kanavkin/Tuareg_hw/tndf13/schematics/IMG_4141.JPG

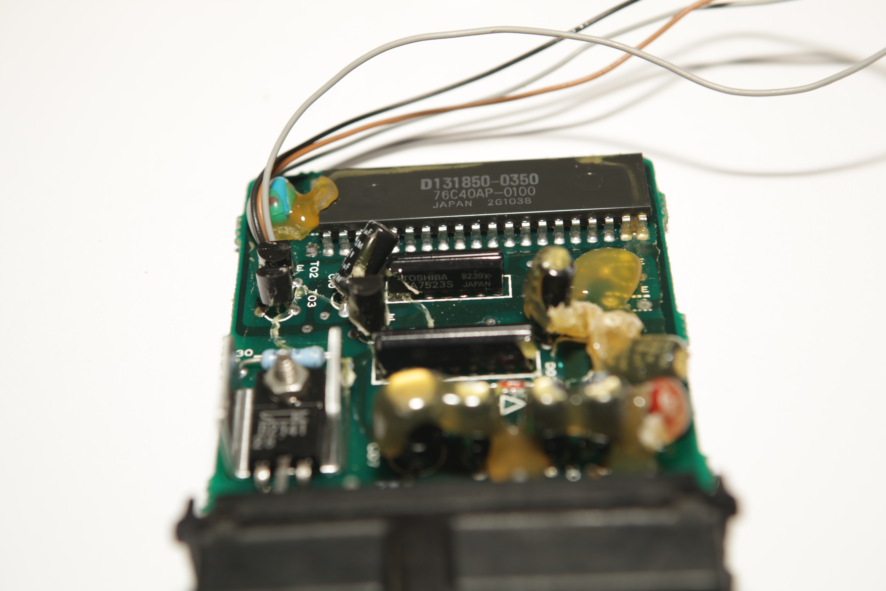
tndf13/schematics/IMG_4141.JPG
