kanavkin/Tuareg_hw/output/3d/bot.jpg

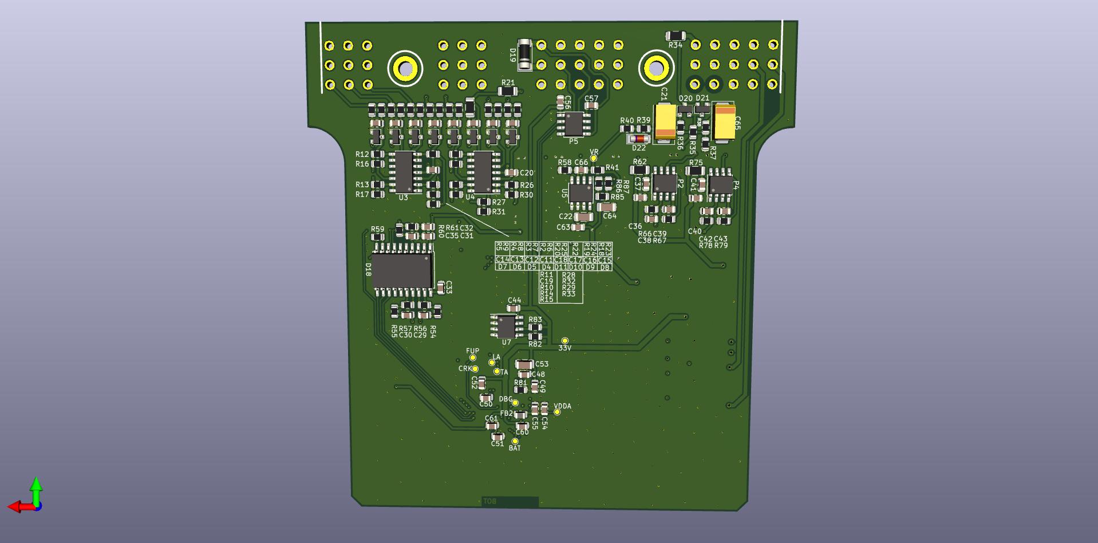
output/3d/bot.jpg
