kanavkin/Tuareg_hw/datasheets/2- and 4-Layer Design Rules | AISLER_files/design_rules.png

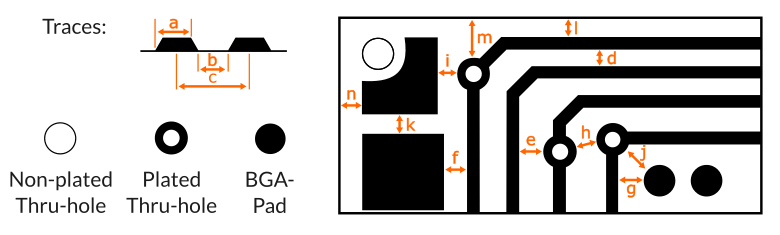
datasheets/2- and 4-Layer Design Rules | AISLER_files/design_rules.png
