kanavkin/Tuareg_hw/output/3d/top.jpeg

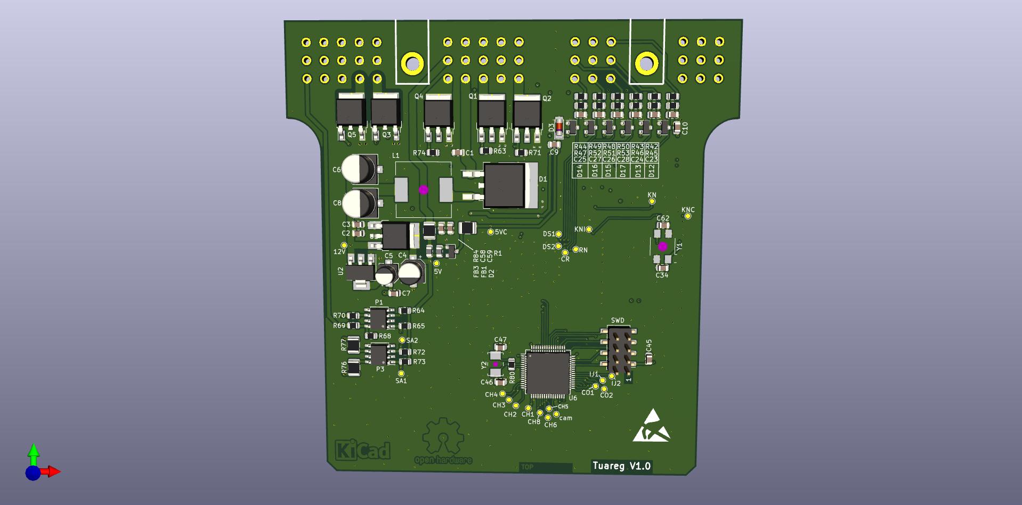
output/3d/top.jpeg
