kanavkin/Tuareg_hw/tndf13/coil_vs_output_signal_2ms.png

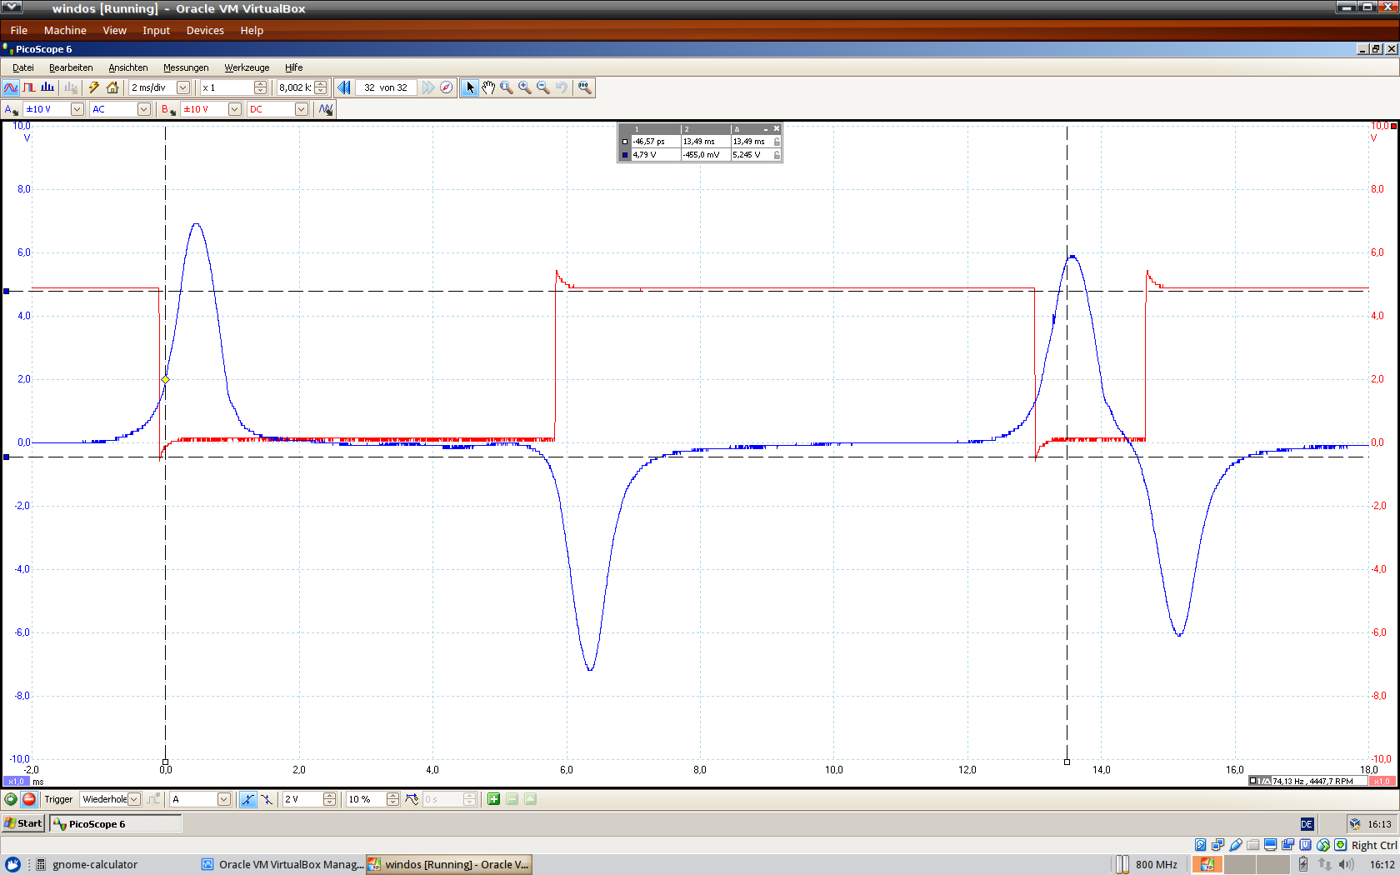
tndf13/coil_vs_output_signal_2ms.png
