kanavkin/Tuareg_hw/tndf13/crank_vs_coil_6300rpm_2ms.jpg

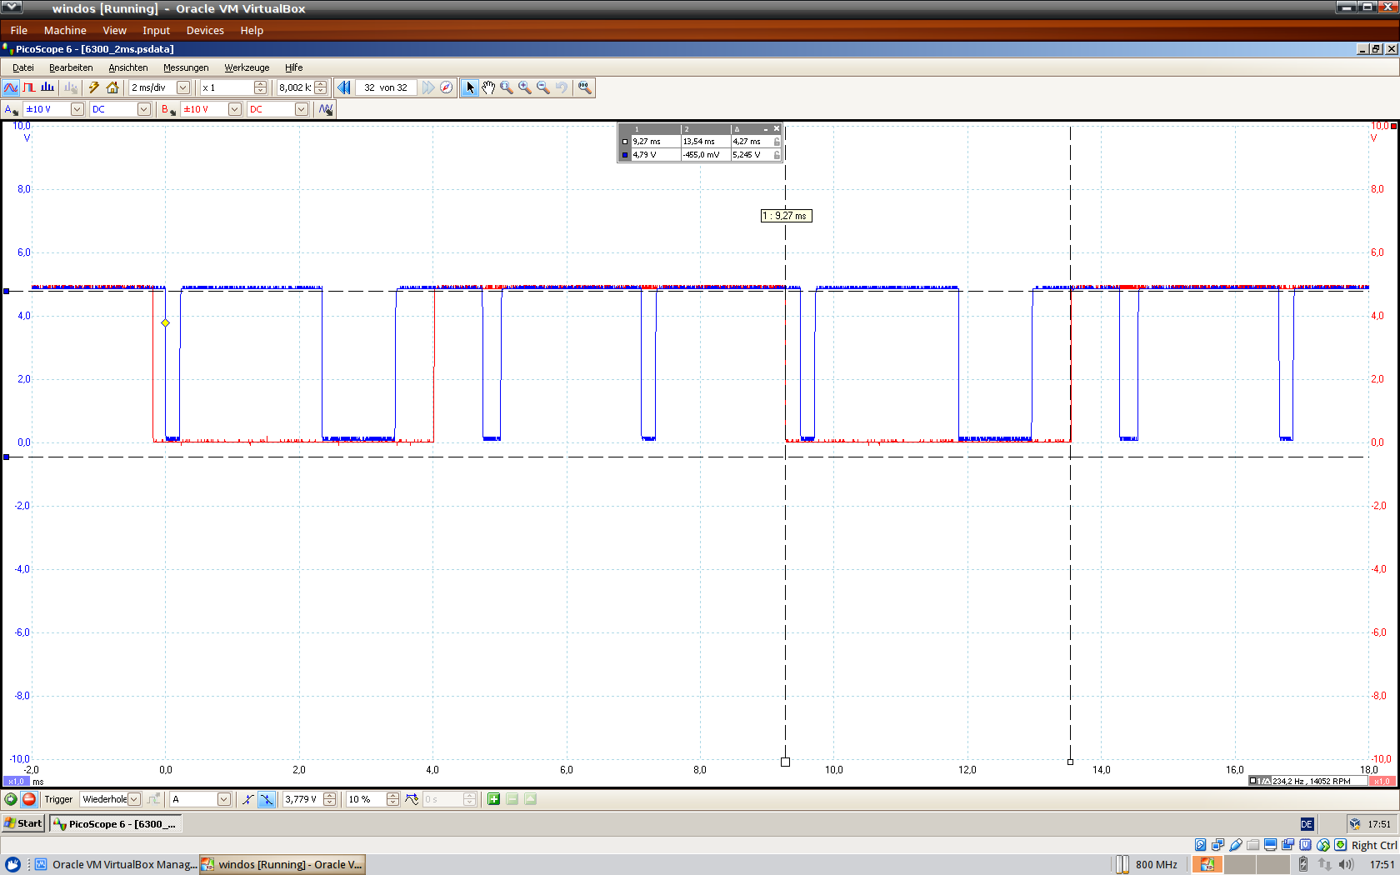
tndf13/crank_vs_coil_6300rpm_2ms.jpg
