kanavkin/Tuareg_hw/tndf13/geometry.png

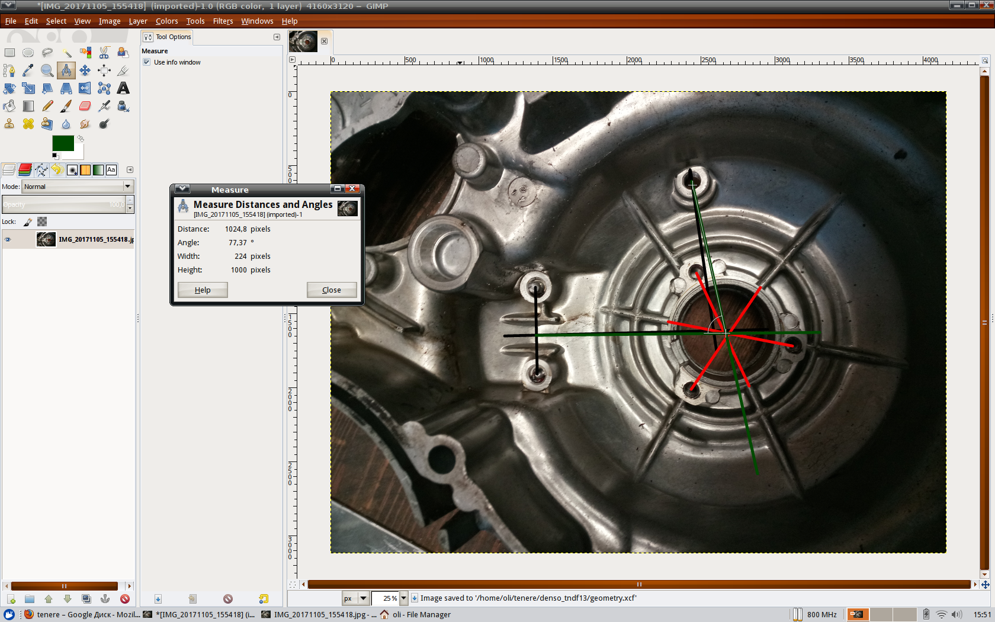
tndf13/geometry.png
