kanavkin/Tuareg_hw/tndf13/spark_vs_transistor.png

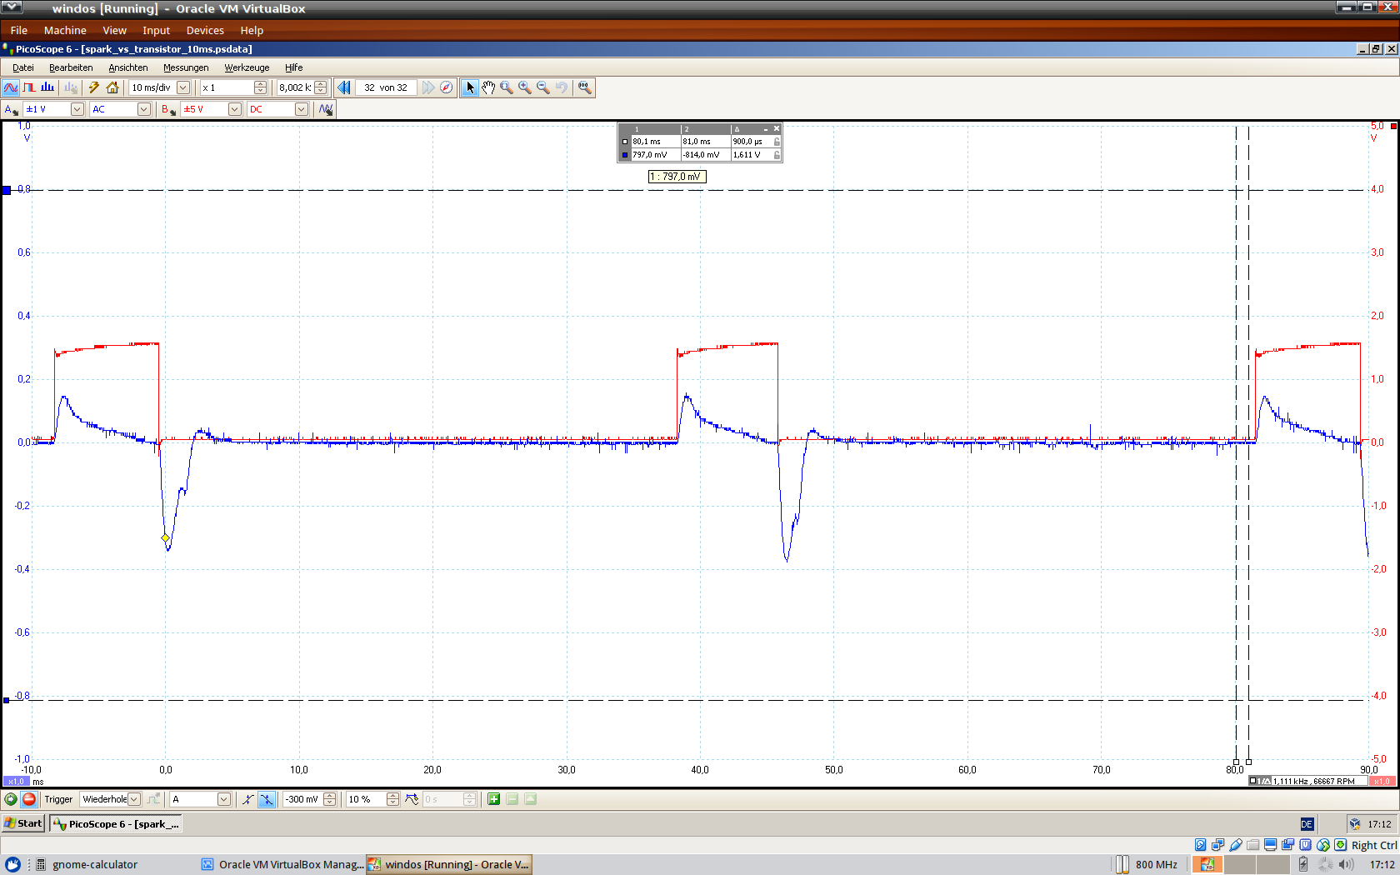
tndf13/spark_vs_transistor.png
