kanavkin/Tuareg_hw/tndf13/timing_advance.png

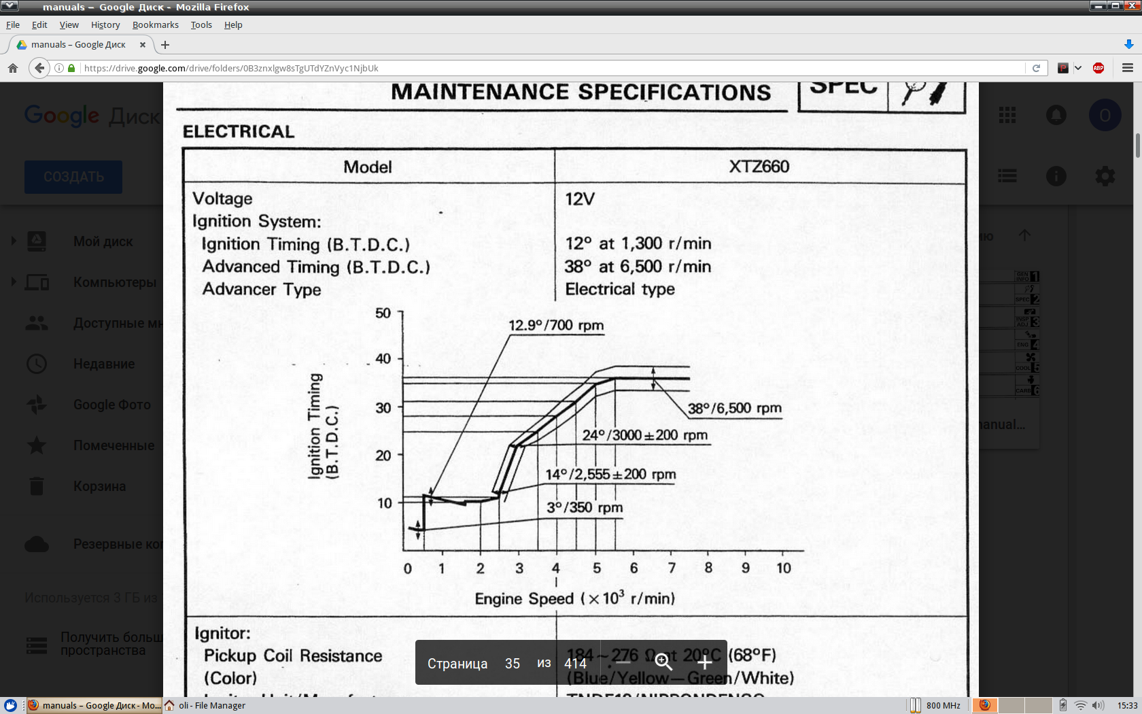
tndf13/timing_advance.png
