kanavkin/Tuareg_hw/tndf13/coil_vs_output_signal_2ms_measure_highrev_5.png

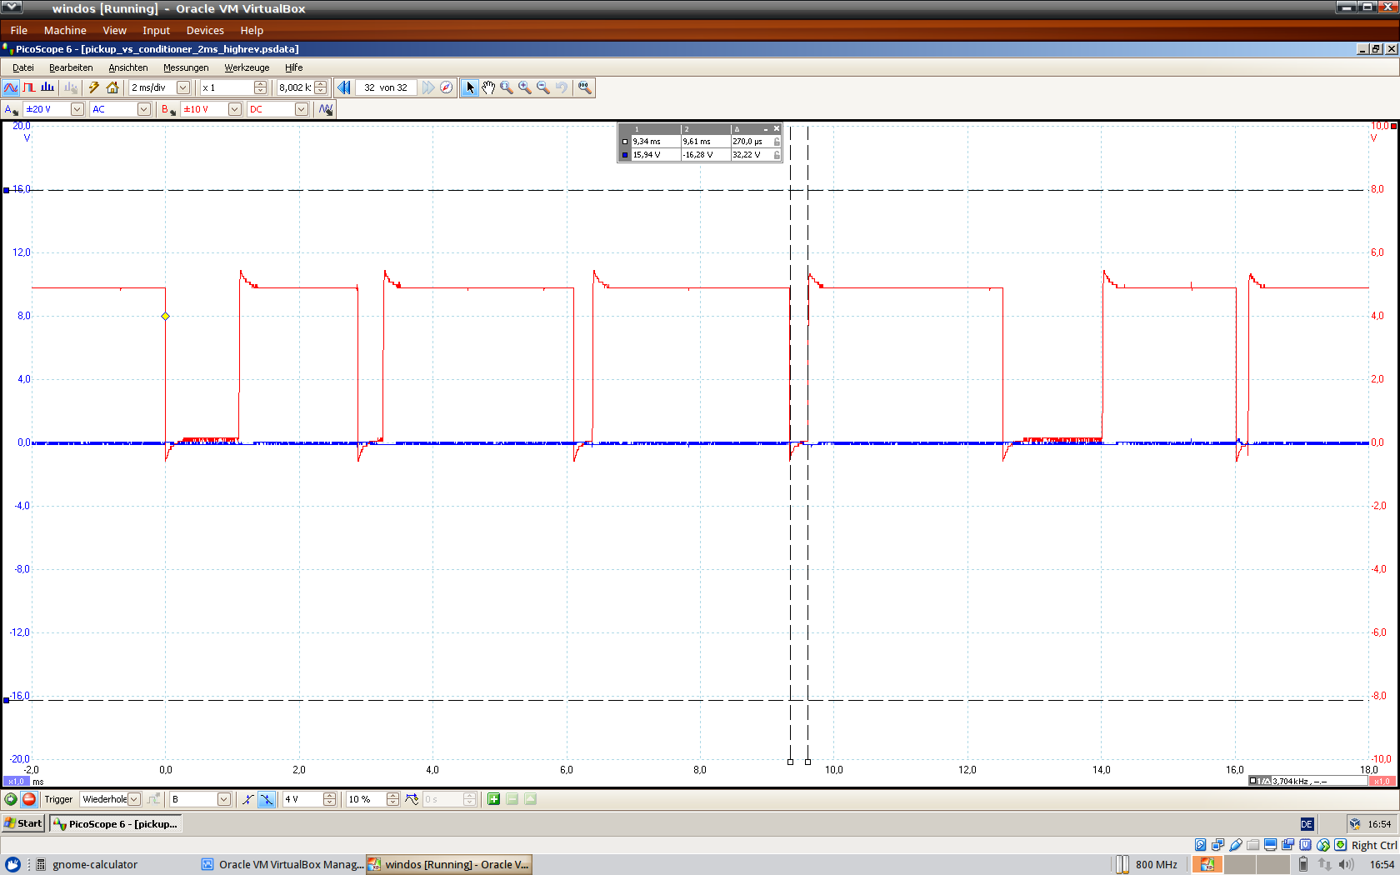
tndf13/coil_vs_output_signal_2ms_measure_highrev_5.png
