kanavkin/Tuareg_hw/tndf13/coil_vs_output_signal_5ms_measure_2.png

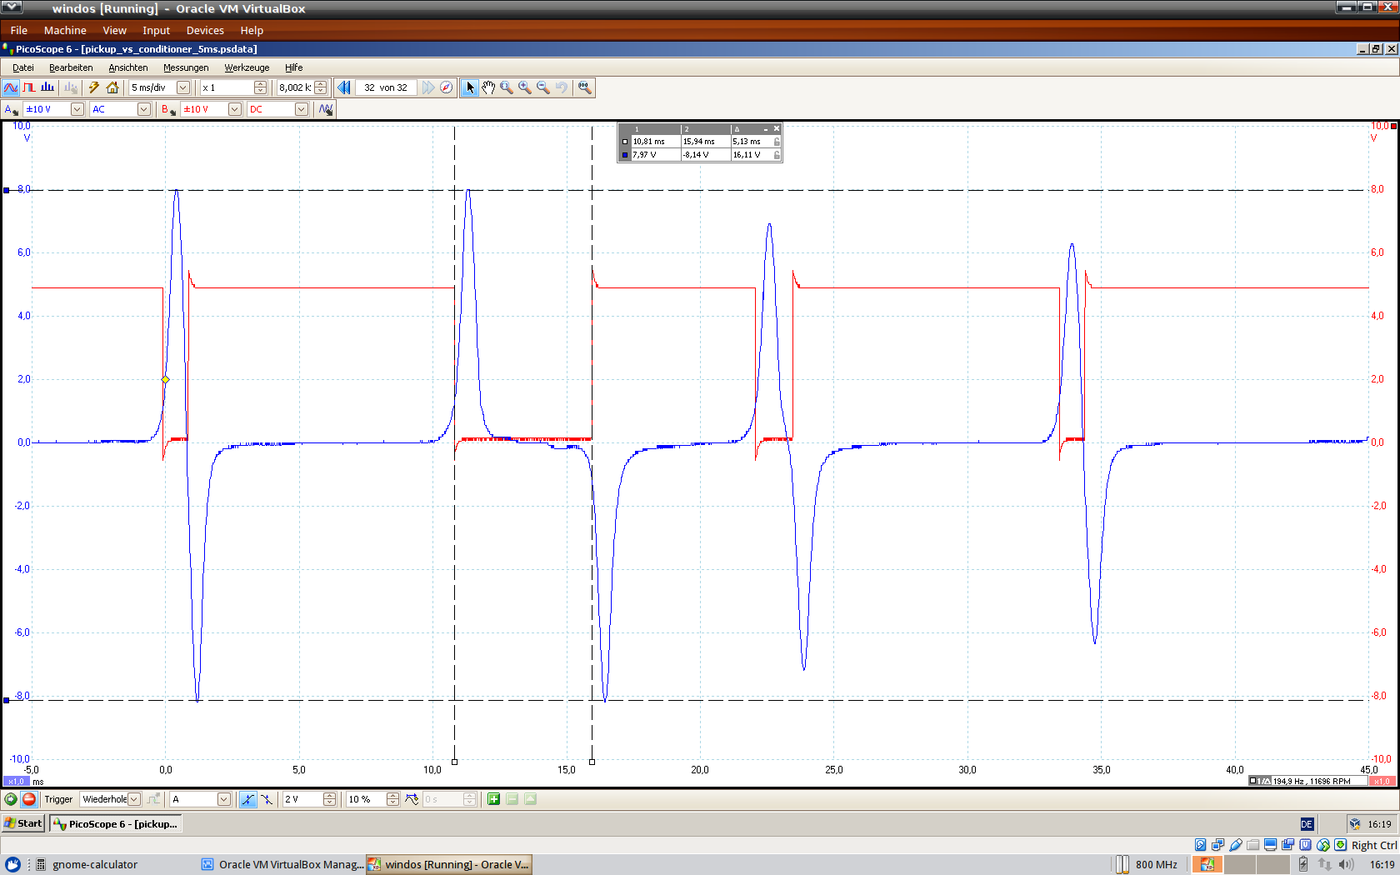
tndf13/coil_vs_output_signal_5ms_measure_2.png
