kanavkin/Tuareg_hw/tndf13/coil_vs_output_signal_5ms_measure_4.png

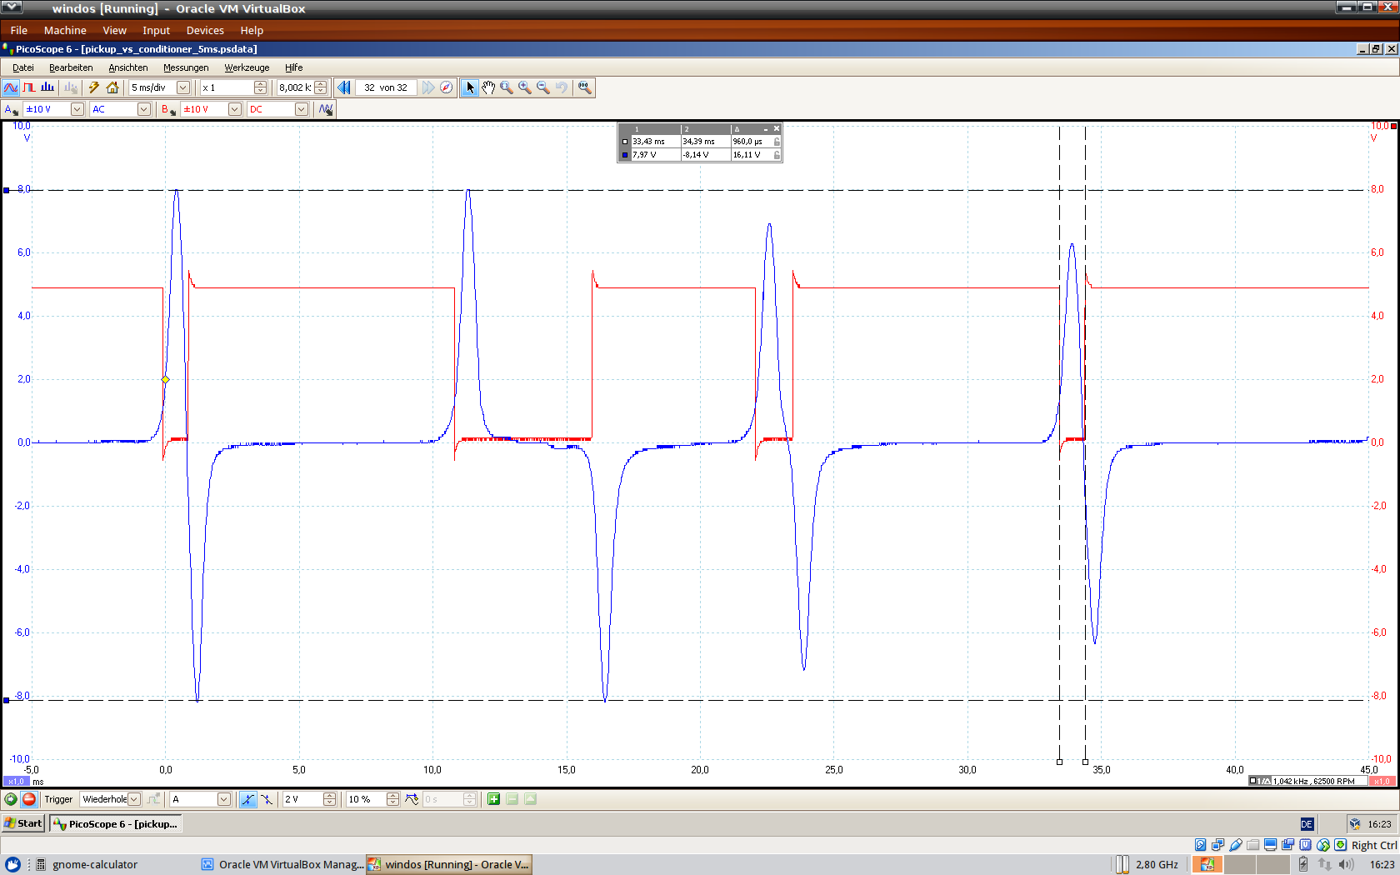
tndf13/coil_vs_output_signal_5ms_measure_4.png
