kanavkin/Tuareg_hw/tndf13/coil_vs_output_signal_10ms_measure_3.png

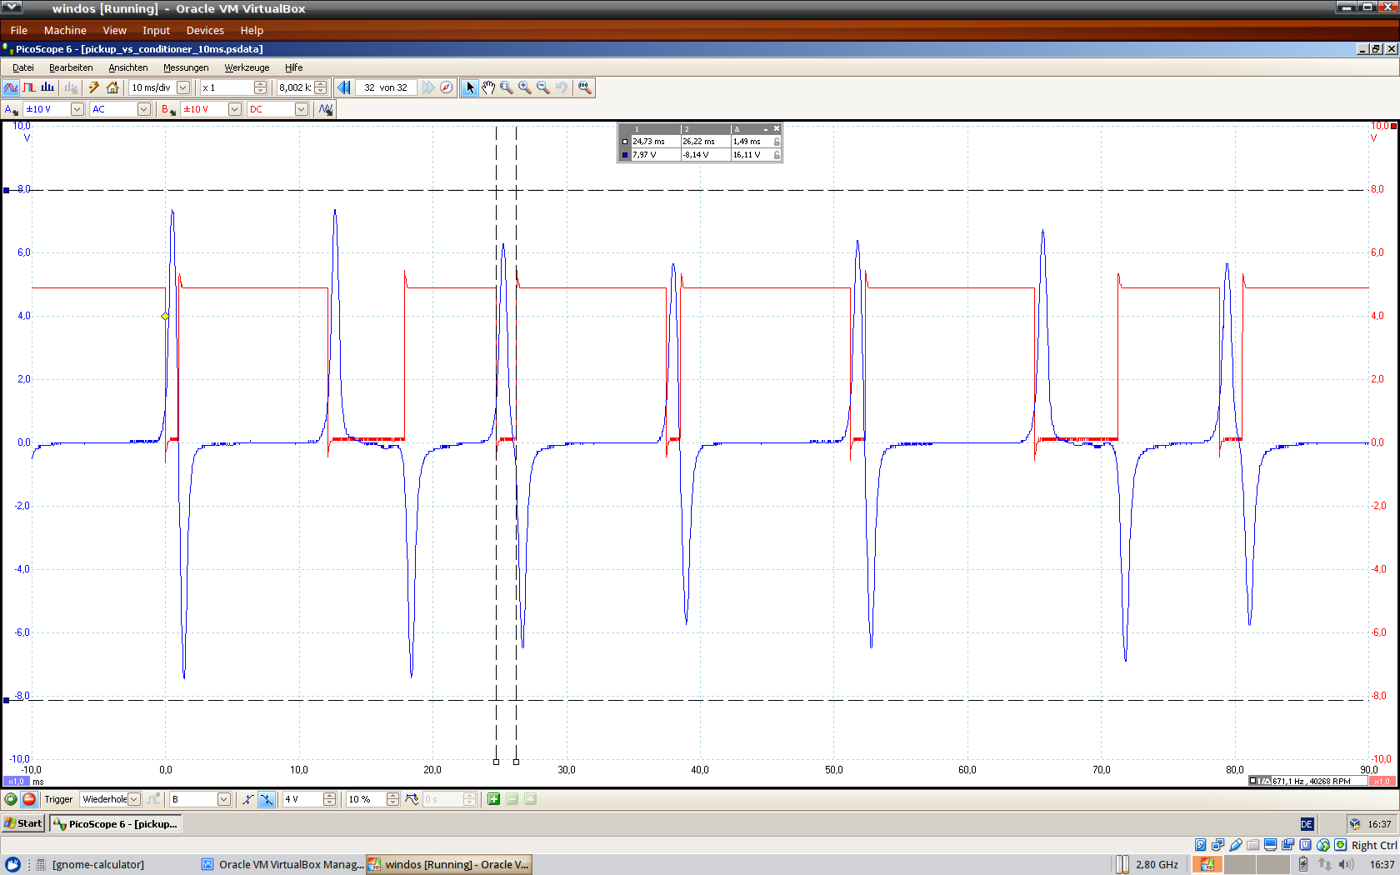
tndf13/coil_vs_output_signal_10ms_measure_3.png
