kanavkin/Tuareg_hw/tndf13/conditioner_vs_transistor_2ms_measure_2.png

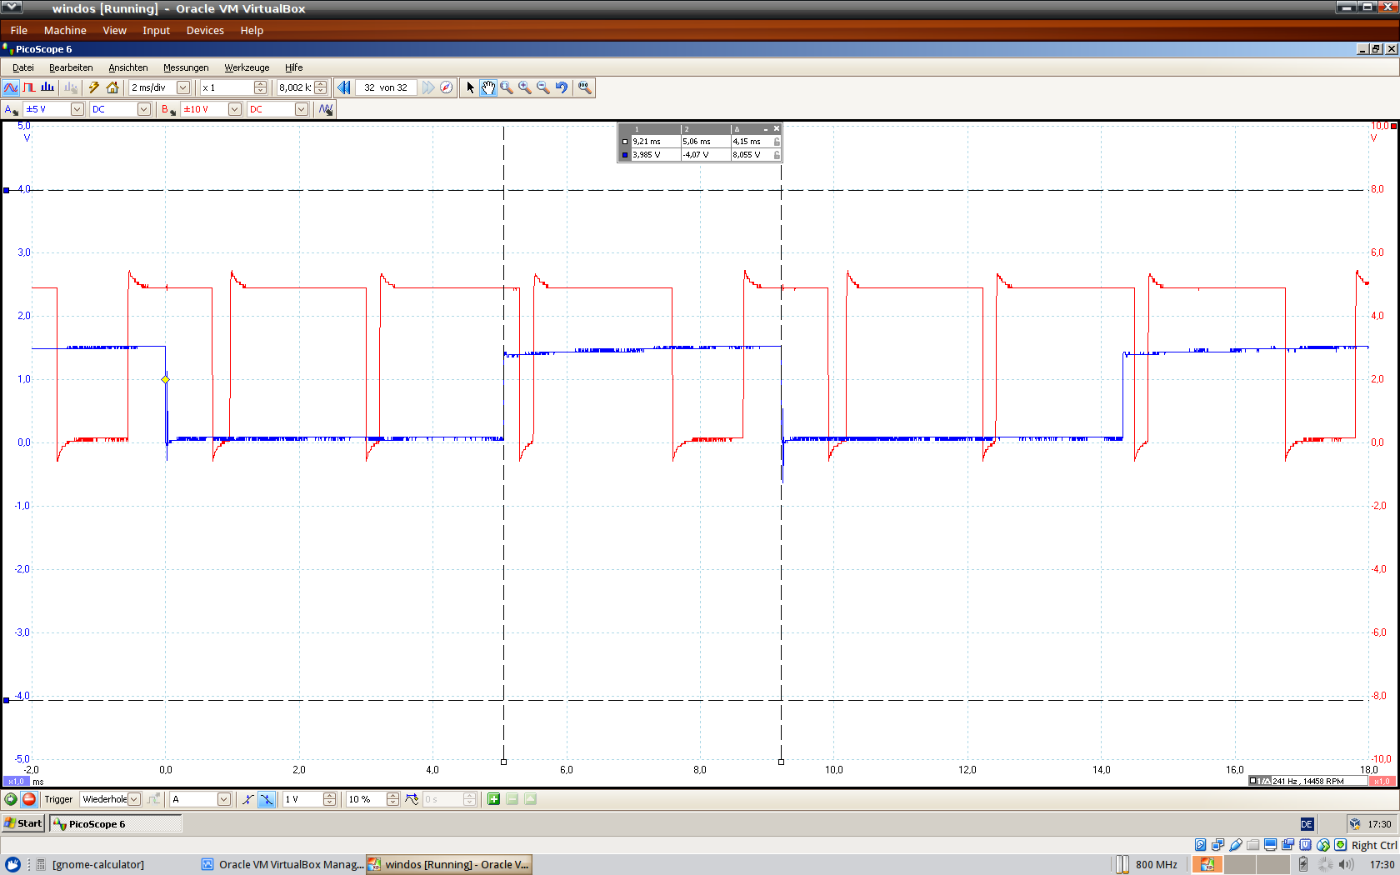
tndf13/conditioner_vs_transistor_2ms_measure_2.png
