kanavkin/Tuareg_hw/tndf13/conditioner_vs_transistor_5ms_measure.png

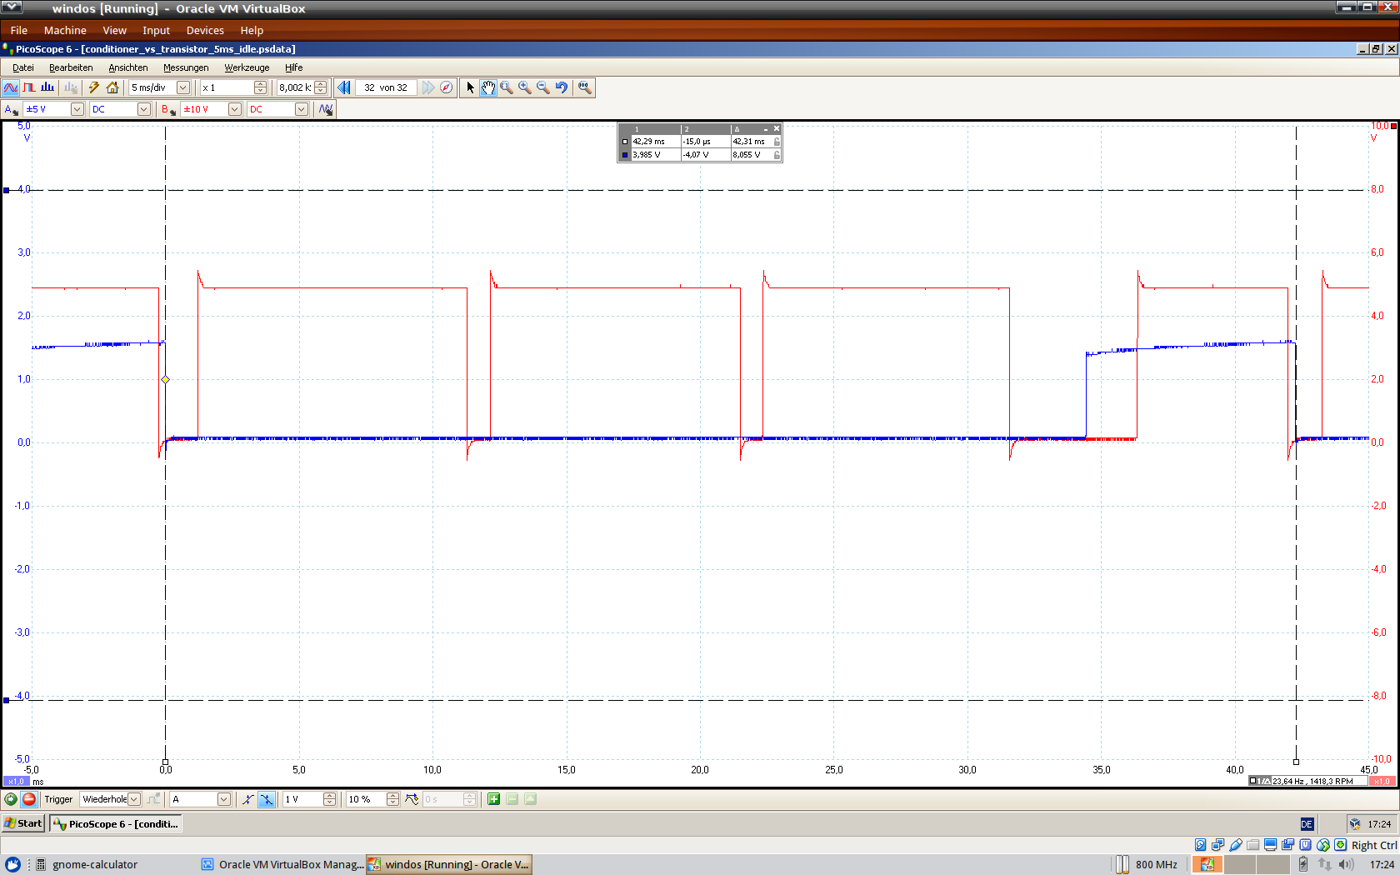
tndf13/conditioner_vs_transistor_5ms_measure.png
