kanavkin/Tuareg_hw/tndf13/measurement_orig/diode_idle.png

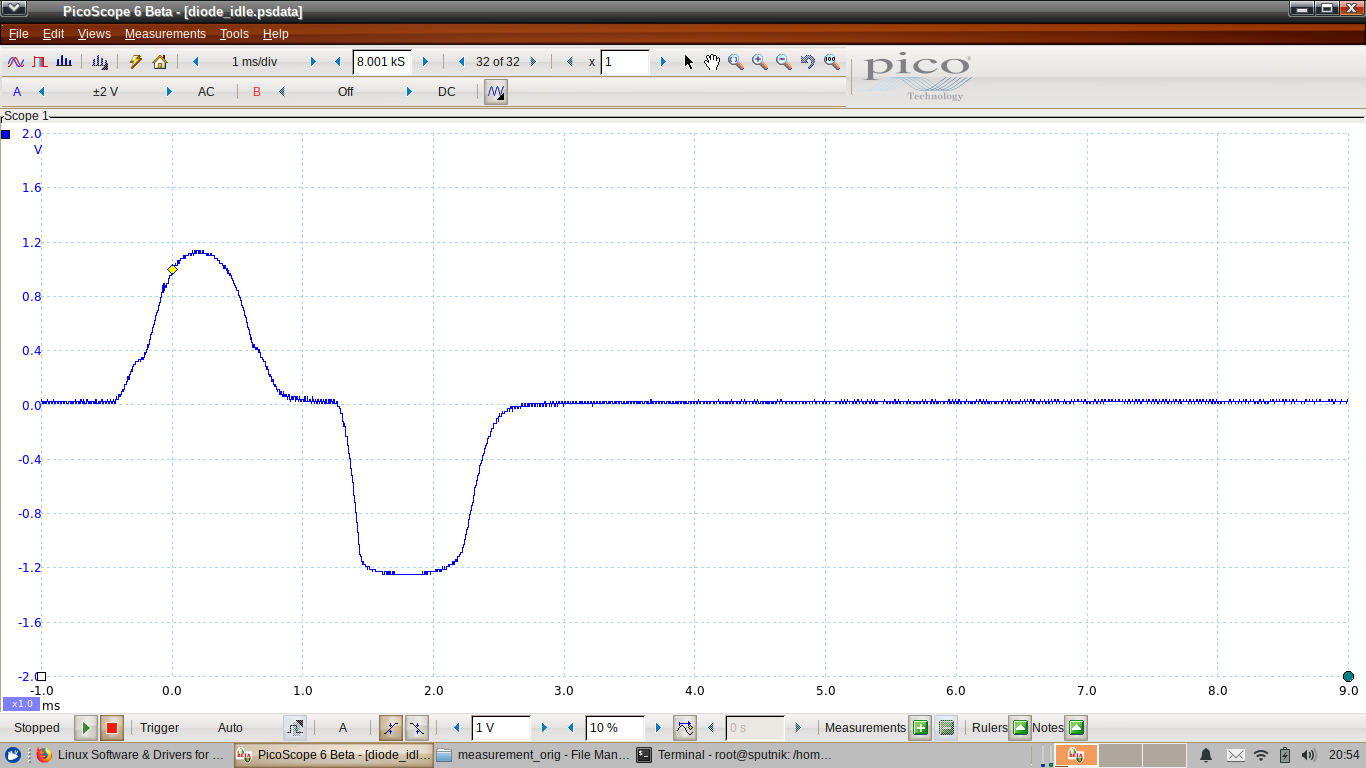
tndf13/measurement_orig/diode_idle.png
