kanavkin/Tuareg_hw/tndf13/measurement_orig/diode_idle_dcmode.png

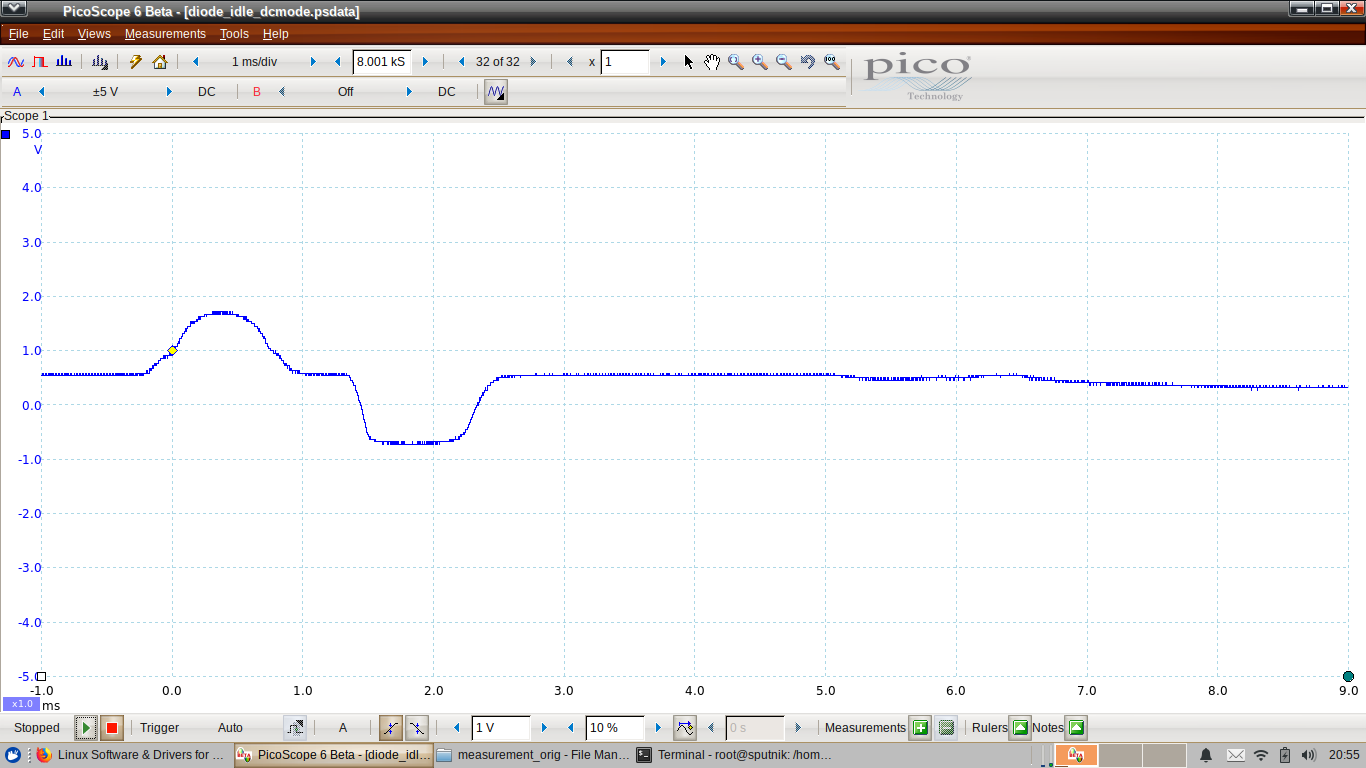
tndf13/measurement_orig/diode_idle_dcmode.png
