kanavkin/Tuareg_hw/tndf13/measurement_orig/pickup_idle.png

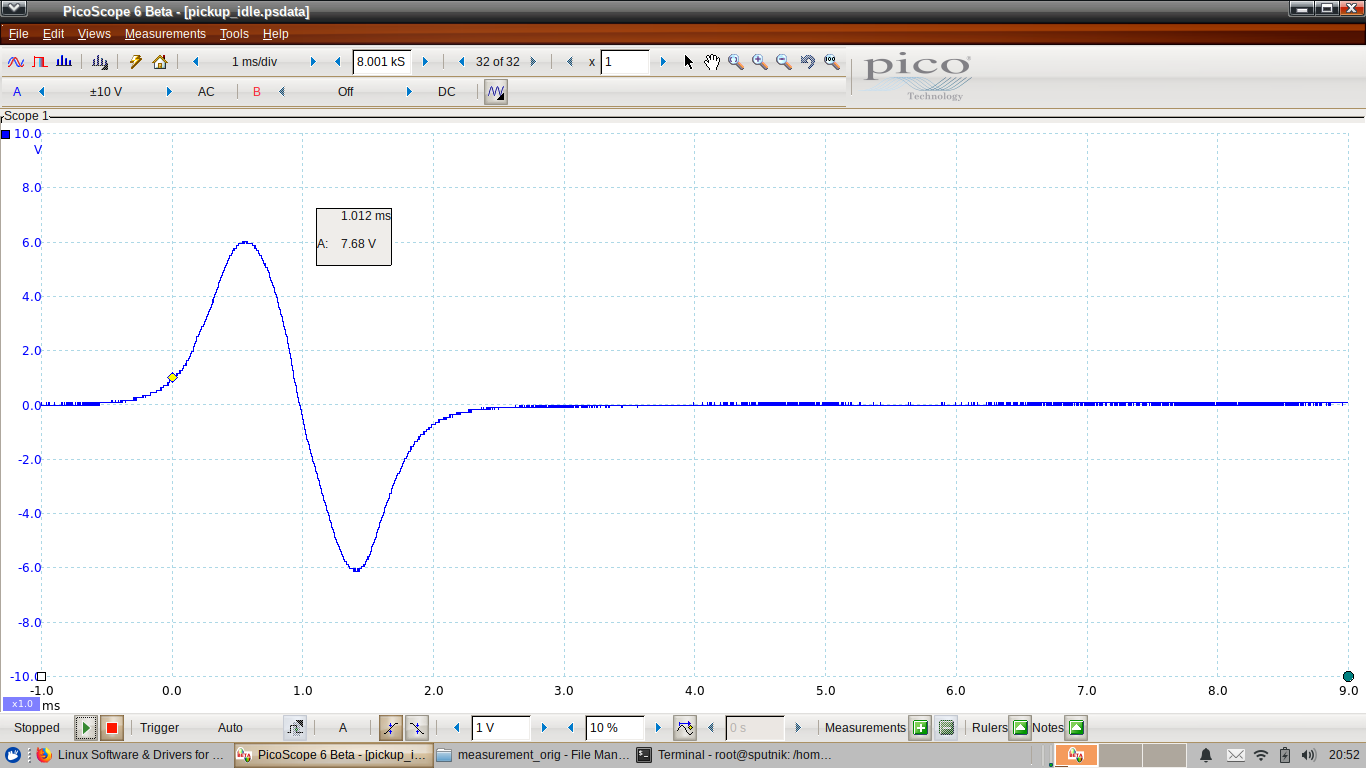
tndf13/measurement_orig/pickup_idle.png
