kanavkin/Tuareg_hw/tndf13/measurement_orig/u-c03c02-junction_idle.png

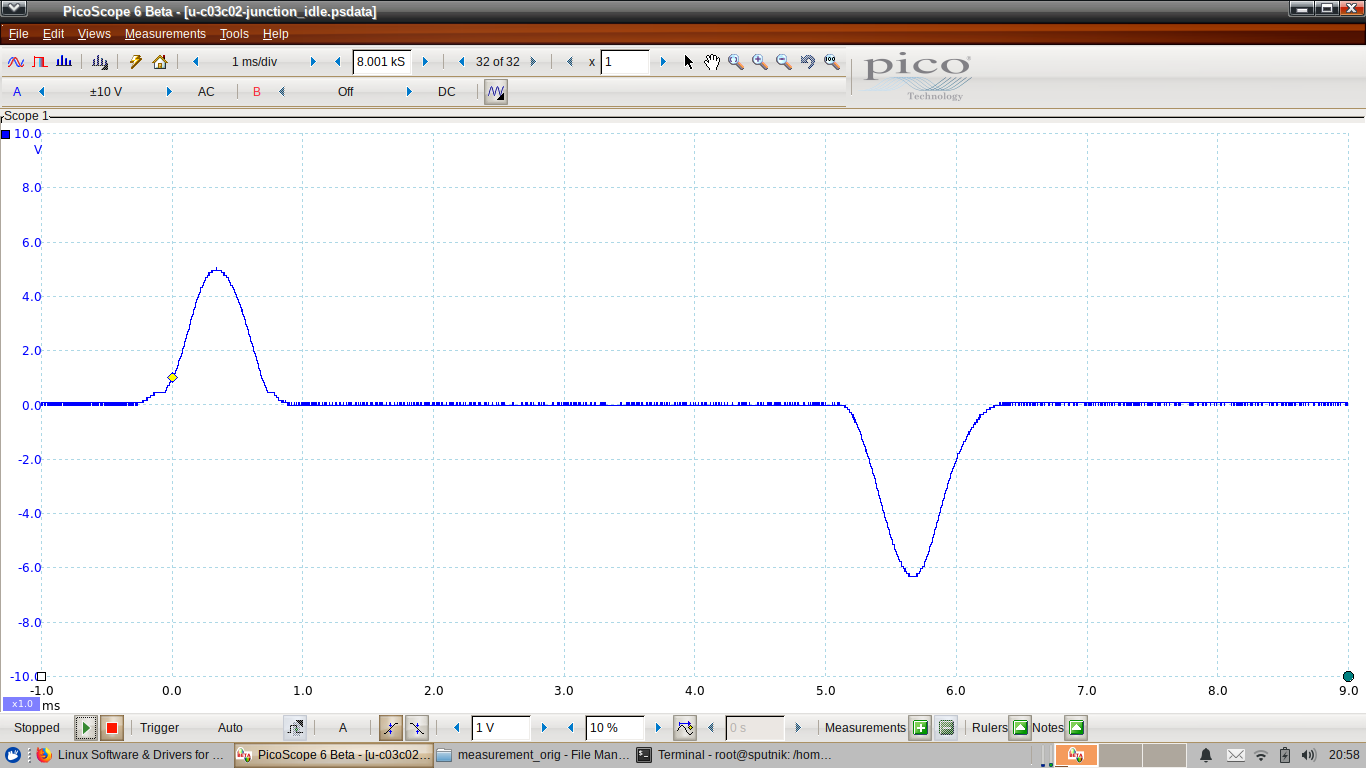
tndf13/measurement_orig/u-c03c02-junction_idle.png
