kanavkin/Tuareg_hw/tndf13/measurement_orig/u-r02_idle.png

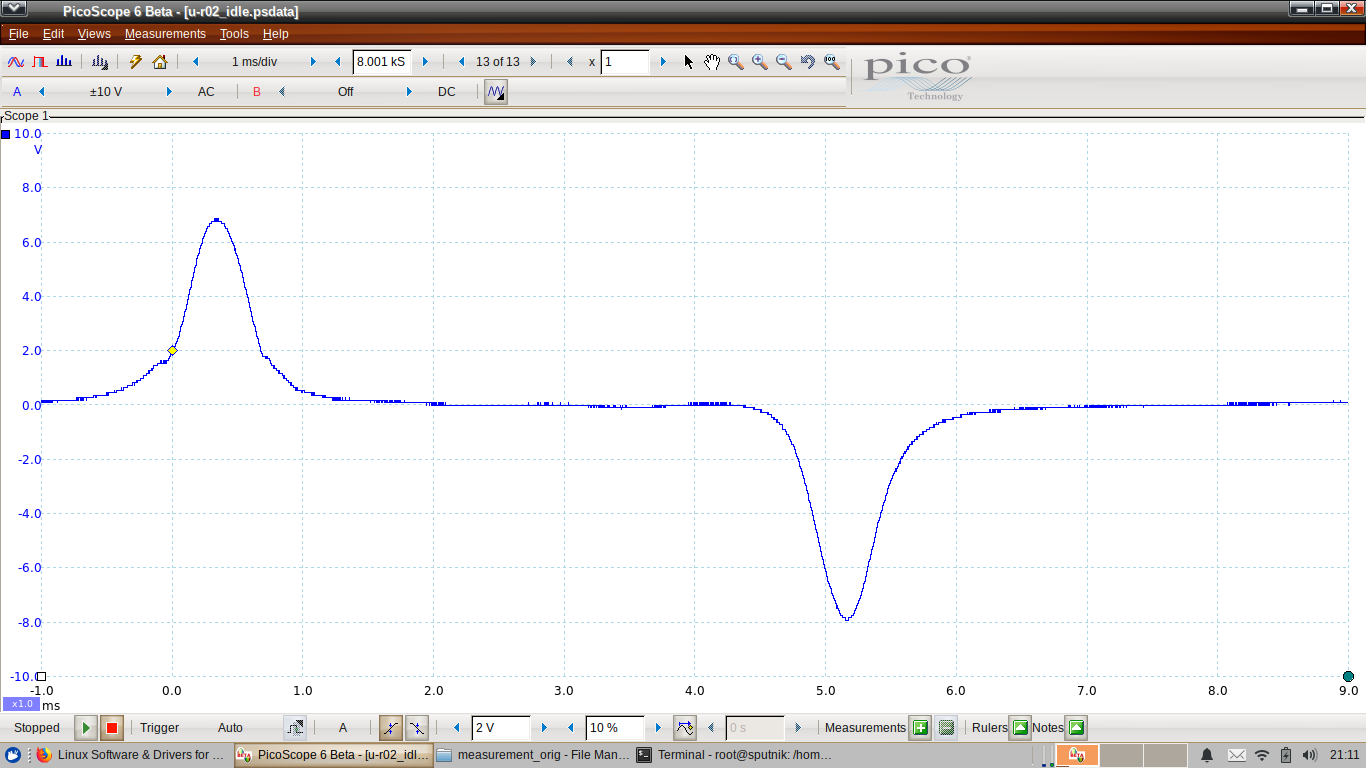
tndf13/measurement_orig/u-r02_idle.png
