kanavkin/Tuareg_hw/tndf13/spark_vs_transistor_10ms_measure_4.png

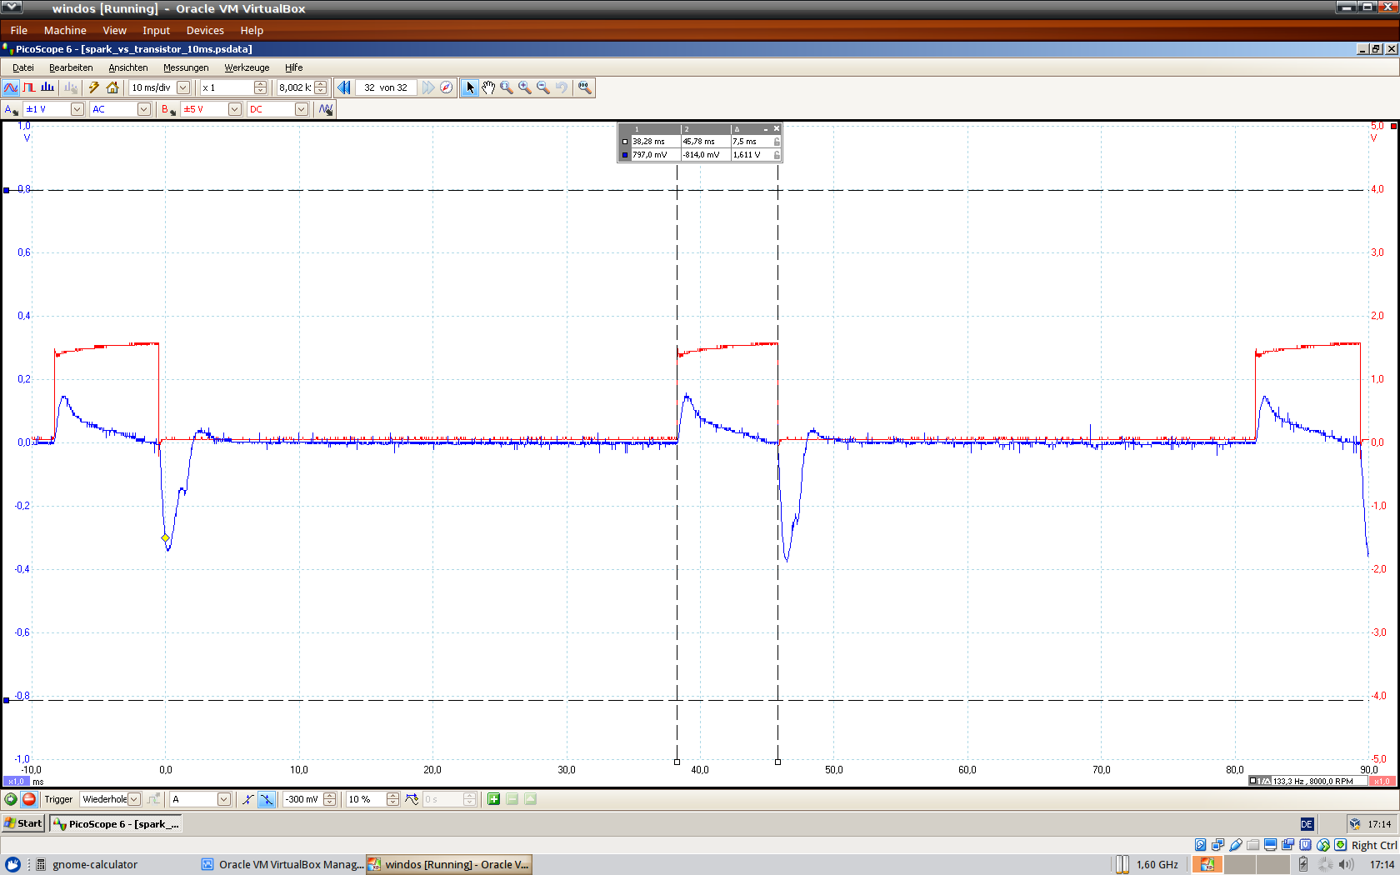
tndf13/spark_vs_transistor_10ms_measure_4.png
