kanavkin/Tuareg_hw/output/pdf/Tuareg.pdf

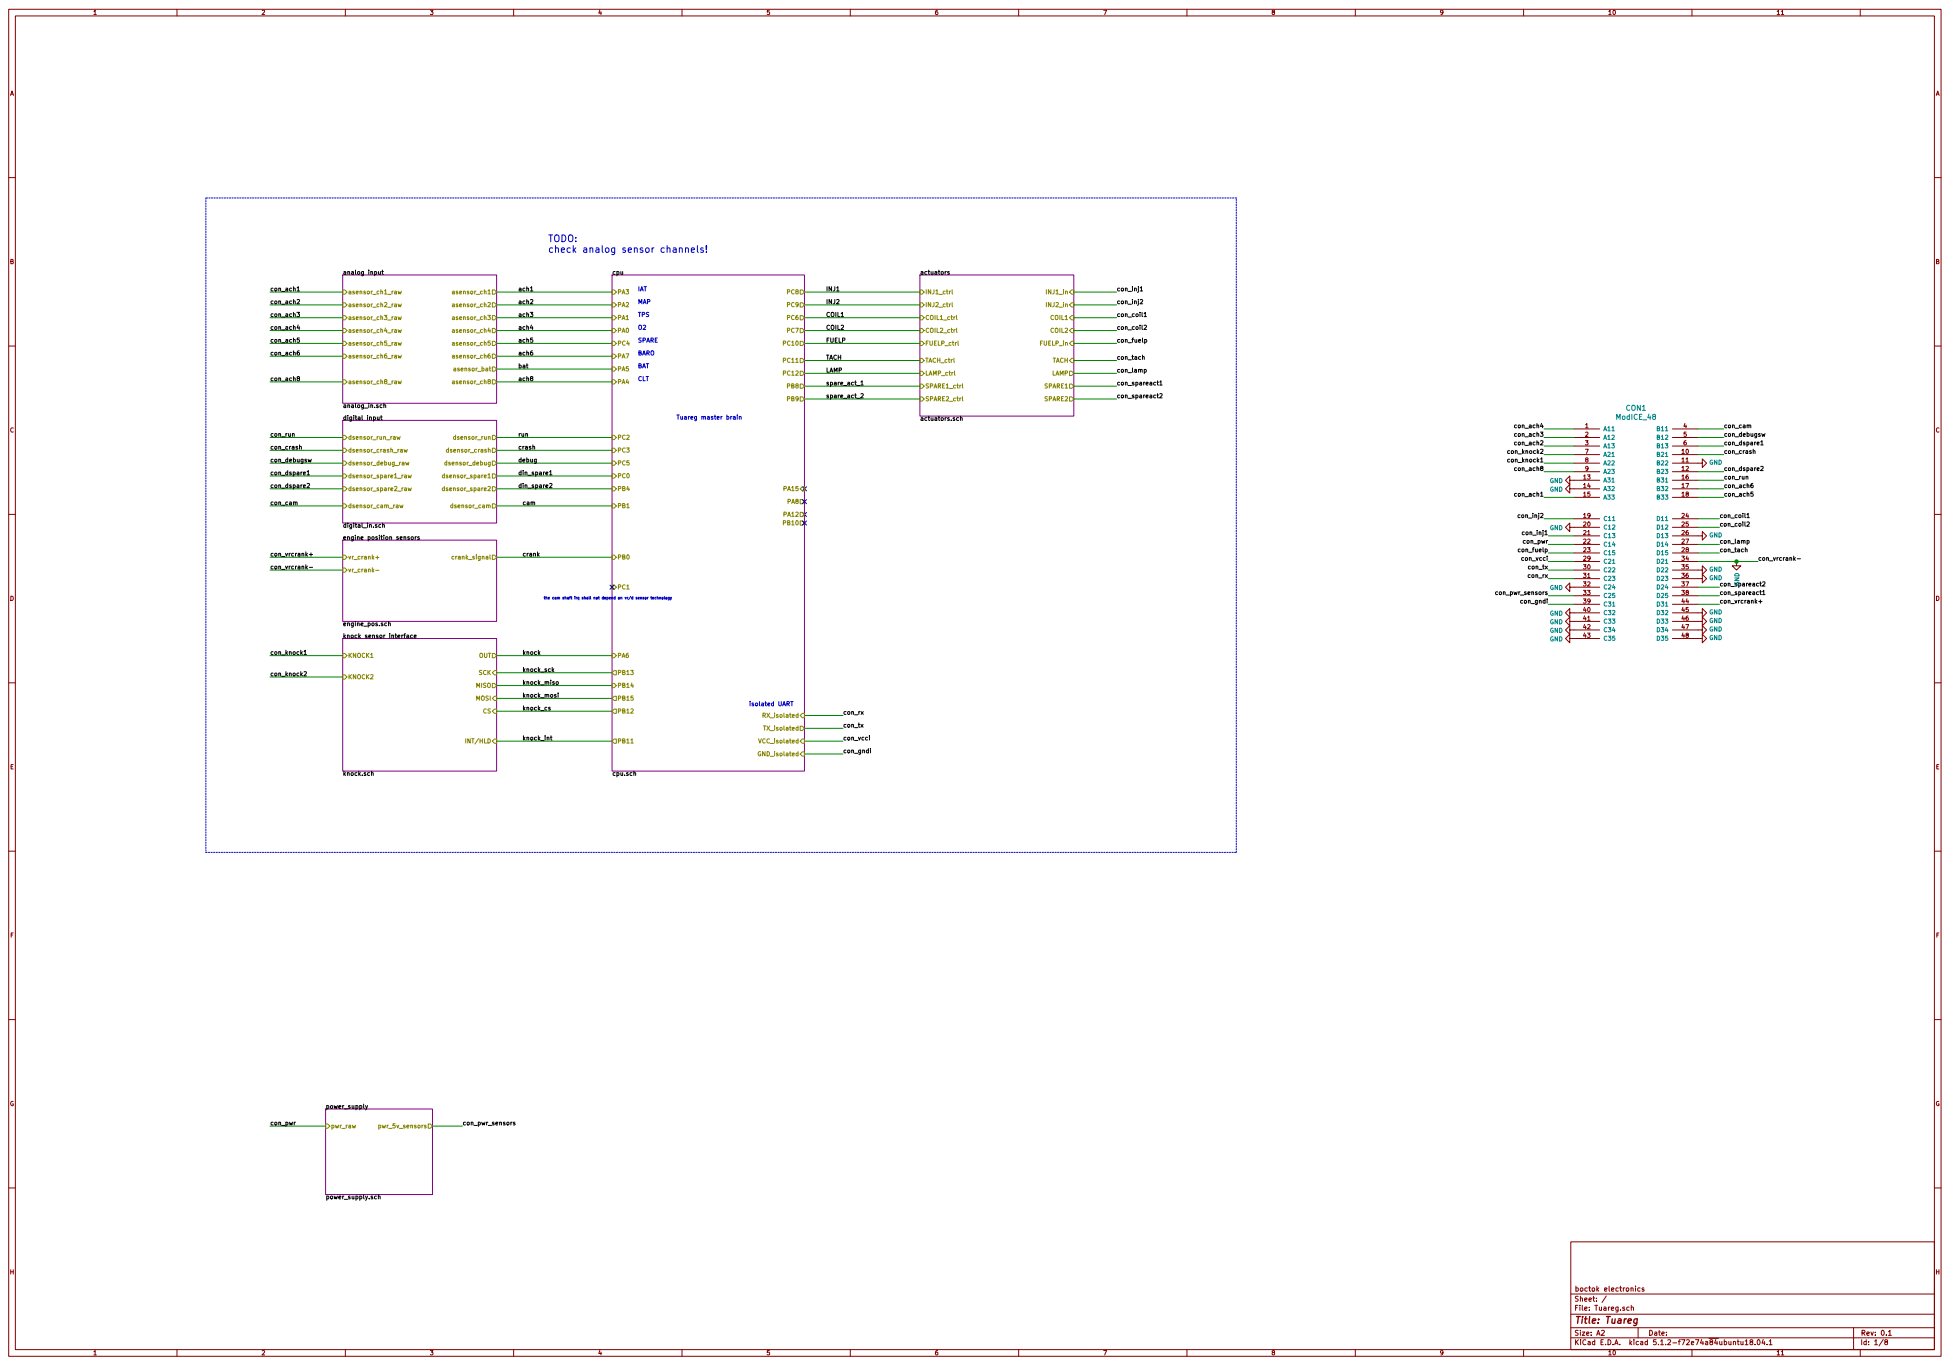
[picture p40: page 1]

SPARE TODO:
check analog sensor channels!

File: Tuareg.sch Sheet: / boctok electronics

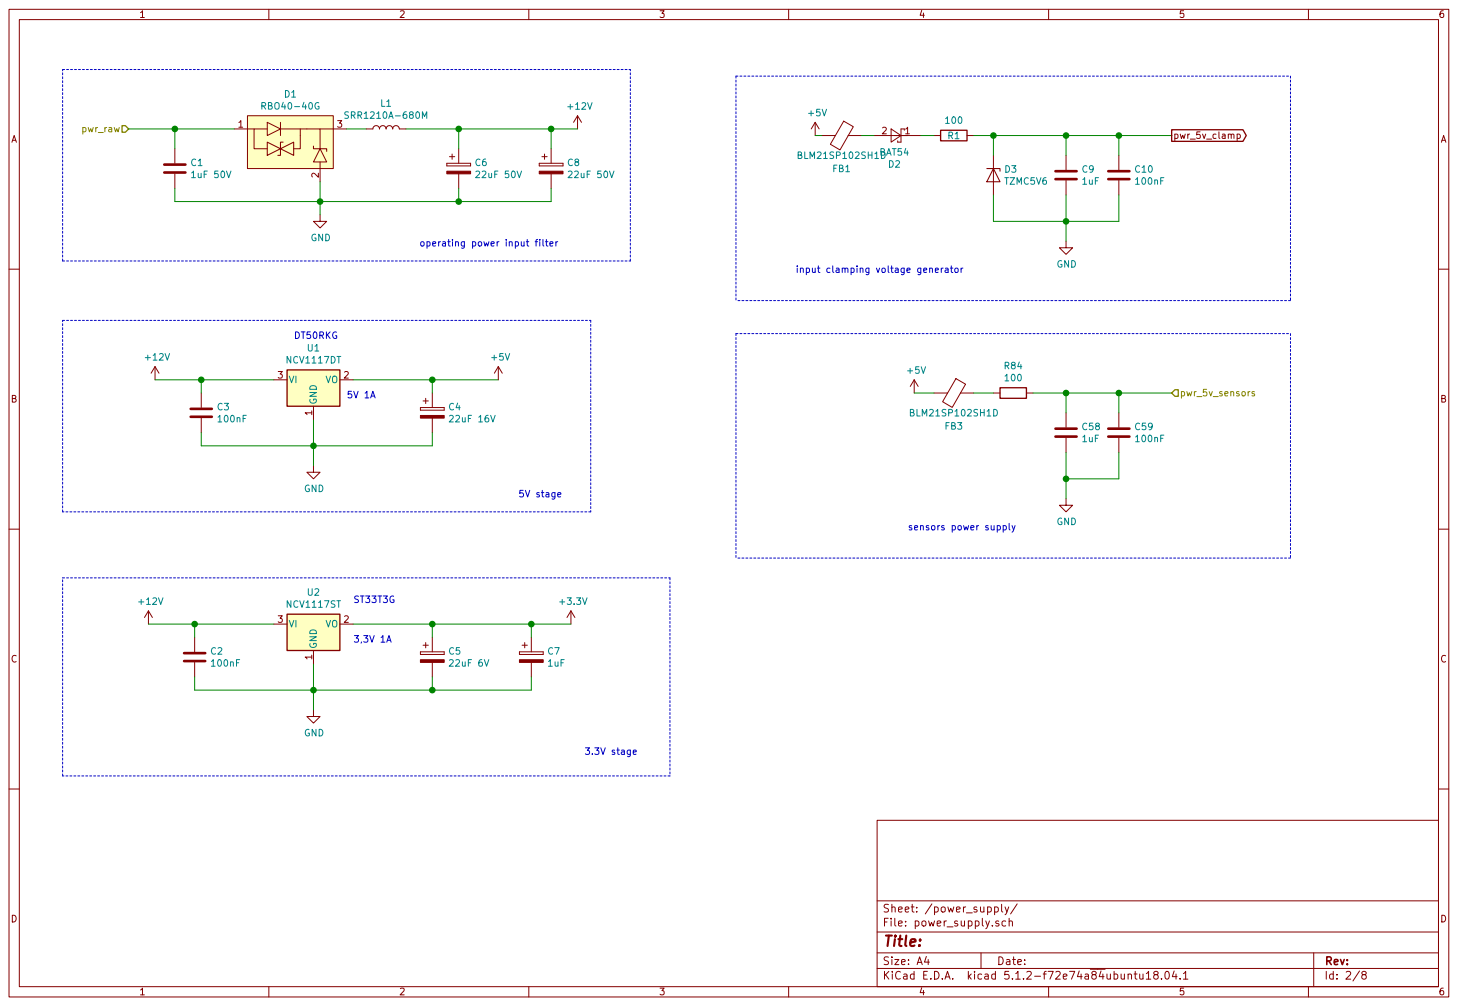
[picture p41: page 2]

input clamping voltage generator +12V

operating power input filter

100nF GND sensors power supply +5V

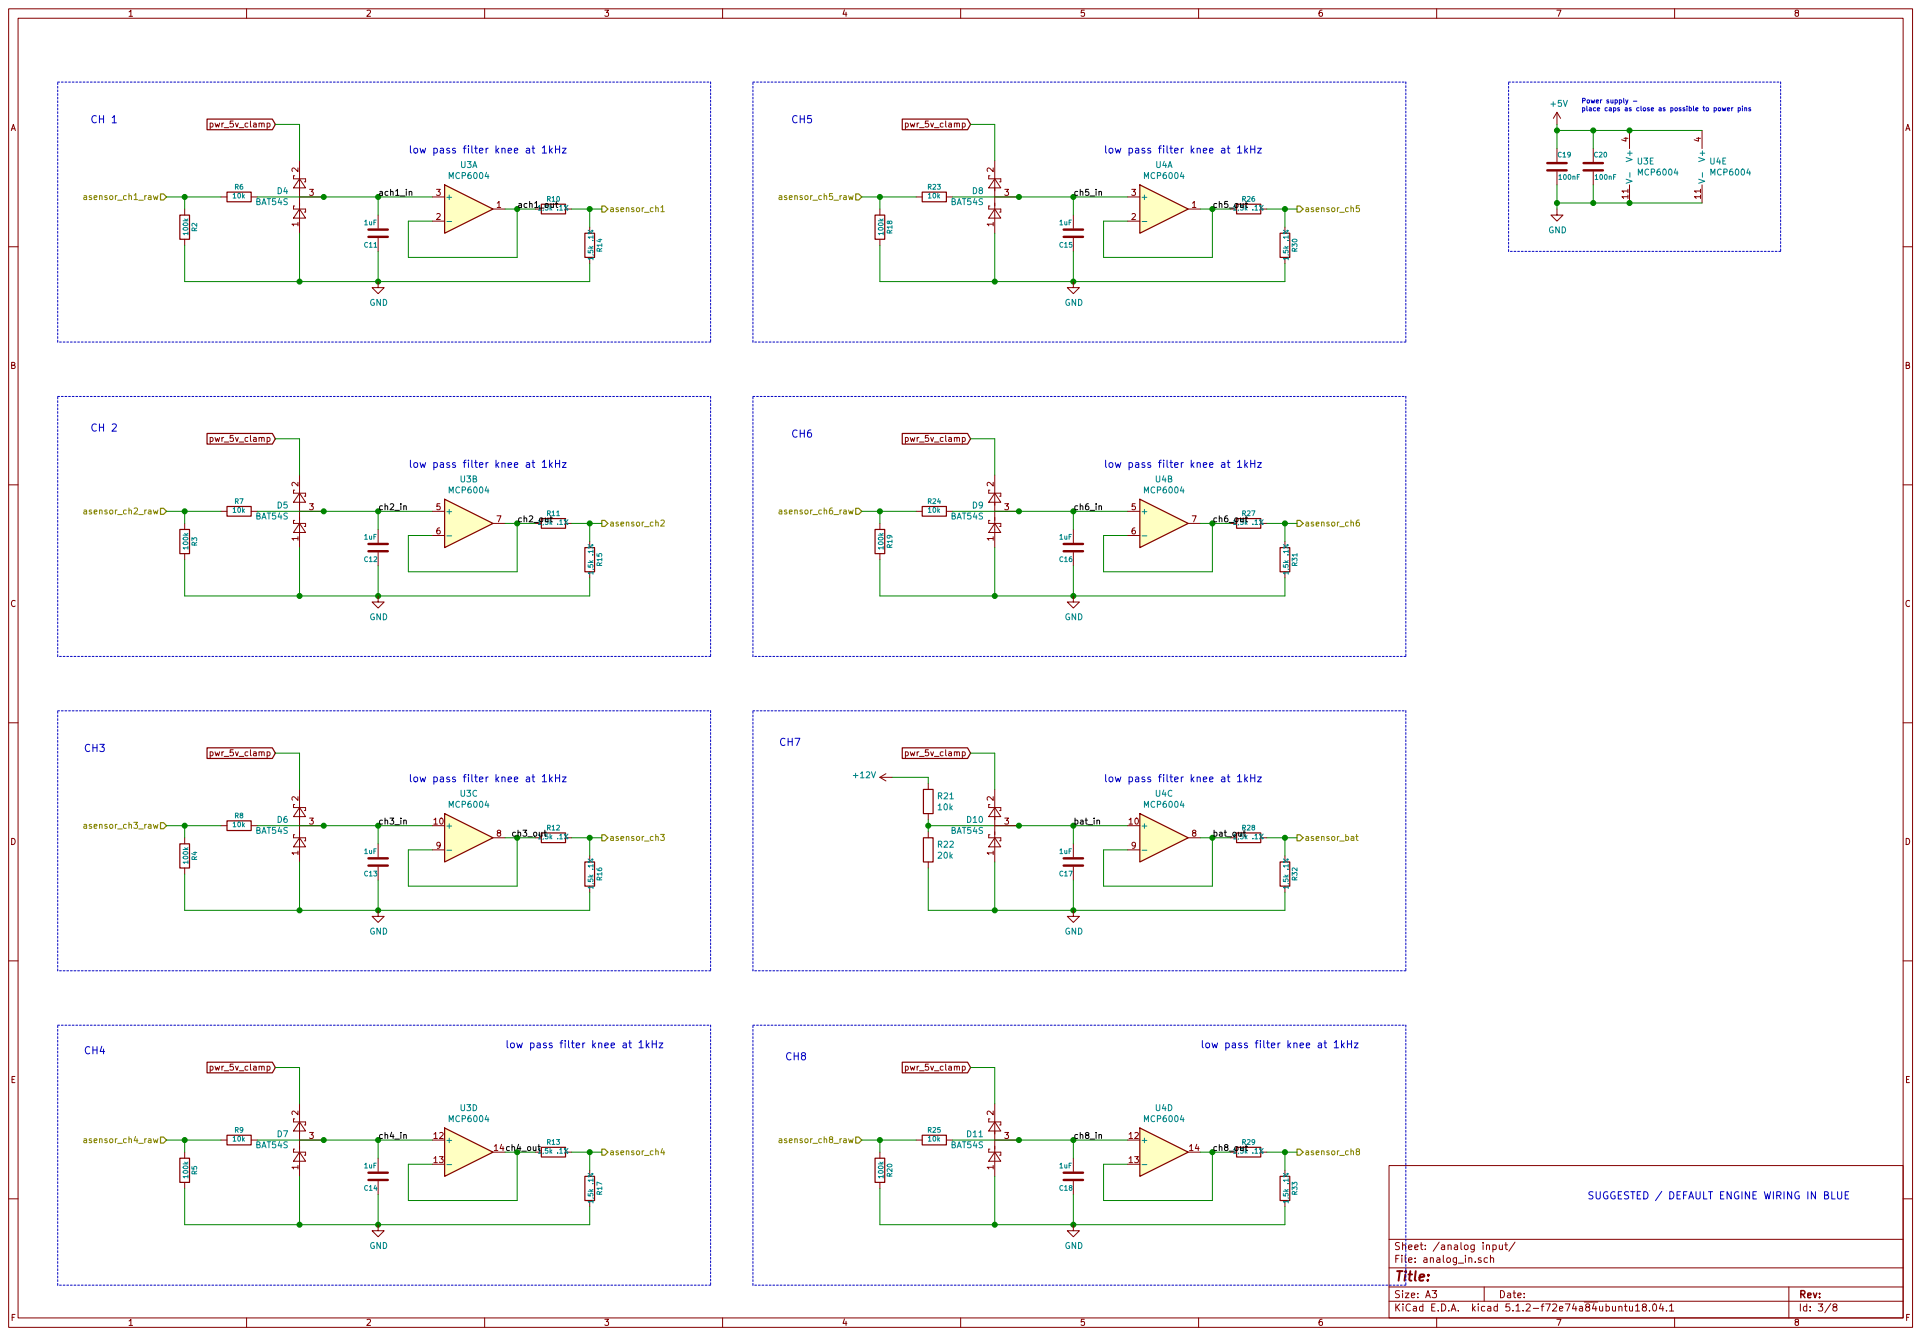
[picture p42: page 3]

4 U4E MCP6004 GND GND GND GND
low pass filter knee at 1kHz C11

low pass filter knee at 1kHz C15

GND GND

low pass filter knee at 1kHz C12
7 U3B MCP6004 +

low pass filter knee at 1kHz C13

low pass filter knee at 1kHz C17
ch8_out bat_out

low pass filter knee at 1kHz C14

low pass filter knee at 1kHz C18

SUGGESTED / DEFAULT ENGINE WIRING IN BLUE

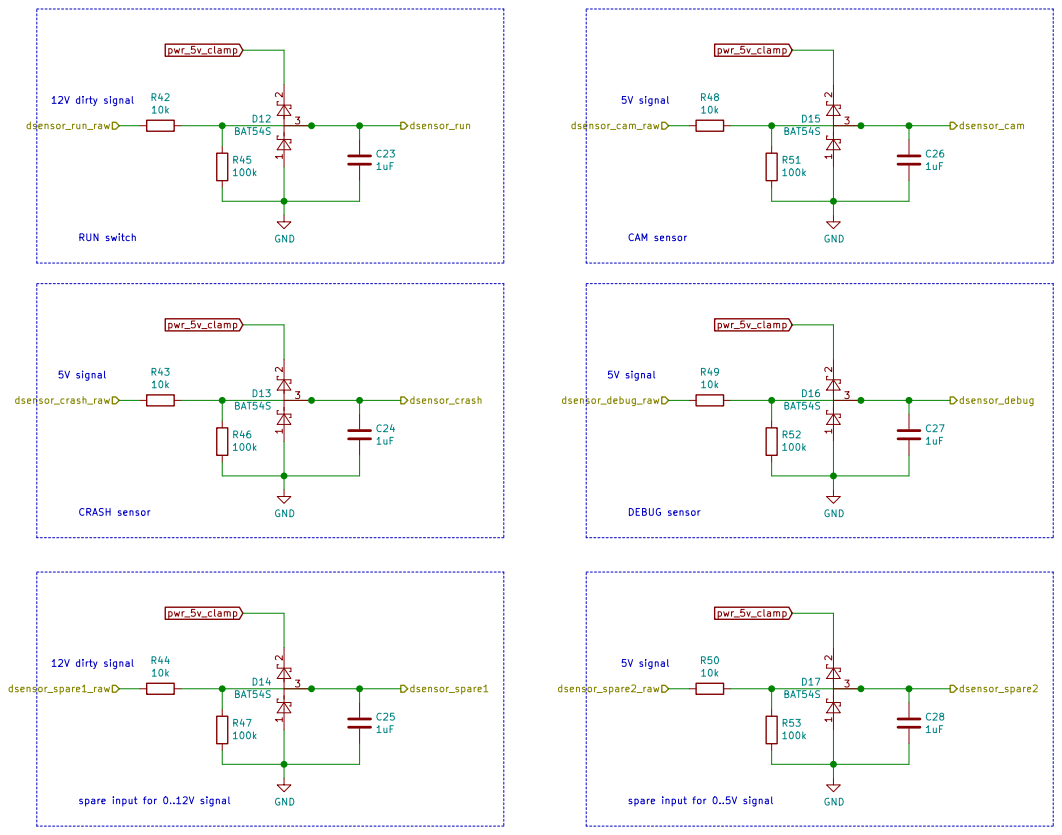
[picture p43: page 4]

CAM sensor 12V dirty signal

spare input for 0..12V signal

spare input for 0..5V signal

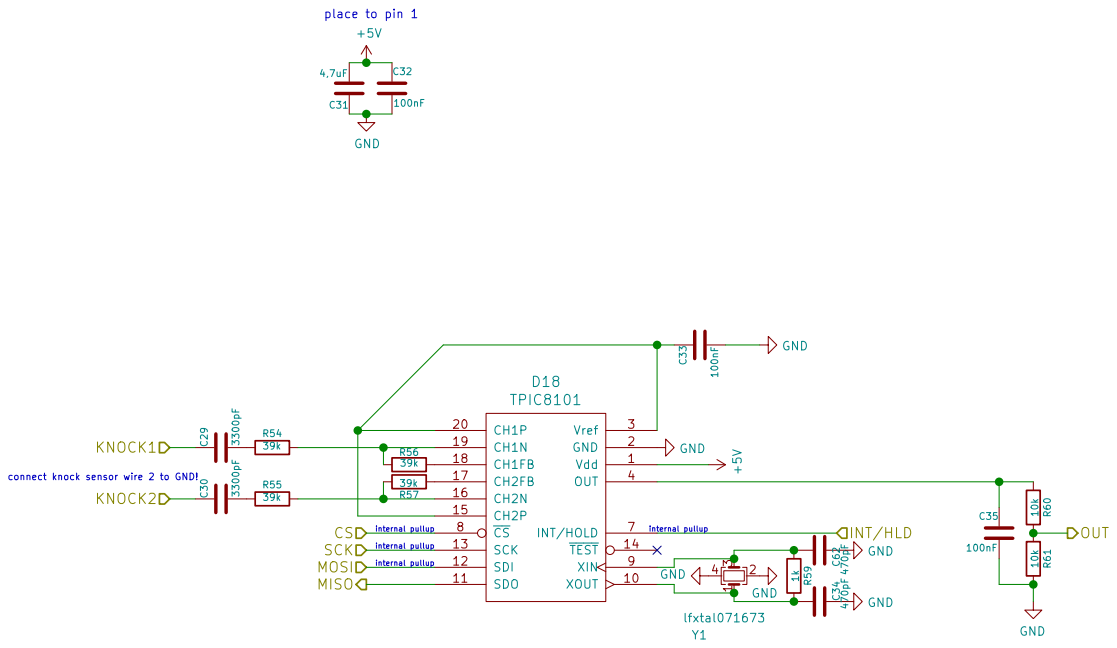
[picture p44: page 5]

Id: 5/8 Title: File: knock.sch Sheet: /knock sensor interface/

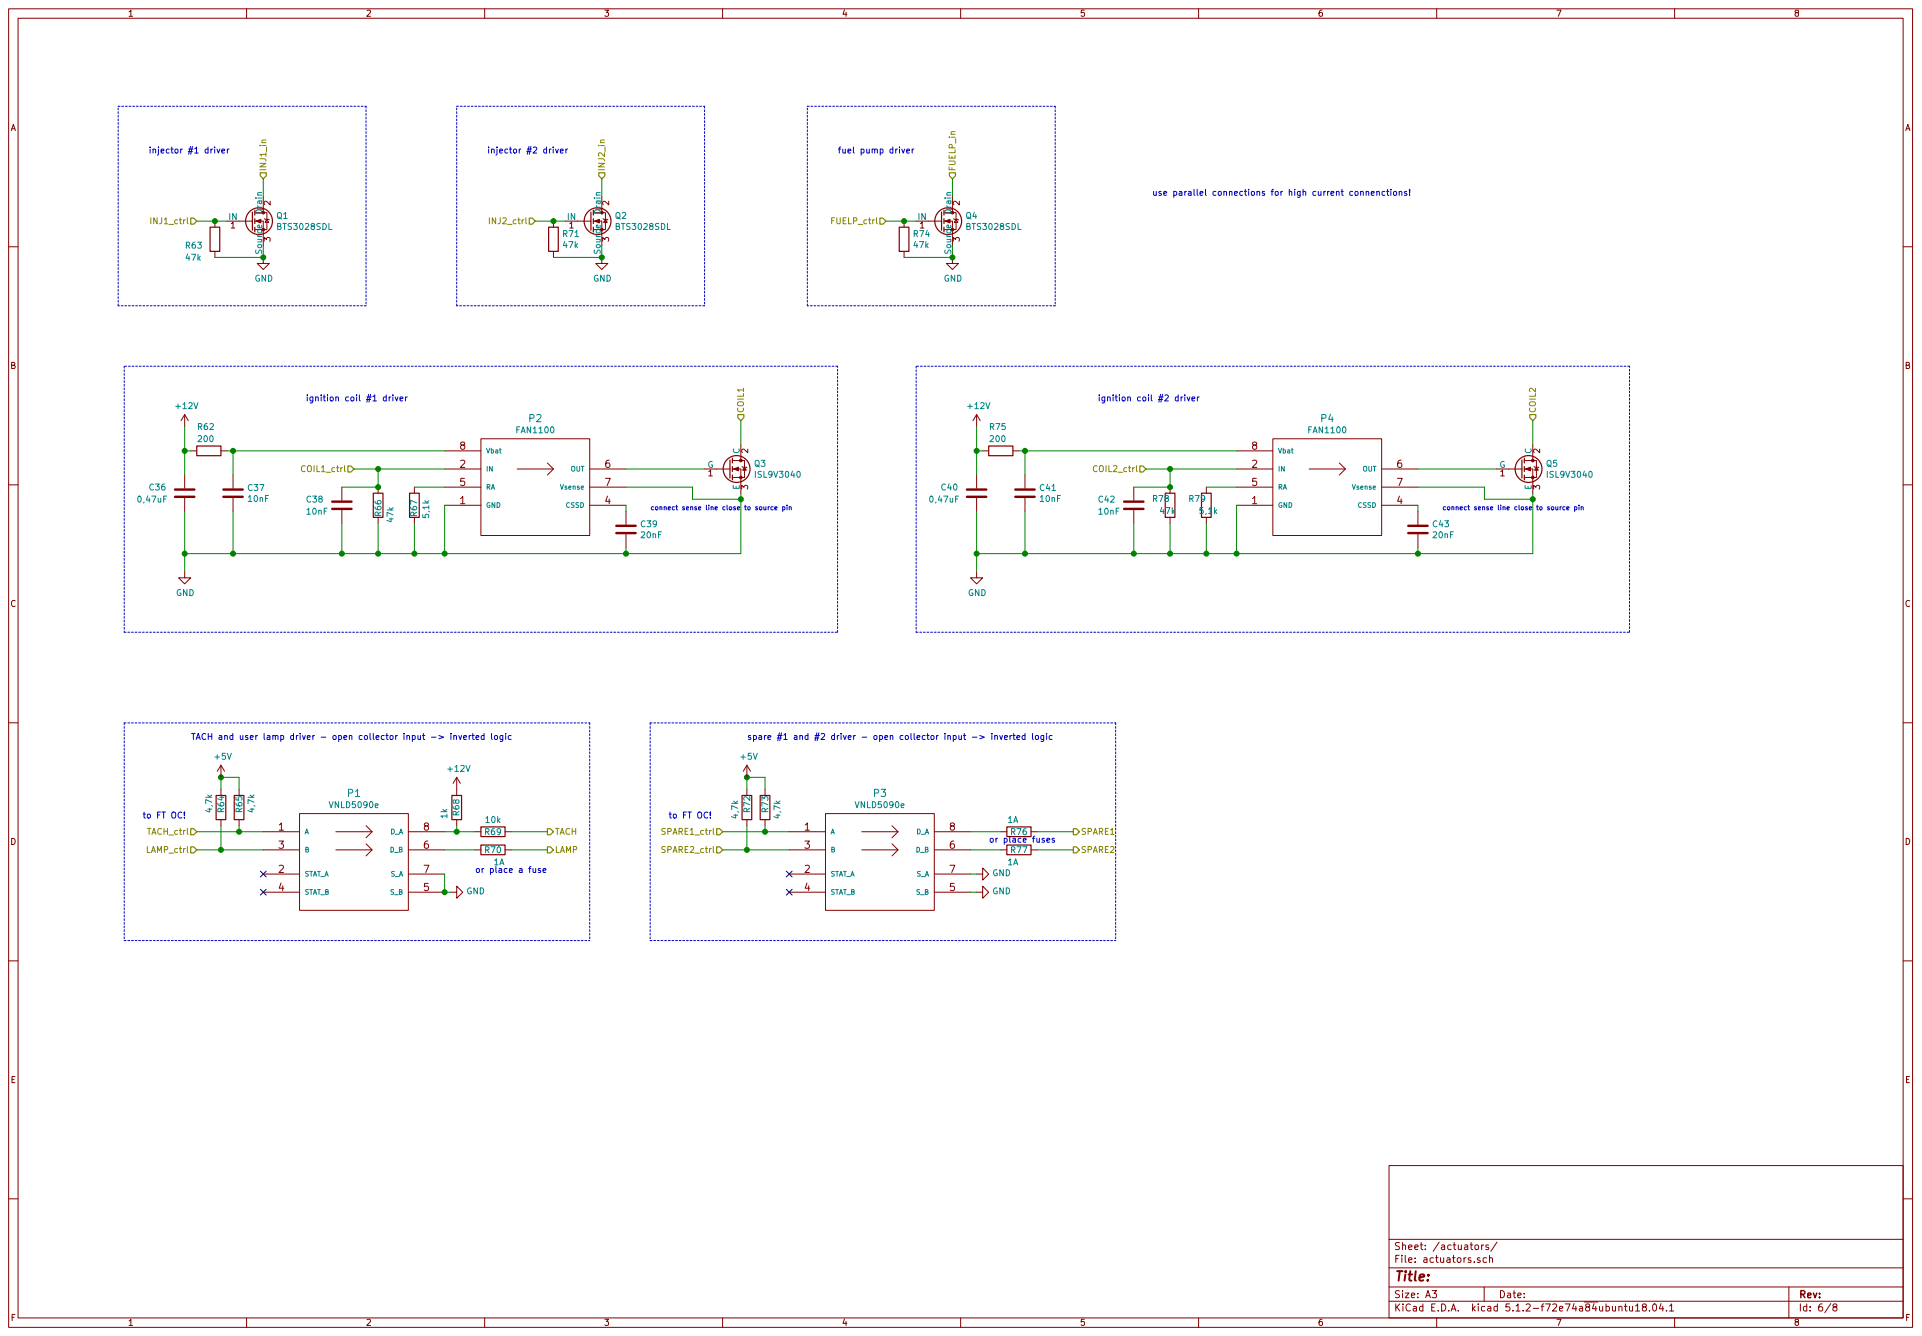
[picture p45: page 6]

use parallel connections for high current connenctions!

spare #1 and #2 driver - open collector input -> inverted logic GND 1

Id: 6/8 Title: File: actuators.sch Sheet: /actuators/

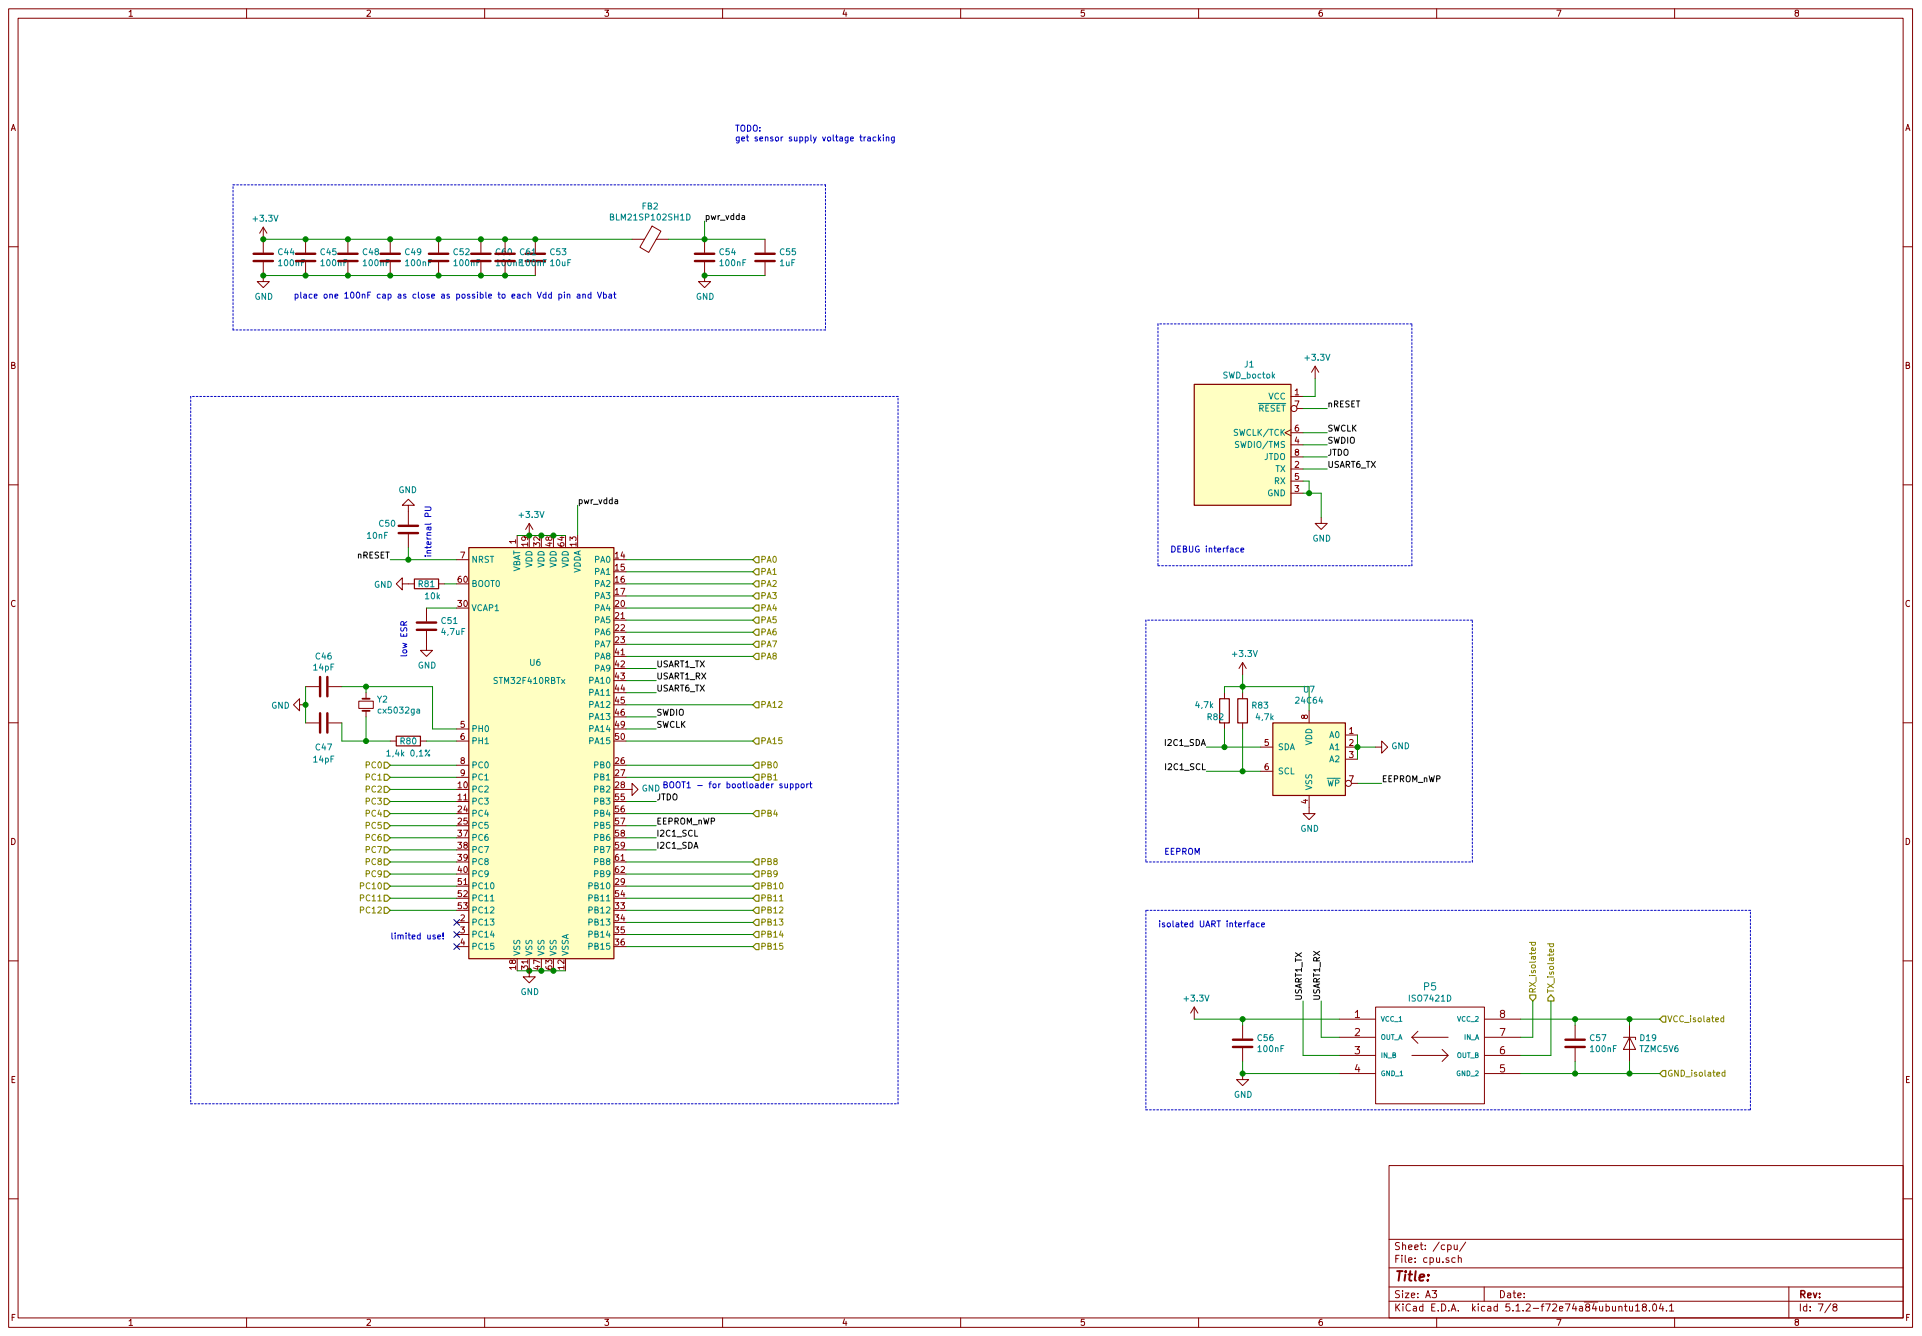
[picture p46: page 7]

TODO: get sensor supply voltage tracking

1 PC2 10 PC3 11 VSSA 12 VDDA 13 PA0 14 PA1 15 PA2 16 PA3 17 VSS 18 VDD 19 PC13 2 PA4 20 PA5 21 PA6 22 PA7 23 PC4 24 PC5 25 PB0 26 PB1 27 PB2 28 PB10 29 PC14 3 VCAP1 30 VSS 31 VDD 32 PB12 33 PB13 34 PB14 35 PB15 36 PC6 37 PC7 38 PC8 39 PC15 4 PC9 40 PA8 41 PA9 42 PA10 43 PA11 44 PA12 45 PA13 46 VSS 47 VDD 48 PA14 49 PH0 5 PA15 50 PC10 51 PC11 52 PC12 53 PB11 54 PB3 55 PB4 56 PB5 57 PB6 58 PB7 59 PH1 6 BOOT0 60 PB8 61 PB9 62 VSS 63 VDD 64 NRST 7 PC0 8 PC1 9 U6 STM32F410RBTx A0 1 A1 2 A2 3 VSS

isolated UART interface GND BOOT1 - for bootloader support VBAT

4 SDA 5 SCL 6 WP 7 VDD

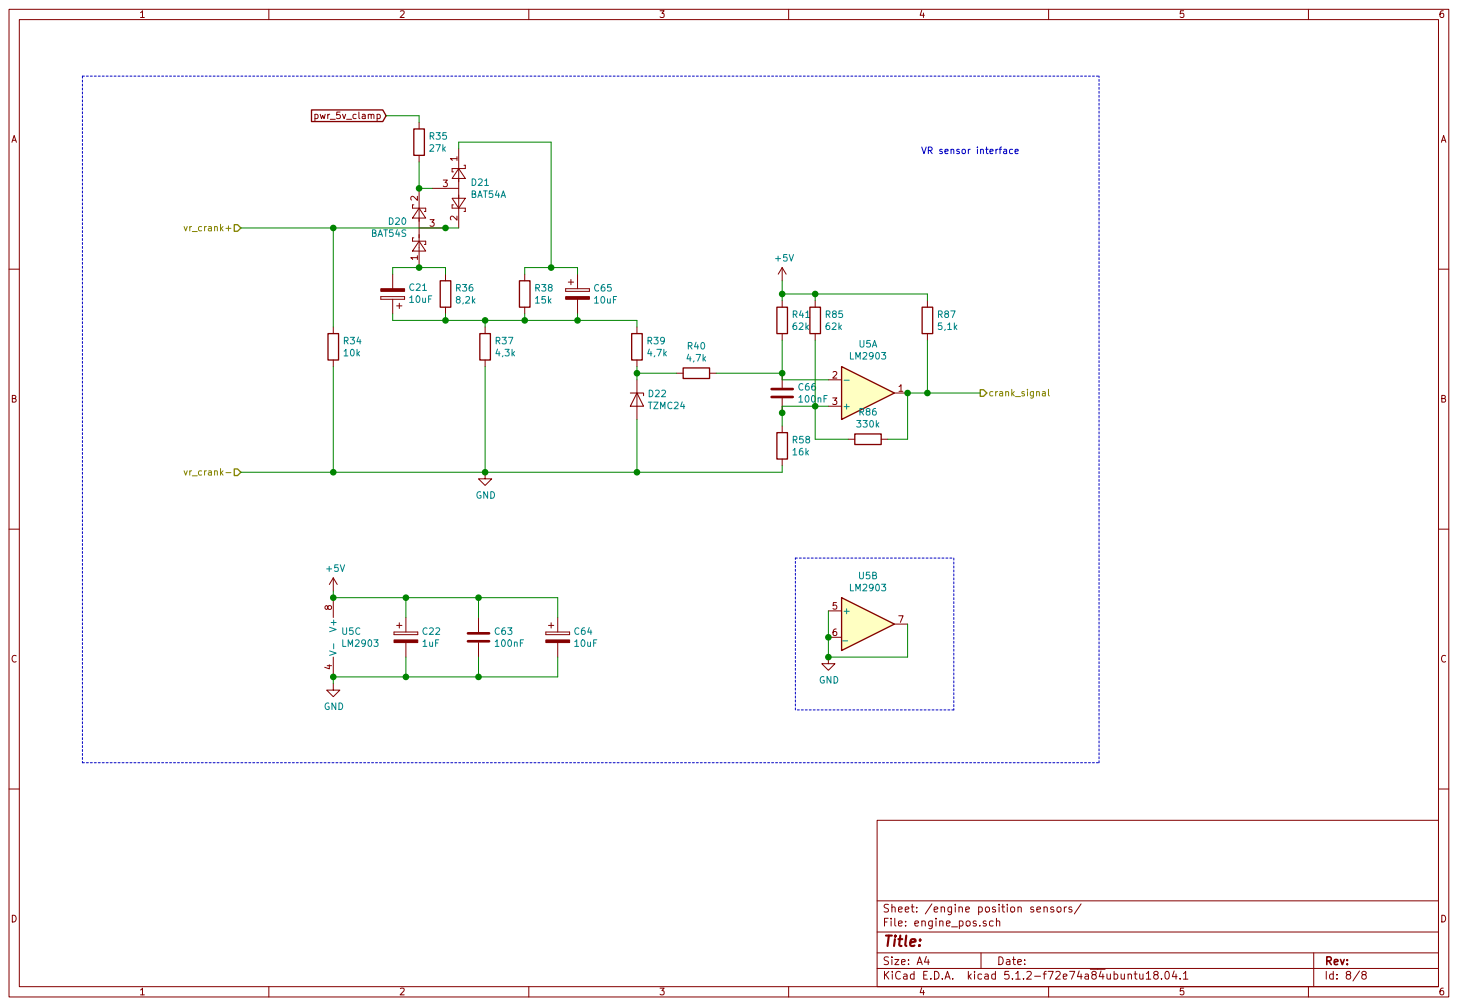
[picture p47: page 8]

Sheet: /engine position sensors/
File: engine_pos.sch
Id: 8/8 Title:
