kanavkin/Tuareg_hw/Tuareg.kicad_pcb

## KiCad design Tuareg.kicad_pcb (2019-08-24)

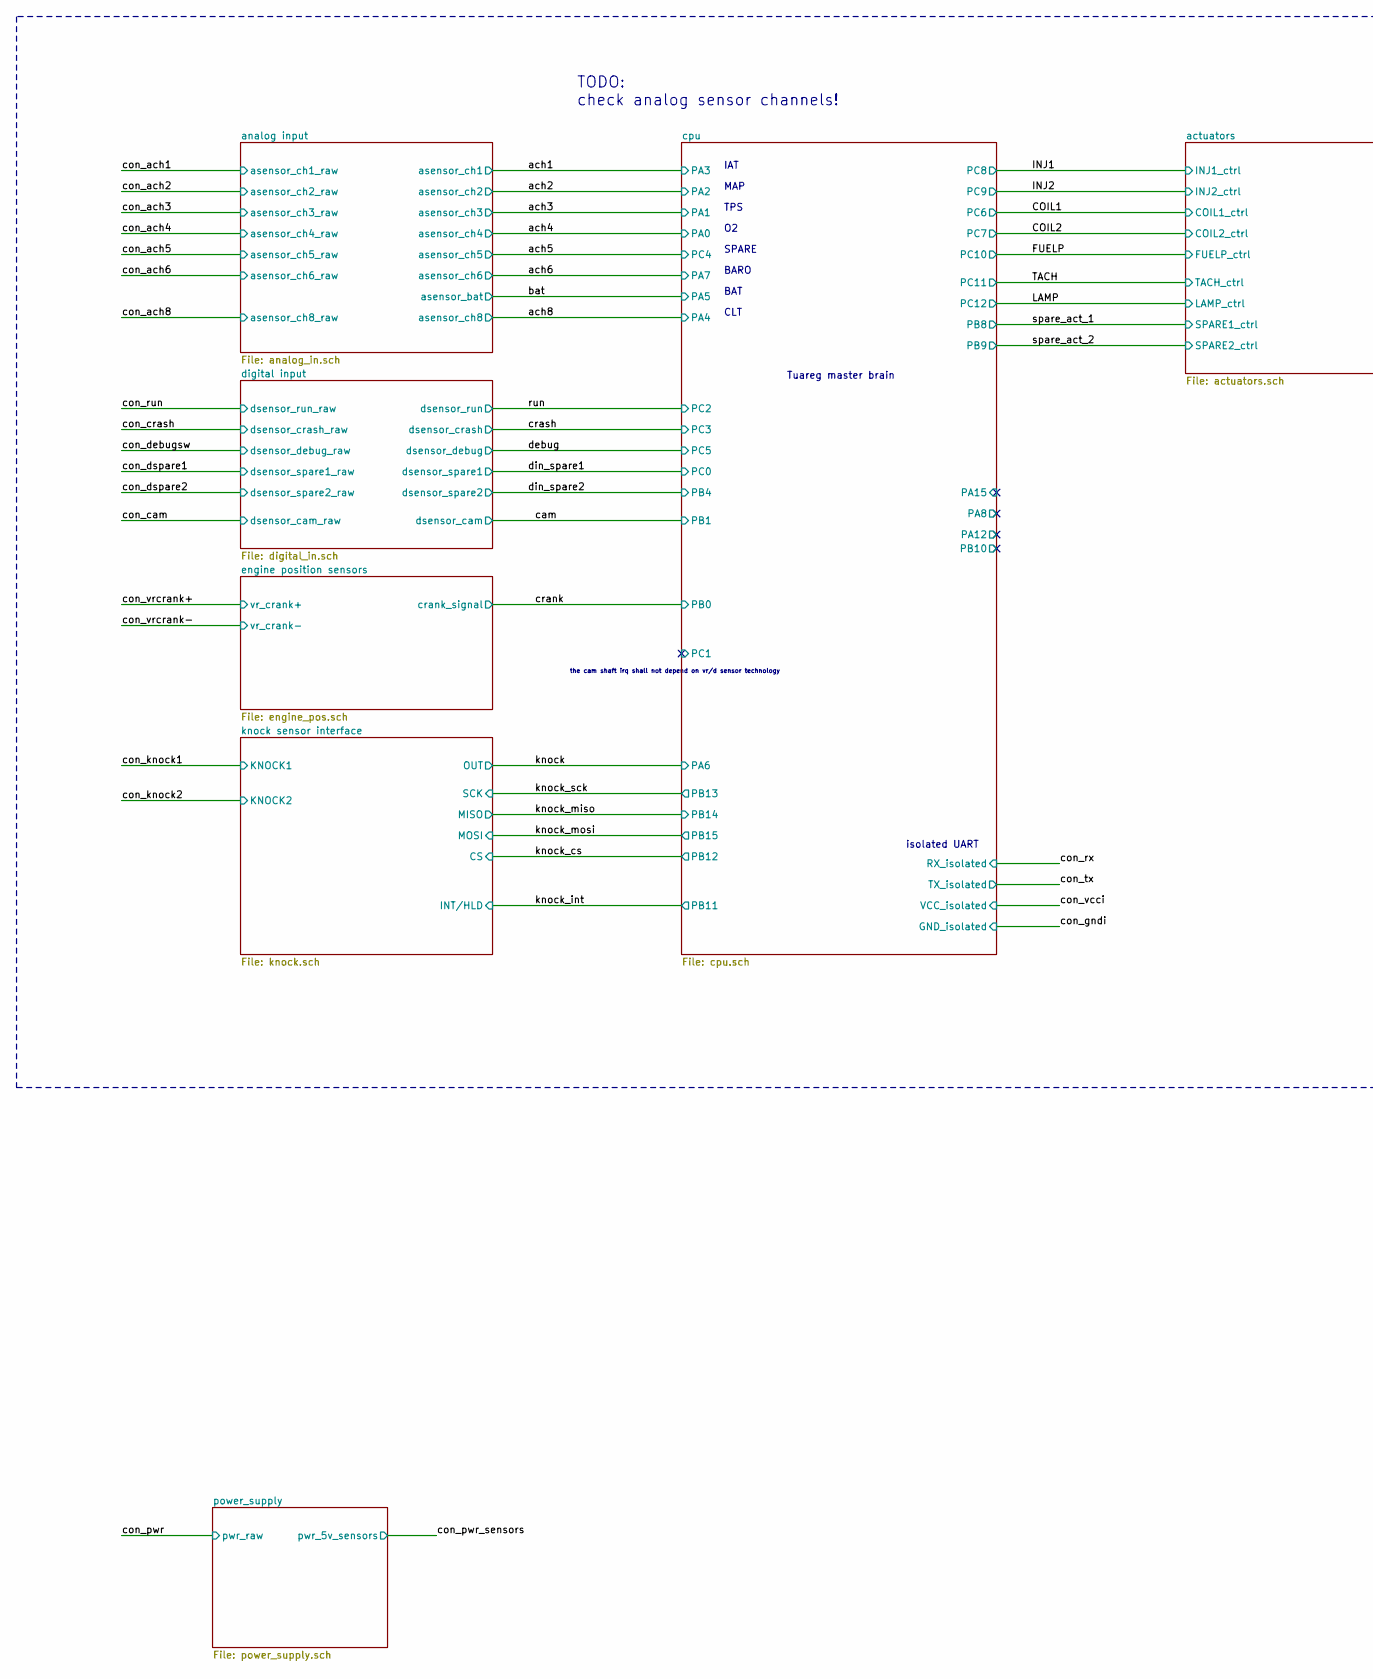
[picture p48: schematic Tuareg.sch, part in row 1, column 1]

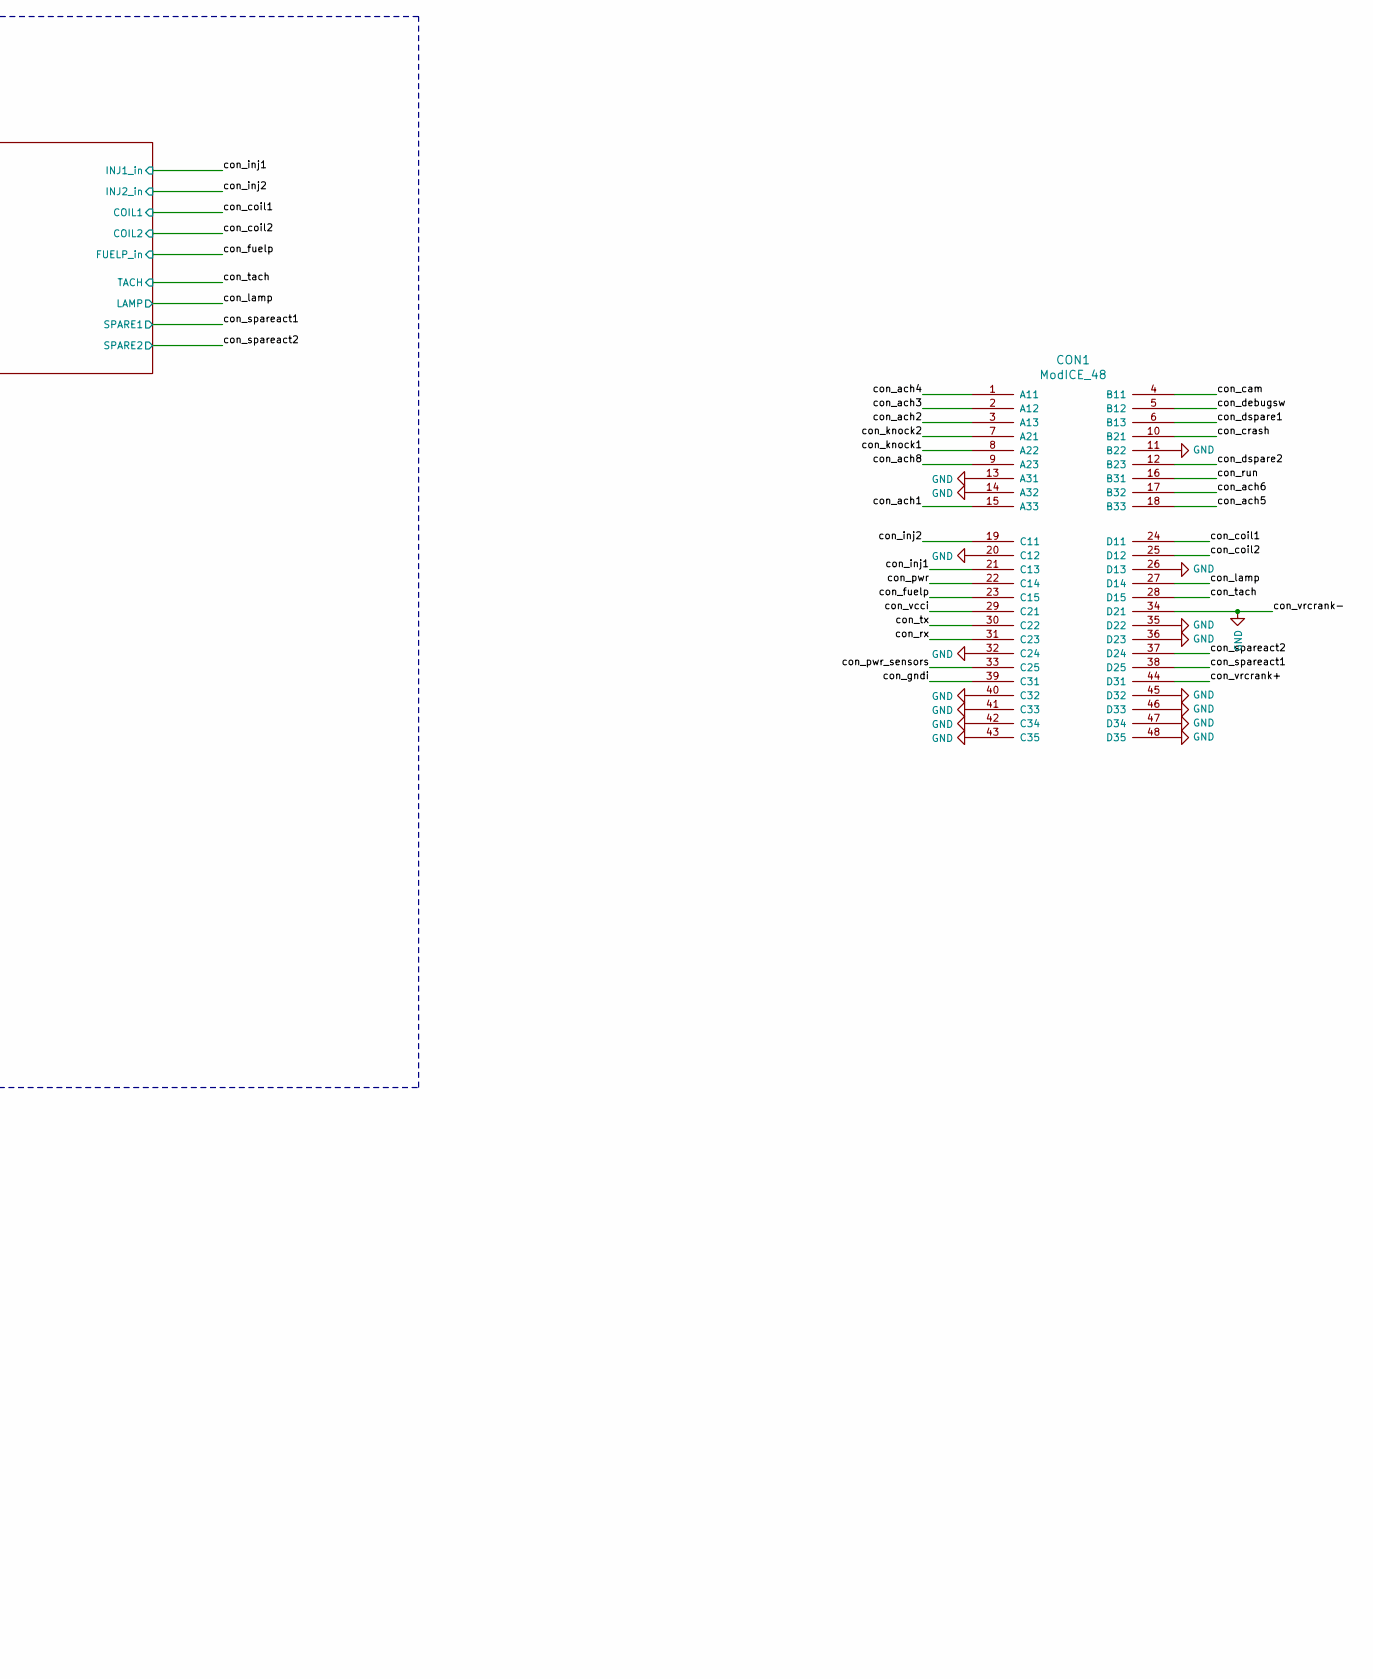
[picture p49: schematic Tuareg.sch, part in row 1, column 2]

Parts:
CON1: ModICE_48; modICE_48

Connections:
/con_ach1: CON1.15 (A33); also elsewhere on the board
/con_ach2: CON1.3 (A13); also elsewhere on the board
/con_ach3: CON1.2 (A12); also elsewhere on the board
/con_ach4: CON1.1 (A11); also elsewhere on the board
/con_ach5: CON1.18 (B33); also elsewhere on the board
/con_ach6: CON1.17 (B32); also elsewhere on the board
/con_ach8: CON1.9 (A23); also elsewhere on the board
/con_cam: CON1.4 (B11); also elsewhere on the board
/con_coil1: CON1.24 (D11); also elsewhere on the board
/con_coil2: CON1.25 (D12); also elsewhere on the board
/con_crash: CON1.10 (B21); also elsewhere on the board
/con_debugsw: CON1.5 (B12); also elsewhere on the board
/con_dspare1: CON1.6 (B13); also elsewhere on the board
/con_dspare2: CON1.12 (B23); also elsewhere on the board
/con_fuelp: CON1.23 (C15); also elsewhere on the board
/con_gndi: CON1.39 (C31); also elsewhere on the board
/con_inj1: CON1.21 (C13); also elsewhere on the board
/con_inj2: CON1.19 (C11); also elsewhere on the board
/con_knock1: CON1.8 (A22); also elsewhere on the board
/con_knock2: CON1.7 (A21); also elsewhere on the board
/con_lamp: CON1.27 (D14); also elsewhere on the board
/con_pwr: CON1.22 (C14); also elsewhere on the board
/con_pwr_sensors: CON1.33 (C25); also elsewhere on the board
/con_run: CON1.16 (B31); also elsewhere on the board
/con_rx: CON1.31 (C23); also elsewhere on the board
/con_spareact1: CON1.38 (D25); also elsewhere on the board
/con_spareact2: CON1.37 (D24); also elsewhere on the board
/con_tach: CON1.28 (D15); also elsewhere on the board
/con_tx: CON1.30 (C22); also elsewhere on the board
/con_vcci: CON1.29 (C21); also elsewhere on the board
/con_vrcrank+: CON1.44 (D31); also elsewhere on the board
GND: CON1.11 (B22), CON1.13 (A31), CON1.14 (A32), CON1.20 (C12), CON1.26 (D13), CON1.32 (C24), CON1.34 (D21), CON1.35 (D22), CON1.36 (D23), CON1.40 (C32), CON1.41 (C33), CON1.42 (C34), CON1.43 (C35), CON1.45 (D32), CON1.46 (D33), CON1.47 (D34), CON1.48 (D35); also elsewhere on the board

Notes on the sheet:
Tuareg master brain
isolated UART
the cam shaft irq shall not depend on vr/d sensor technology
TPS
MAP
IAT
CLT
BAT
BARO
SPARE
TODO: check analog sensor channels!

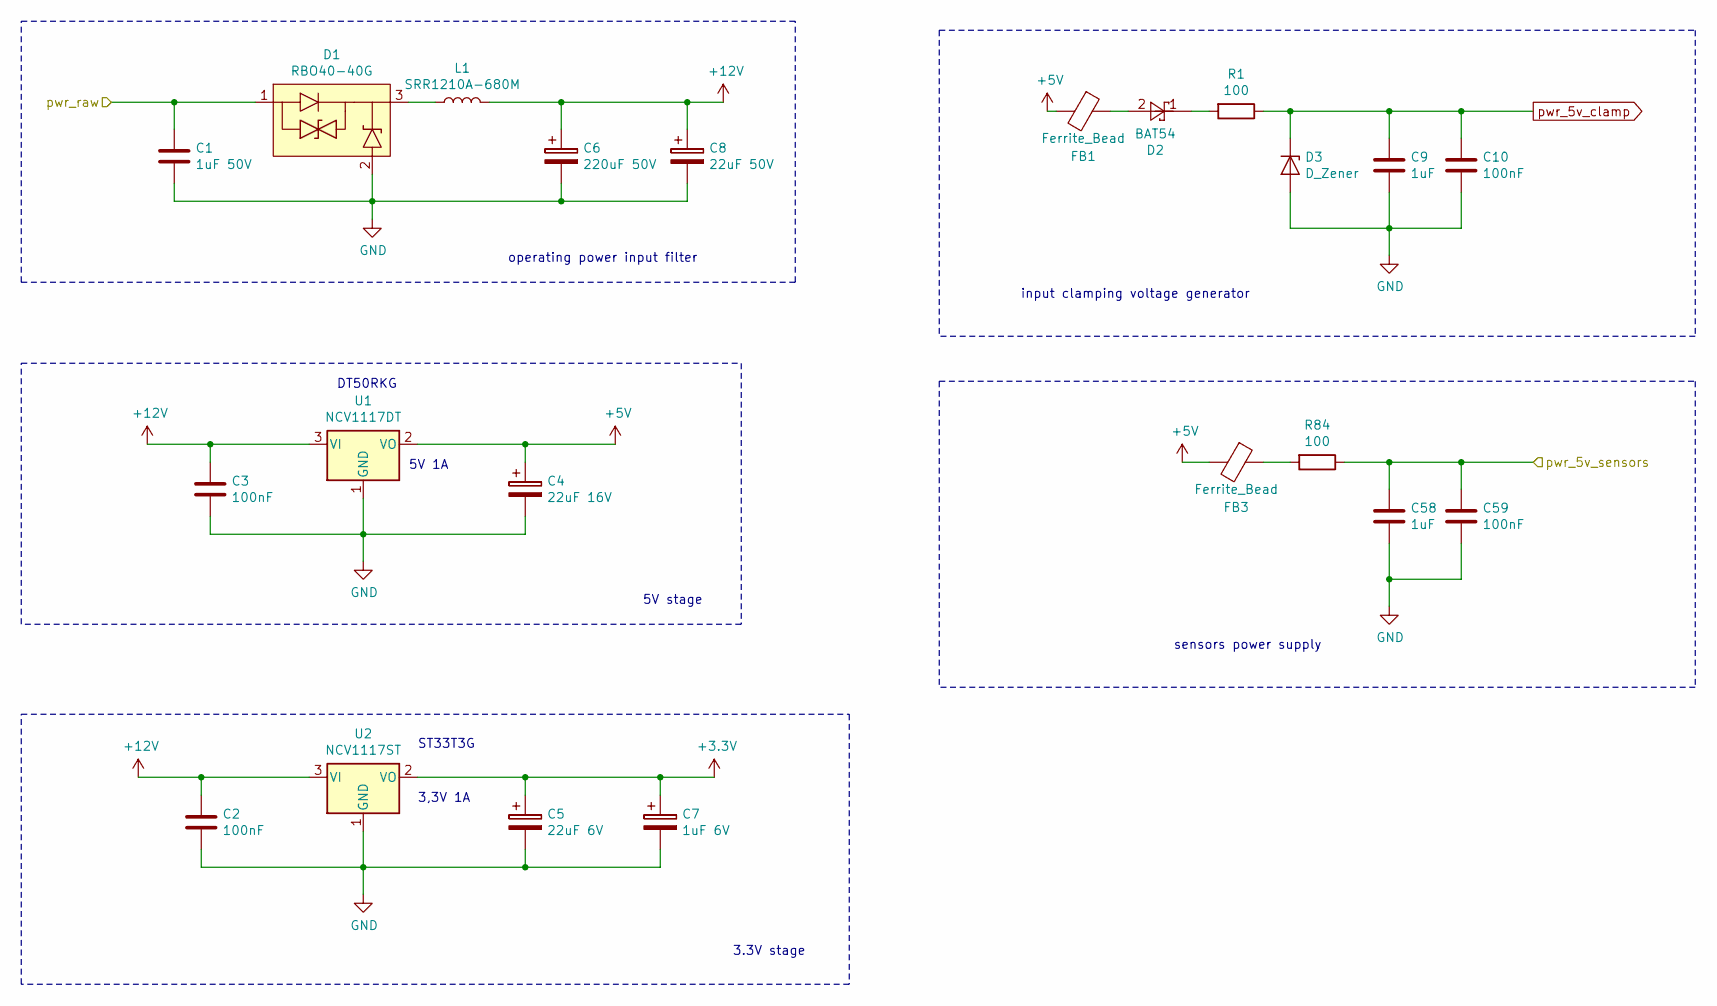
[picture p50: schematic power_supply.sch]

Parts:
C1: 1uF 50V; C_0805_2012Metric
C2, C3, C10, C59: 100nF; C_0805_2012Metric
C4: 22uF 16V; CP_Elec_5x5.8
C5: 22uF 6V; CP_Elec_4x5.8
C6: 220uF 50V; CP_Elec_6.3x7.7
C7: 1uF 6V; C_0805_2012Metric
C8: 22uF 50V; CP_Elec_6.3x7.7
C9, C58: 1uF; C_0805_2012Metric
D1: RBO40-40G
D2: BAT54; D_SOT-23_ANK
D3: D_Zener; D_MiniMELF
FB1, FB3: Ferrite_Bead; L_0805_2012Metric
L1: SRR1210A-680M; SRR1210A
R1, R84: 100; R_1210_3225Metric
U1: NCV1117DT
U2: NCV1117ST

Connections:
+3V3: C5.1, C7.1, U2.2 (VO); also elsewhere on the board
+5V: C4.1, FB1.2, FB3.2, U1.2 (VO); also elsewhere on the board
+12V: C2.1, C3.1, C6.1, C8.1, L1.2, U1.3 (VI), U2.3 (VI); also elsewhere on the board
/con_pwr: C1.1, D1.1 (IN); also elsewhere on the board
/con_pwr_sensors: C58.1, C59.1, R84.1; also elsewhere on the board
GND: C1.2, C2.2, C3.2, C4.2, C5.2, C6.2, C7.2, C8.2, C9.2, C10.2, C58.2, C59.2, D1.2 (GND), D3.2 (A), U1.1 (GND), U2.1 (GND); also elsewhere on the board
unnamed: D1.3 (OUT), L1.1
unnamed: D2.1, R1.2
unnamed: D2.2, FB1.1
unnamed: FB3.1, R84.2
pwr_5v_clamp: C9.1, C10.1, D3.1 (K), R1.1; also elsewhere on the board

Notes on the sheet:
operating power input filter
5V stage
3.3V stage
input clamping voltage generator
DT50RKG
5V 1A
ST33T3G
3,3V 1A
sensors power supply

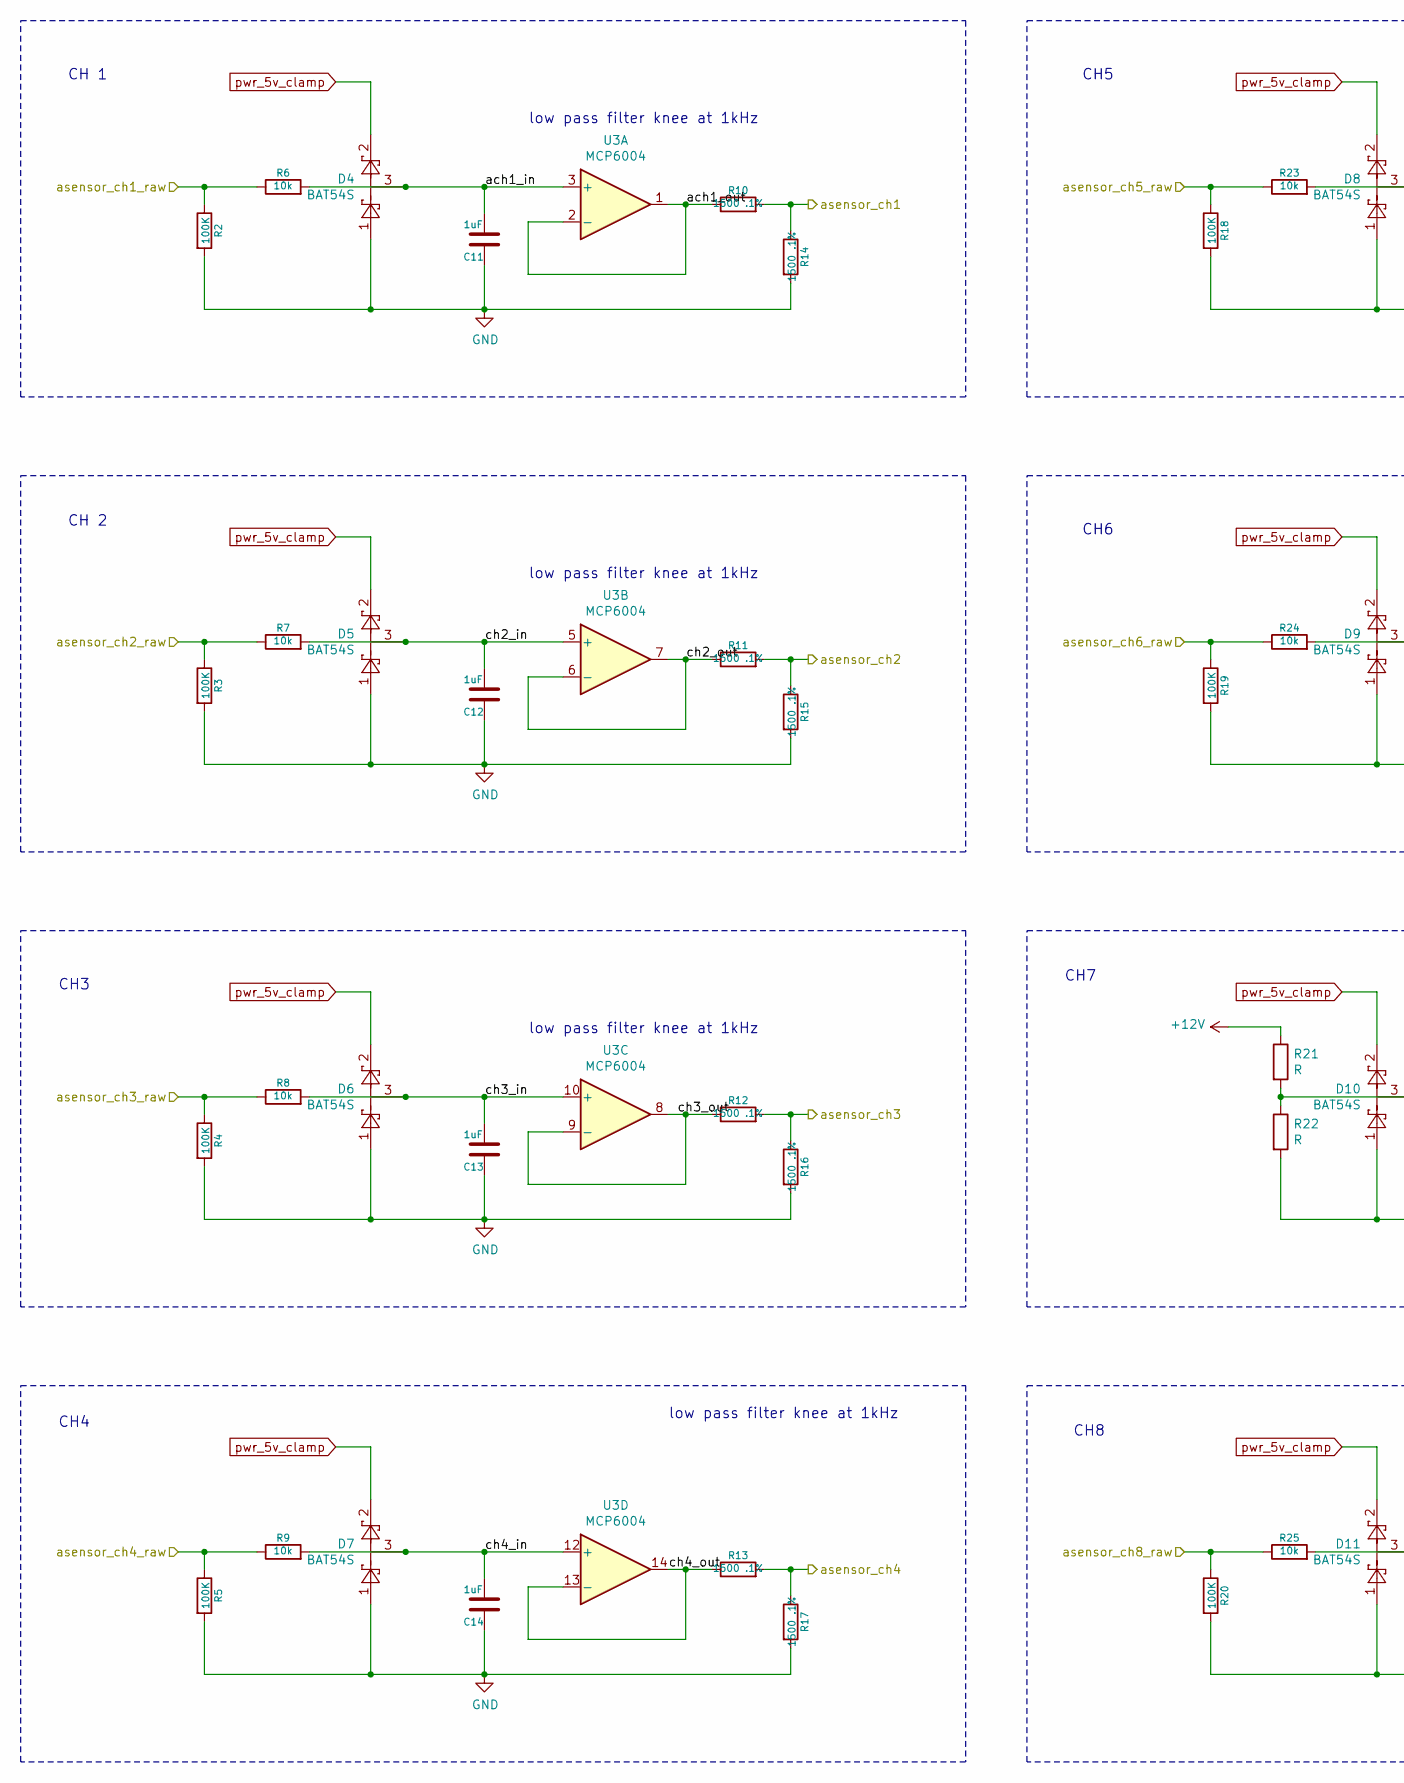
[picture p51: schematic analog_in.sch, part in row 1, column 1]

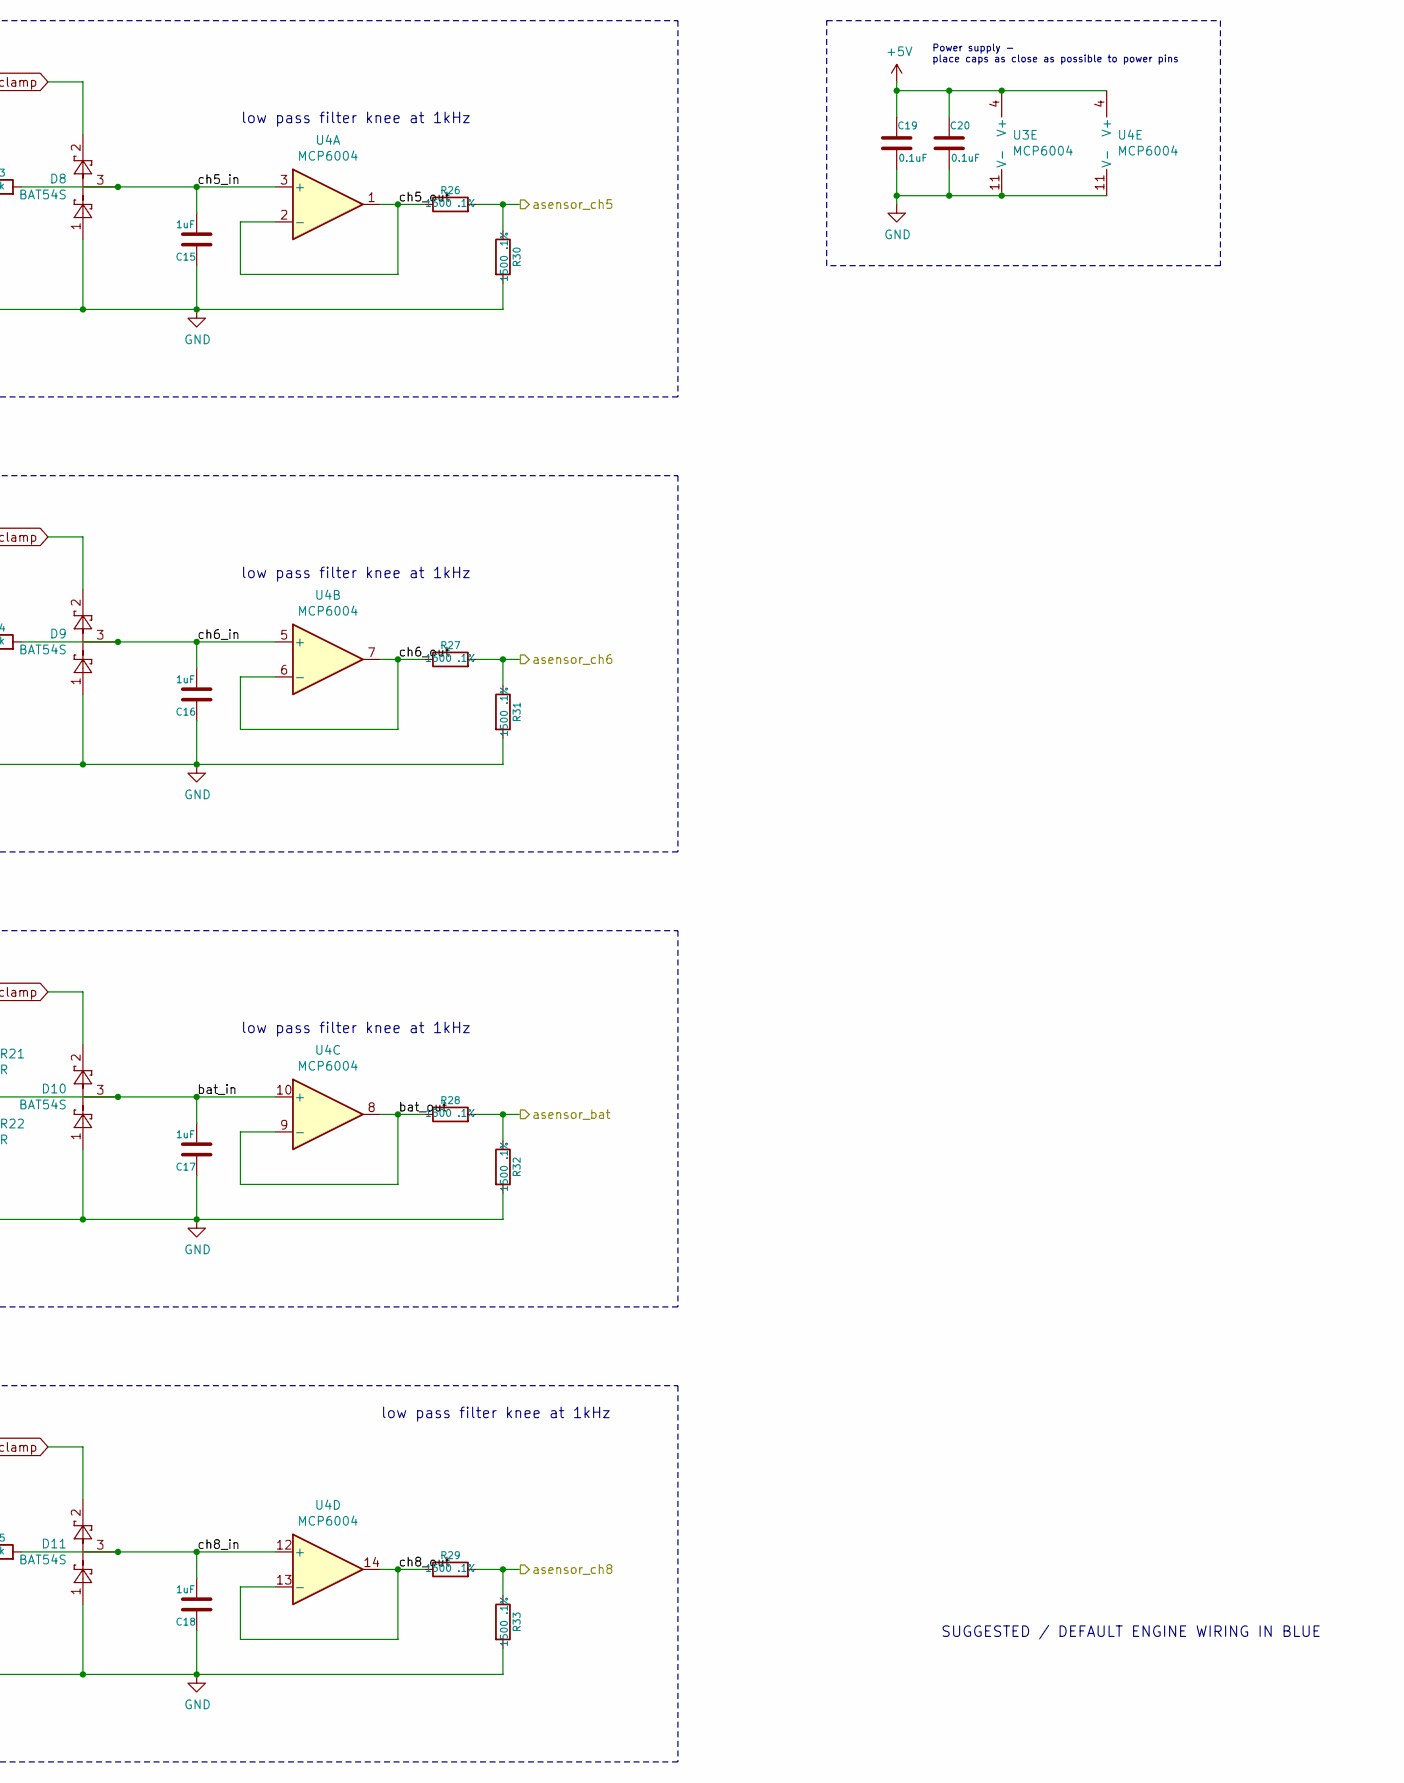
[picture p52: schematic analog_in.sch, part in row 1, column 2]

Parts:
C11, C12, C13, C14, C15, C16, C17, C18: 1uF; C_0805_2012Metric
C19, C20: 0.1uF; C_0805_2012Metric
D4, D5, D6, D7, D8, D9, D10, D11: BAT54S; SOT-23
R2, R3, R4, R5, R18, R19, R20: 100K; R_0805_2012Metric
R6, R7, R8, R9, R23, R24, R25: 10k; R_0805_2012Metric
R10, R11, R12, R13, R14, R15, R16, R17, R26, R27, R28, R29, R30, R31, R32, R33: 1500 .1%; R_0805_2012Metric
R21, R22: R; R_1206_3216Metric
U3, U4: MCP6004

Connections:
+5V: C19.1, C20.1, U3.4 (V+), U4.4 (V+); also elsewhere on the board
+12V: R21.1; also elsewhere on the board
/ach1: R10.2, R14.1; also elsewhere on the board
/ach2: R11.2, R15.1; also elsewhere on the board
/ach3: R12.2, R16.1; also elsewhere on the board
/ach4: R13.2, R17.1; also elsewhere on the board
/ach5: R26.2, R30.1; also elsewhere on the board
/ach6: R27.2, R31.1; also elsewhere on the board
/ach8: R29.2, R33.1; also elsewhere on the board
/analog input/ach1_in: C11.2, D4.3, R6.2, U3.3 (+)
/analog input/ach1_out: R10.1, U3.1, U3.2 (-)
/analog input/bat_in: C17.2, D10.3, R21.2, R22.1, U4.10 (+)
/analog input/bat_out: R28.1, U4.8, U4.9 (-)
/analog input/ch2_in: C12.2, D5.3, R7.2, U3.5 (+)
/analog input/ch2_out: R11.1, U3.6 (-), U3.7
/analog input/ch3_in: C13.2, D6.3, R8.2, U3.10 (+)
/analog input/ch3_out: R12.1, U3.8, U3.9 (-)
/analog input/ch4_in: C14.2, D7.3, R9.2, U3.12 (+)
/analog input/ch4_out: R13.1, U3.13 (-), U3.14
/analog input/ch5_in: C15.2, D8.3, R23.2, U4.3 (+)
/analog input/ch5_out: R26.1, U4.1, U4.2 (-)
/analog input/ch6_in: C16.2, D9.3, R24.2, U4.5 (+)
/analog input/ch6_out: R27.1, U4.6 (-), U4.7
/analog input/ch8_in: C18.2, D11.3, R25.2, U4.12 (+)
/analog input/ch8_out: R29.1, U4.13 (-), U4.14
/bat: R28.2, R32.1; also elsewhere on the board
/con_ach1: R2.1, R6.1; also elsewhere on the board
/con_ach2: R3.1, R7.1; also elsewhere on the board
/con_ach3: R4.1, R8.1; also elsewhere on the board
/con_ach4: R5.1, R9.1; also elsewhere on the board
/con_ach5: R18.1, R23.1; also elsewhere on the board
/con_ach6: R19.1, R24.1; also elsewhere on the board
/con_ach8: R20.1, R25.1; also elsewhere on the board
GND: C11.1, C12.1, C13.1, C14.1, C15.1, C16.1, C17.1, C18.1, C19.2, C20.2, D4.1, D5.1, D6.1, D7.1, D8.1, D9.1, D10.1, D11.1, R2.2, R3.2, R4.2, R5.2, R14.2, R15.2, R16.2, R17.2, R18.2, R19.2, R20.2, R22.2, R30.2, R31.2, R32.2, R33.2, U3.11 (V-), U4.11 (V-); also elsewhere on the board
pwr_5v_clamp: D4.2, D5.2, D6.2, D7.2, D8.2, D9.2, D10.2, D11.2; also elsewhere on the board

Notes on the sheet:
SUGGESTED / DEFAULT ENGINE WIRING IN BLUE
CH 1
low pass filter knee at 1kHz
CH5
CH6
CH3
CH4
CH 2
CH7
CH8
Power supply - place caps as close as possible to power pins

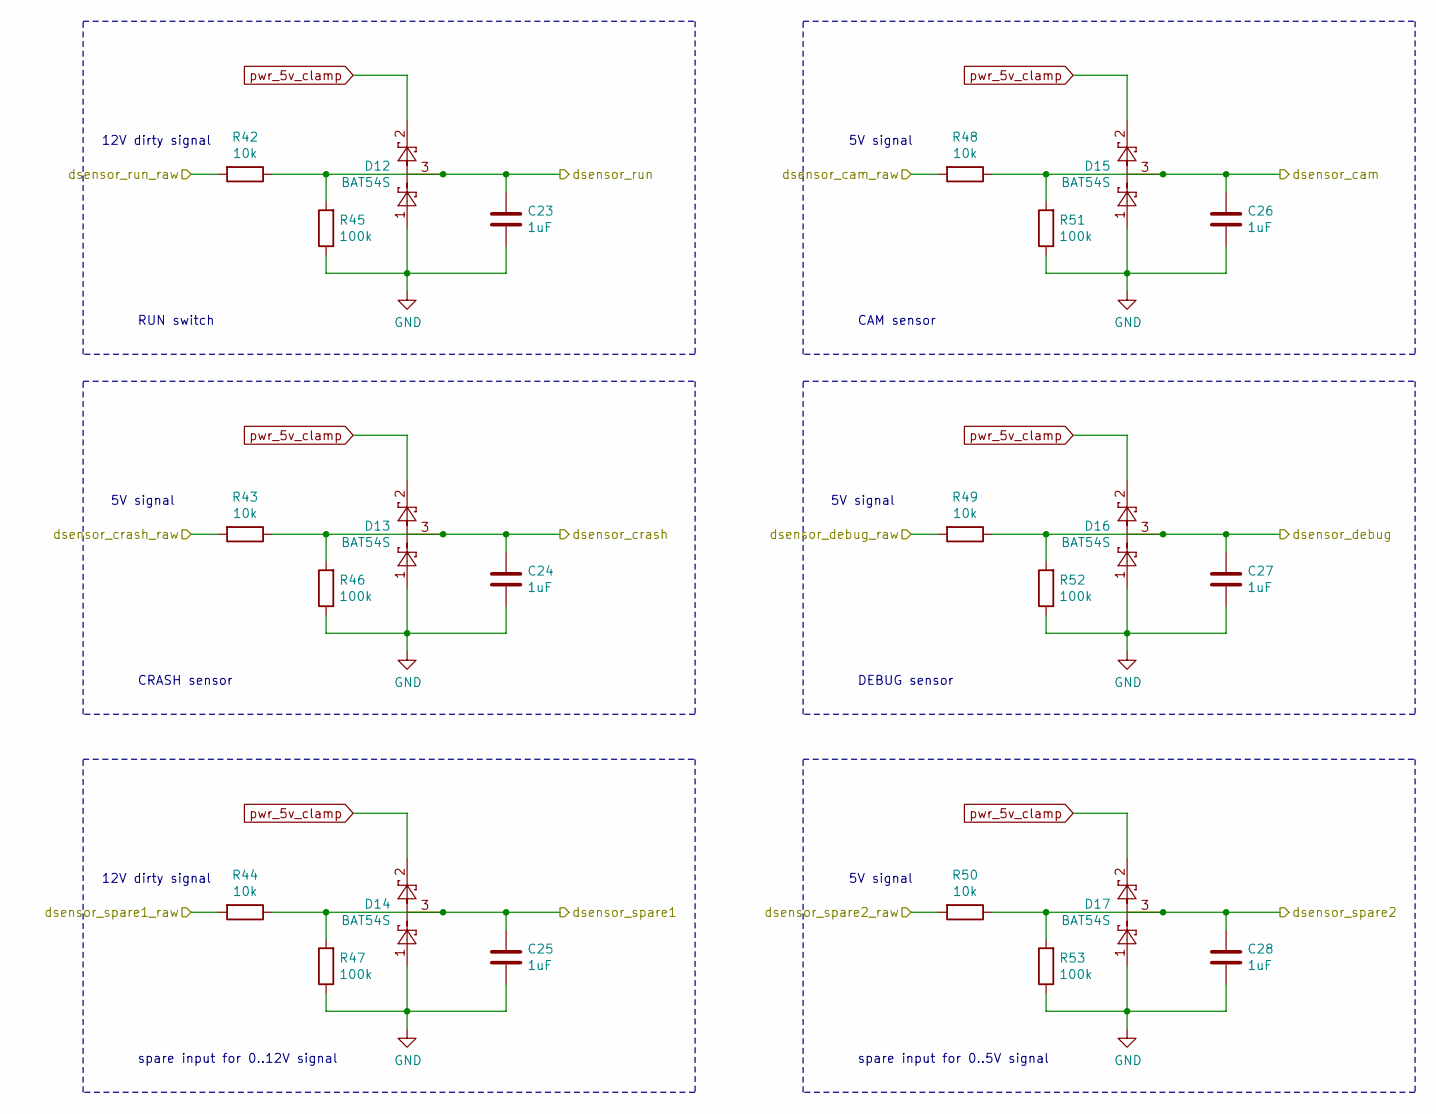
[picture p53: schematic digital_in.sch]

Parts:
C23, C24, C25, C26, C27, C28: 1uF; C_0805_2012Metric
D12, D13, D14, D15, D16, D17: BAT54S; SOT-23
R42, R43, R44, R48, R49, R50: 10k; R_0805_2012Metric
R45, R46, R47, R51, R52, R53: 100k; R_0805_2012Metric

Connections:
/cam: C26.1, D15.3, R48.1, R51.2; also elsewhere on the board
/con_cam: R48.2; also elsewhere on the board
/con_crash: R43.2; also elsewhere on the board
/con_debugsw: R49.2; also elsewhere on the board
/con_dspare1: R44.2; also elsewhere on the board
/con_dspare2: R50.2; also elsewhere on the board
/con_run: R42.2; also elsewhere on the board
/crash: C24.1, D13.3, R43.1, R46.2; also elsewhere on the board
/debug: C27.1, D16.3, R49.1, R52.2; also elsewhere on the board
/din_spare1: C25.1, D14.3, R44.1, R47.2; also elsewhere on the board
/din_spare2: C28.1, D17.3, R50.1, R53.2; also elsewhere on the board
/run: C23.1, D12.3, R42.1, R45.2; also elsewhere on the board
GND: C23.2, C24.2, C25.2, C26.2, C27.2, C28.2, D12.1, D13.1, D14.1, D15.1, D16.1, D17.1, R45.1, R46.1, R47.1, R51.1, R52.1, R53.1; also elsewhere on the board
pwr_5v_clamp: D12.2, D13.2, D14.2, D15.2, D16.2, D17.2; also elsewhere on the board

Notes on the sheet:
RUN switch
CRASH sensor
spare input for 0..12V signal
CAM sensor
12V dirty signal
5V signal
DEBUG sensor
spare input for 0..5V signal

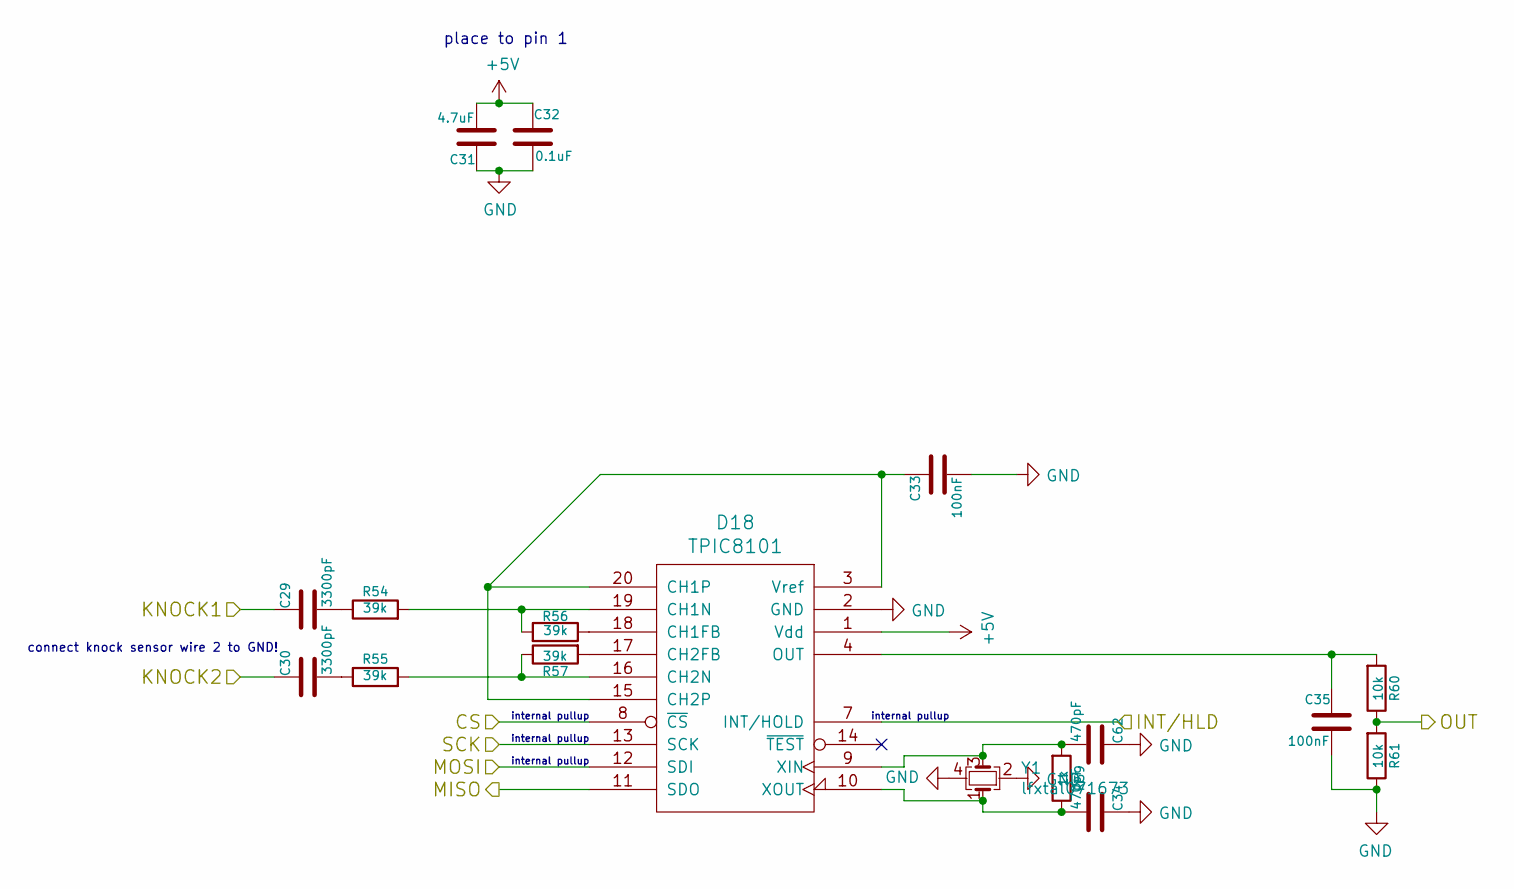
[picture p54: schematic knock.sch]

Parts:
C29, C30: 3300pF; C_0805_2012Metric
C31: 4.7uF; C_0805_2012Metric
C32: 0.1uF; C_0805_2012Metric
C33, C35: 100nF; C_0805_2012Metric
C34, C62: 470pF; C_0805_2012Metric
D18: TPIC8101
R54, R55, R56, R57: 39k; R_0805_2012Metric
R59: 1k; R_0805_2012Metric
R60, R61: 10k; R_0805_2012Metric
Y1: lfxtal071673

Connections:
+5V: C31.2, C32.1, D18.1 (Vdd); also elsewhere on the board
/con_knock1: C29.1; also elsewhere on the board
/con_knock2: C30.1; also elsewhere on the board
/knock: R60.1, R61.2; also elsewhere on the board
/knock_cs: D18.8 (~CS~); also elsewhere on the board
/knock_int: D18.7 (INT/HOLD); also elsewhere on the board
/knock_miso: D18.11 (SDO); also elsewhere on the board
/knock_mosi: D18.12 (SDI); also elsewhere on the board
/knock_sck: D18.13 (SCK); also elsewhere on the board
GND: C31.1, C32.2, C33.2, C34.1, C35.2, C62.1, D18.2 (GND), R61.1, Y1.2, Y1.4; also elsewhere on the board
unnamed: C29.2, R54.1
unnamed: C30.2, R55.1
unnamed: C33.1, D18.3 (Vref), D18.15 (CH2P), D18.20 (CH1P)
unnamed: C34.2, D18.10 (XOUT), R59.1, Y1.1
unnamed: C35.1, D18.4 (OUT), R60.2
unnamed: C62.2, D18.9 (XIN), R59.2, Y1.3
unnamed: D18.16 (CH2N), R55.2, R57.1
unnamed: D18.17 (CH2FB), R57.2
unnamed: D18.18 (CH1FB), R56.1
unnamed: D18.19 (CH1N), R54.2, R56.2

Notes on the sheet:
internal pullup
place to pin 1
connect knock sensor wire 2 to GND!
