kanavkin/Tuareg_hw/Tuareg.kicad_pcb

## KiCad design Tuareg.kicad_pcb (continued)

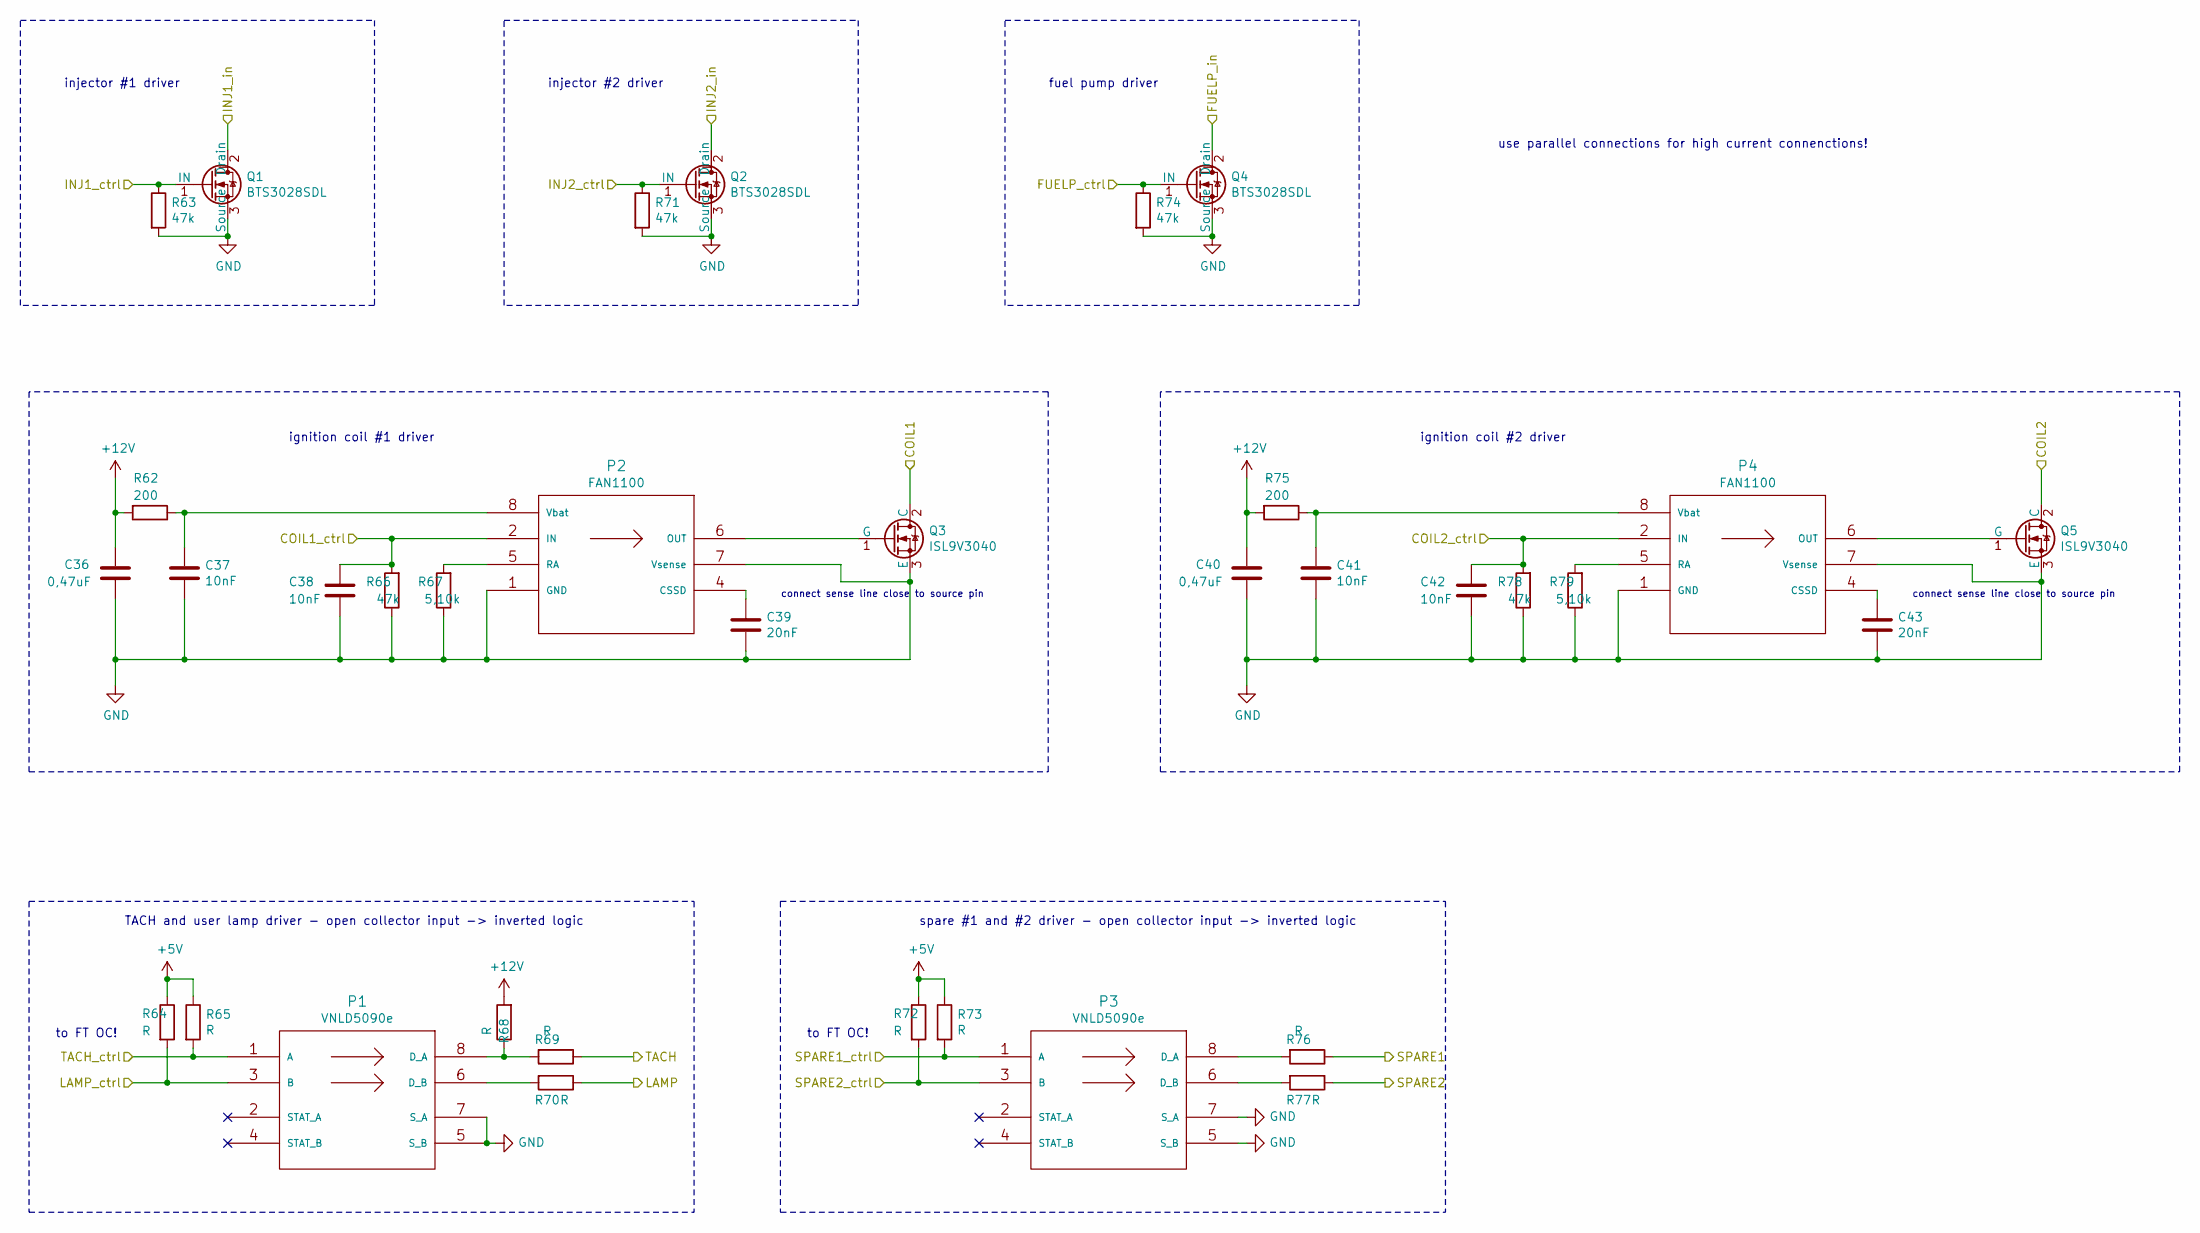
[picture p55: schematic actuators.sch]

Parts:
C36, C40: 0,47uF; C_0805_2012Metric
C37, C38, C41, C42: 10nF; C_0805_2012Metric
C39, C43: 20nF; C_0805_2012Metric
P1, P3: VNLD5090e
P2, P4: FAN1100; FAN_1100
Q1, Q2, Q4: BTS3028SDL; BTS3028SD
Q3, Q5: ISL9V3040
R62, R75: 200; R_1206_3216Metric
R63, R66, R71, R74, R78: 47k; R_0805_2012Metric
R64, R65, R68, R69, R70, R72, R73: R; R_0805_2012Metric
R67, R79: 5,10k; R_0805_2012Metric
R76, R77: R; R_1210_3225Metric

Connections:
+5V: R64.1, R65.1, R72.1, R73.1; also elsewhere on the board
+12V: C36.1, C40.1, R62.2, R68.2, R75.2; also elsewhere on the board
/COIL1: C38.1, P2.2 (IN), R66.2; also elsewhere on the board
/COIL2: C42.1, P4.2 (IN), R78.2; also elsewhere on the board
/FUELP: Q4.1 (IN), R74.1; also elsewhere on the board
/INJ1: Q1.1 (IN), R63.1; also elsewhere on the board
/INJ2: Q2.1 (IN), R71.1; also elsewhere on the board
/LAMP: P1.3 (B), R64.2; also elsewhere on the board
/TACH: P1.1 (A), R65.2; also elsewhere on the board
/con_coil1: Q3.2 (C); also elsewhere on the board
/con_coil2: Q5.2 (C); also elsewhere on the board
/con_fuelp: Q4.2 (Drain); also elsewhere on the board
/con_inj1: Q1.2 (Drain); also elsewhere on the board
/con_inj2: Q2.2 (Drain); also elsewhere on the board
/con_lamp: R70.1; also elsewhere on the board
/con_spareact1: R76.1; also elsewhere on the board
/con_spareact2: R77.1; also elsewhere on the board
/con_tach: R69.1; also elsewhere on the board
/spare_act_1: P3.1 (A), R73.2; also elsewhere on the board
/spare_act_2: P3.3 (B), R72.2; also elsewhere on the board
GND: C36.2, C37.2, C38.2, C39.2, C40.2, C41.2, C42.2, C43.2, P1.5 (S_B), P1.7 (S_A), P2.1 (GND), P2.7 (Vsense), P3.5 (S_B), P3.7 (S_A), P4.1 (GND), P4.7 (Vsense), Q1.3 (Source), Q2.3 (Source), Q3.3 (E), Q4.3 (Source), Q5.3 (E), R63.2, R66.1, R67.1, R71.2, R74.2, R78.1, R79.1; also elsewhere on the board
unnamed: C37.1, P2.8 (Vbat), R62.1
unnamed: C39.1, P2.4 (CSSD)
unnamed: C41.1, P4.8 (Vbat), R75.1
unnamed: C43.1, P4.4 (CSSD)
unnamed: P1.6 (D_B), R70.2
unnamed: P1.8 (D_A), R68.1, R69.2
unnamed: P2.5 (RA), R67.2
unnamed: P2.6 (OUT), Q3.1 (G)
unnamed: P3.6 (D_B), R77.2
unnamed: P3.8 (D_A), R76.2
unnamed: P4.5 (RA), R79.2
unnamed: P4.6 (OUT), Q5.1 (G)

Notes on the sheet:
injector #1 driver
injector #2 driver
fuel pump driver
ignition coil #1 driver
to FT OC!
TACH and user lamp driver - open collector input -> inverted logic
spare #1 and #2 driver - open collector input -> inverted logic
connect sense line close to source pin
ignition coil #2 driver
use parallel connections for high current connenctions!

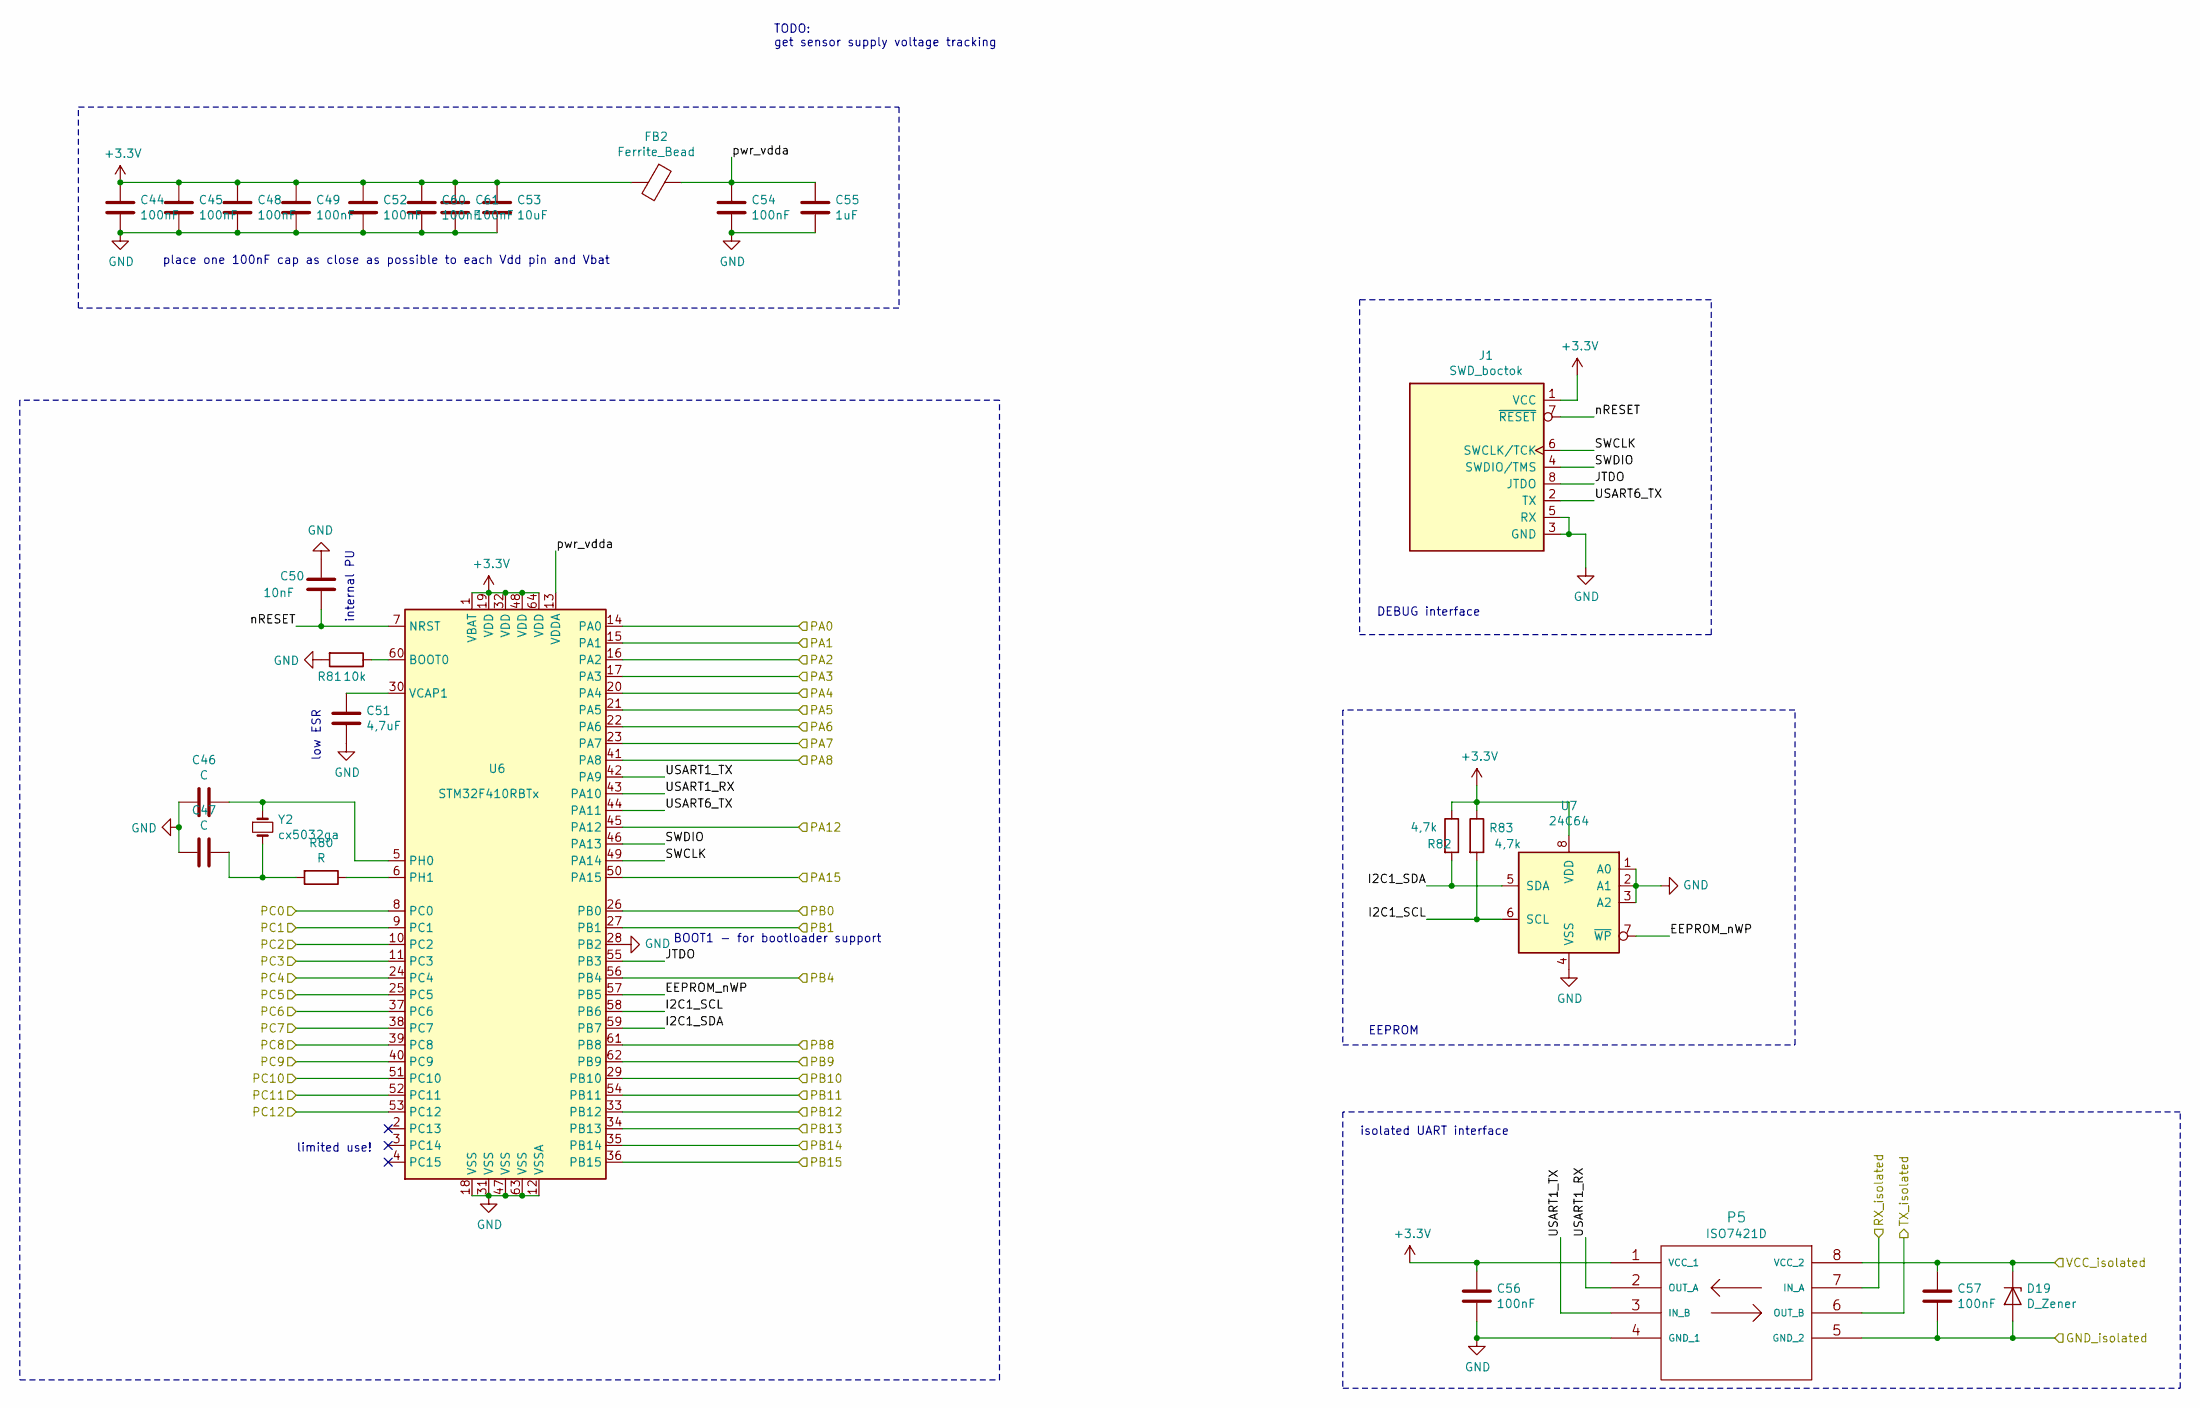
[picture p56: schematic cpu.sch]

Parts:
C44, C45, C48, C49, C52, C54, C56, C57, C60, C61: 100nF; C_0805_2012Metric
C46, C47: C; C_0805_2012Metric
C50: 10nF; C_0805_2012Metric
C51: 4,7uF; C_0805_2012Metric
C53: 10uF; C_1206_3216Metric
C55: 1uF; C_0805_2012Metric
D19: D_Zener; D_MELF
FB2: Ferrite_Bead; L_0805_2012Metric
J1: SWD_boctok; swd_boctok
P5: ISO7421D
R80: R; R_0805_2012Metric
R81: 10k; R_0805_2012Metric
R82, R83: 4,7k; R_0805_2012Metric
U6: STM32F410RBTx; LQFP-64_10x10mm_P0.5mm
U7: 24C64
Y2: cx5032ga; cx5032

Connections:
+3V3: C44.1, C45.1, C48.1, C49.1, C52.1, C53.1, C56.1, C60.1, C61.1, FB2.2, J1.1 (VCC), P5.1 (VCC_1), R82.1, R83.1, U6.1 (VBAT), U6.19 (VDD), U6.32 (VDD), U6.48 (VDD), U6.64 (VDD), U7.8 (VDD); also elsewhere on the board
/COIL1: U6.37 (PC6); also elsewhere on the board
/COIL2: U6.38 (PC7); also elsewhere on the board
/FUELP: U6.51 (PC10); also elsewhere on the board
/INJ1: U6.39 (PC8); also elsewhere on the board
/INJ2: U6.40 (PC9); also elsewhere on the board
/LAMP: U6.53 (PC12); also elsewhere on the board
/TACH: U6.52 (PC11); also elsewhere on the board
/ach1: U6.17 (PA3); also elsewhere on the board
/ach2: U6.16 (PA2); also elsewhere on the board
/ach3: U6.15 (PA1); also elsewhere on the board
/ach4: U6.14 (PA0); also elsewhere on the board
/ach5: U6.24 (PC4); also elsewhere on the board
/ach6: U6.23 (PA7); also elsewhere on the board
/ach8: U6.20 (PA4); also elsewhere on the board
/bat: U6.21 (PA5); also elsewhere on the board
/cam: U6.27 (PB1); also elsewhere on the board
/con_gndi: C57.2, D19.2 (A), P5.5 (GND_2); also elsewhere on the board
/con_rx: P5.7 (IN_A); also elsewhere on the board
/con_tx: P5.6 (OUT_B); also elsewhere on the board
/con_vcci: C57.1, D19.1 (K), P5.8 (VCC_2); also elsewhere on the board
/cpu/EEPROM_nWP: U6.57 (PB5), U7.7 (~WP~)
/cpu/I2C1_SCL: R83.2, U6.58 (PB6), U7.6 (SCL)
/cpu/I2C1_SDA: R82.2, U6.59 (PB7), U7.5 (SDA)
/cpu/JTDO: J1.8 (JTDO), U6.55 (PB3)
/cpu/PA8: U6.41 (PA8)
/cpu/PA12: U6.45 (PA12)
/cpu/PA15: U6.50 (PA15)
/cpu/PB10: U6.29 (PB10)
/cpu/PC1: U6.9 (PC1)
/cpu/SWCLK: J1.6 (SWCLK/TCK), U6.49 (PA14)
/cpu/SWDIO: J1.4 (SWDIO/TMS), U6.46 (PA13)
/cpu/USART1_RX: P5.2 (OUT_A), U6.43 (PA10)
/cpu/USART1_TX: P5.3 (IN_B), U6.42 (PA9)
/cpu/USART6_TX: J1.2 (TX), U6.44 (PA11)
/cpu/nRESET: C50.2, J1.7 (~RESET~), U6.7 (NRST)
/cpu/pwr_vdda: C54.1, C55.1, FB2.1, U6.13 (VDDA); also elsewhere on the board
/crank: U6.26 (PB0); also elsewhere on the board
/crash: U6.11 (PC3); also elsewhere on the board
/debug: U6.25 (PC5); also elsewhere on the board
/din_spare1: U6.8 (PC0); also elsewhere on the board
/din_spare2: U6.56 (PB4); also elsewhere on the board
/knock: U6.22 (PA6); also elsewhere on the board
/knock_cs: U6.33 (PB12); also elsewhere on the board
/knock_int: U6.54 (PB11); also elsewhere on the board
/knock_miso: U6.35 (PB14); also elsewhere on the board
/knock_mosi: U6.36 (PB15); also elsewhere on the board
/knock_sck: U6.34 (PB13); also elsewhere on the board
/run: U6.10 (PC2); also elsewhere on the board
/spare_act_1: U6.61 (PB8); also elsewhere on the board
/spare_act_2: U6.62 (PB9); also elsewhere on the board
GND: C44.2, C45.2, C46.2, C47.2, C48.2, C49.2, C50.1, C51.2, C52.2, C53.2, C54.2, C55.2, C56.2, C60.2, C61.2, J1.3 (GND), J1.5 (RX), P5.4 (GND_1), R81.2, U6.12 (VSSA), U6.18 (VSS), U6.28 (PB2), U6.31 (VSS), U6.47 (VSS), U6.63 (VSS), U7.1 (A0), U7.2 (A1), U7.3 (A2), U7.4 (VSS); also elsewhere on the board
unnamed: C46.1, U6.5 (PH0), Y2.1
unnamed: C47.1, R80.2, Y2.2
unnamed: C51.1, U6.30 (VCAP1)
unnamed: R80.1, U6.6 (PH1)
unnamed: R81.1, U6.60 (BOOT0)

Notes on the sheet:
place one 100nF cap as close as possible to each Vdd pin and Vbat
low ESR
internal PU
EEPROM
DEBUG interface
isolated UART interface
BOOT1 - for bootloader support
limited use!
TODO: get sensor supply voltage tracking

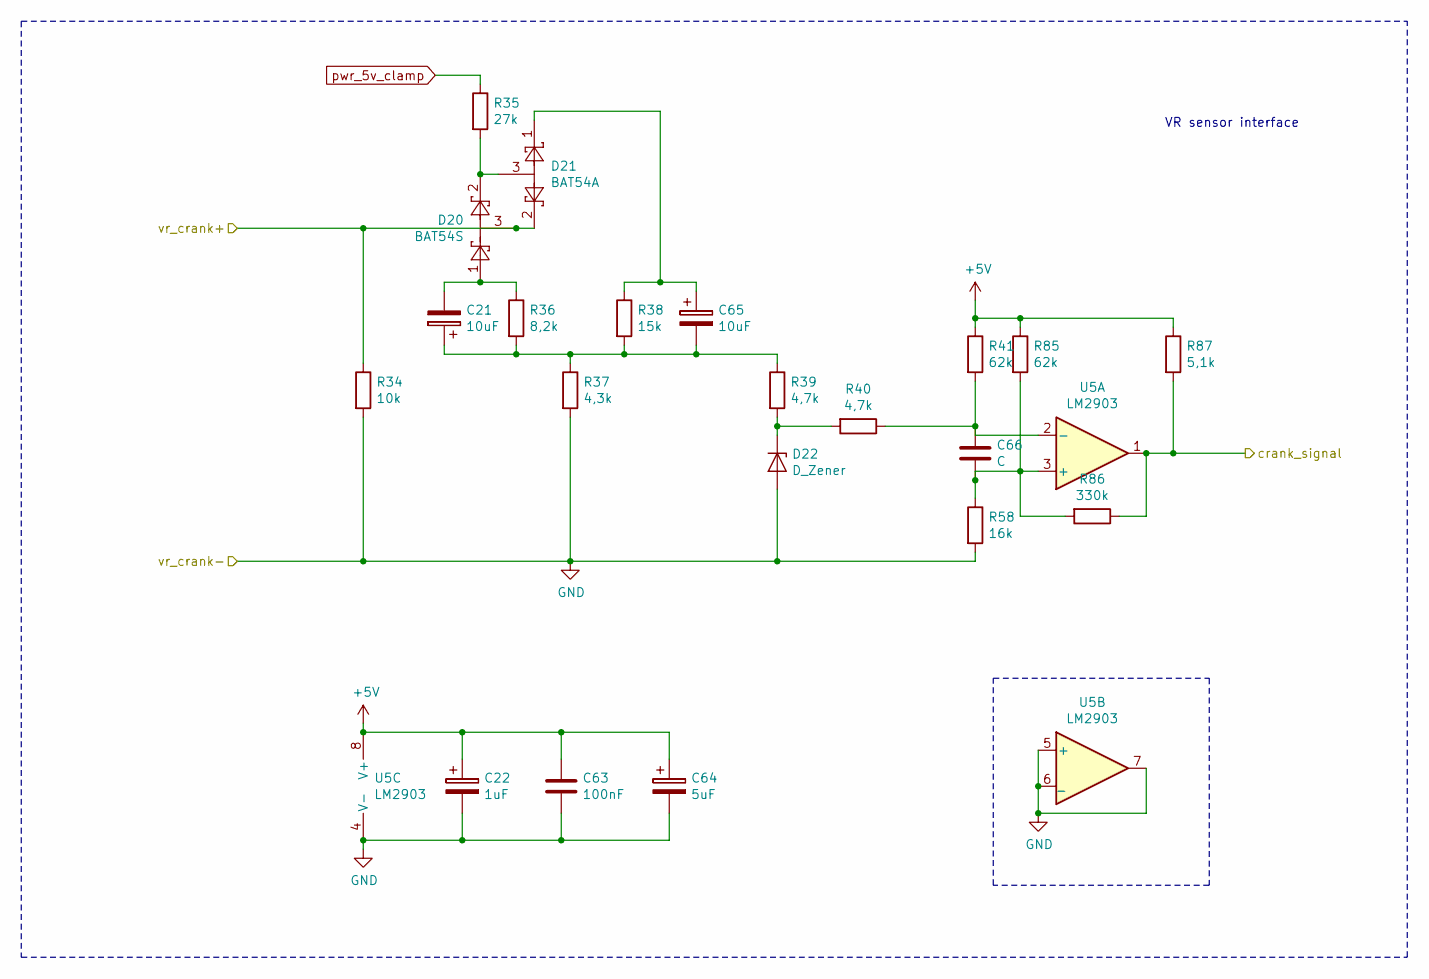
[picture p57: schematic engine_pos.sch]

Parts:
C21, C65: 10uF; CP_EIA-7343-31_Kemet-D
C22: 1uF; C_1206_3216Metric
C63: 100nF; C_0805_2012Metric
C64: 5uF; C_1206_3216Metric
C66: C; C_0805_2012Metric
D20: BAT54S; SOT-23
D21: BAT54A; SOT-23
D22: D_Zener; D_MiniMELF
R34: 10k; R_1206_3216Metric
R35: 27k; R_0805_2012Metric
R36: 8,2k; R_0805_2012Metric
R37: 4,3k; R_0805_2012Metric
R38: 15k; R_0805_2012Metric
R39, R40: 4,7k; R_0805_2012Metric
R41, R85: 62k; R_0805_2012Metric
R58: 16k; R_0805_2012Metric
R86: 330k; R_0805_2012Metric
R87: 5,1k; R_0805_2012Metric
U5: LM2903; SOIC-8_3.9x4.9mm_P1.27mm

Connections:
+5V: C22.1, C63.1, C64.1, R41.1, R85.1, R87.1, U5.8 (V+); also elsewhere on the board
/con_vrcrank+: D20.3, D21.2, R34.1; also elsewhere on the board
/crank: R86.1, R87.2, U5.1; also elsewhere on the board
GND: C22.2, C63.2, C64.2, D22.2 (A), R34.2, R37.2, R58.2, U5.4 (V-), U5.5 (+), U5.6 (_), U5.7; also elsewhere on the board
unnamed: C21.1, C65.2, R36.2, R37.1, R38.2, R39.1
unnamed: C21.2, D20.1, R36.1
unnamed: C65.1, D21.1, R38.1
unnamed 113: C66.1, R40.1, R41.2, U5.2 (-); also elsewhere on the board
unnamed: C66.2, R58.1, R85.2, R86.2, U5.3 (+)
unnamed: D20.2, D21.3, R35.2
unnamed: D22.1 (K), R39.2, R40.2
pwr_5v_clamp: R35.1; also elsewhere on the board

Notes on the sheet:
VR sensor interface

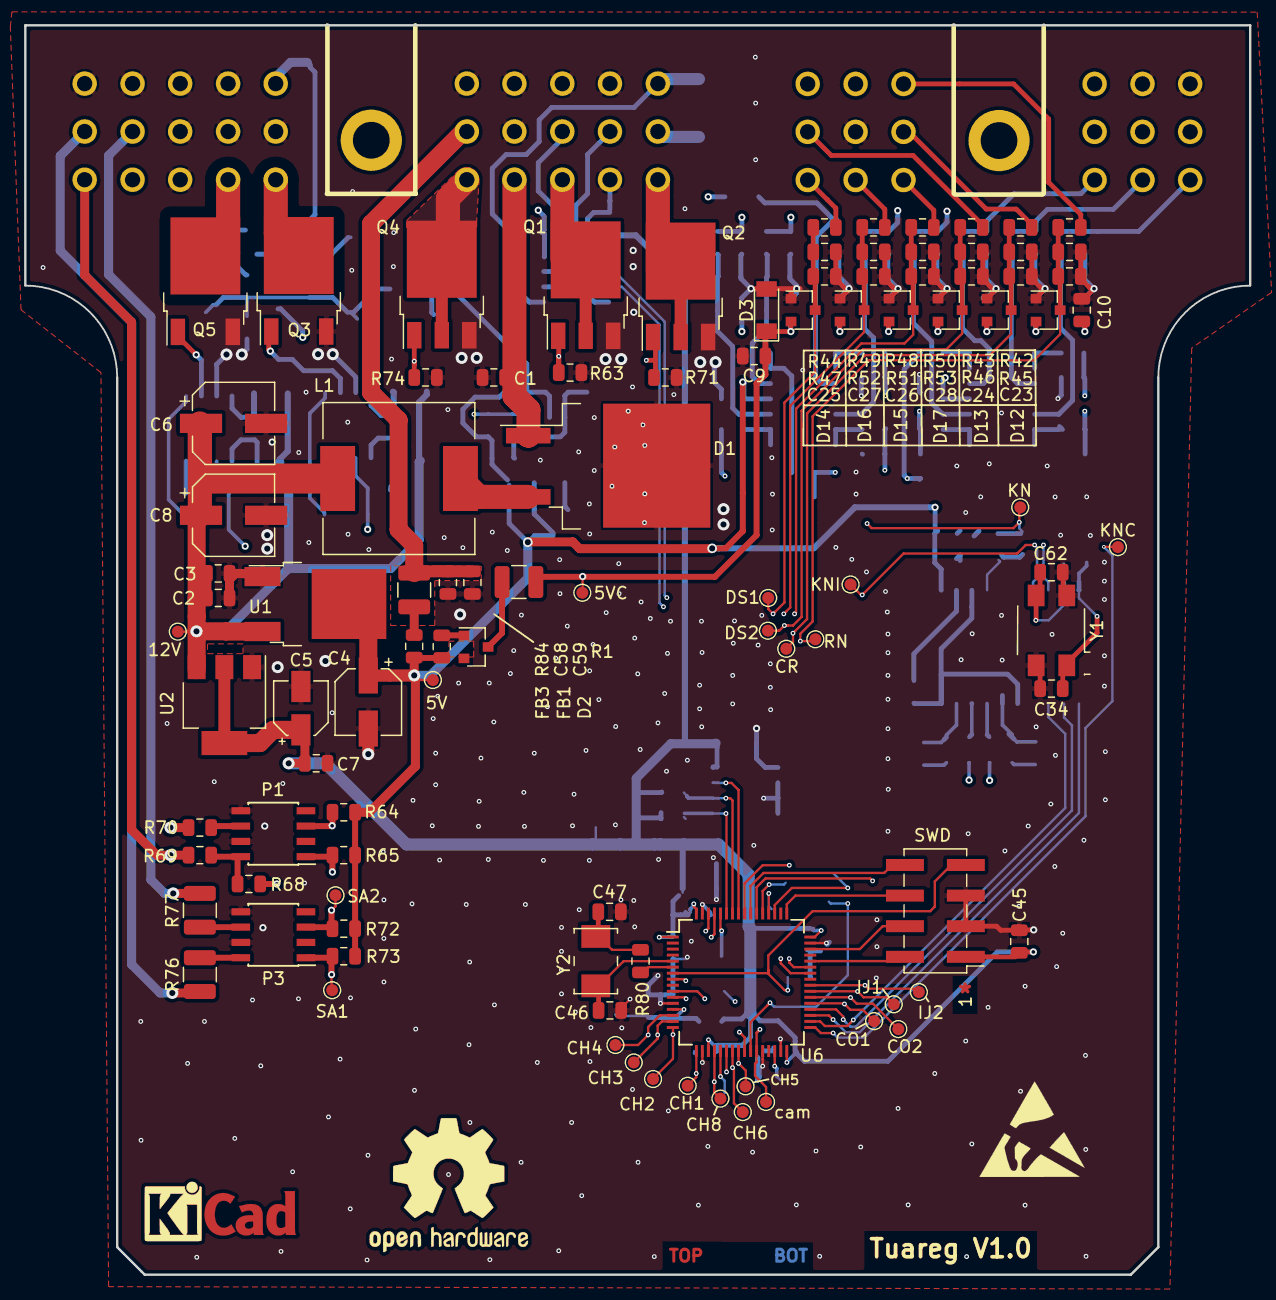
[picture p58: board Tuareg.kicad_pcb from above]

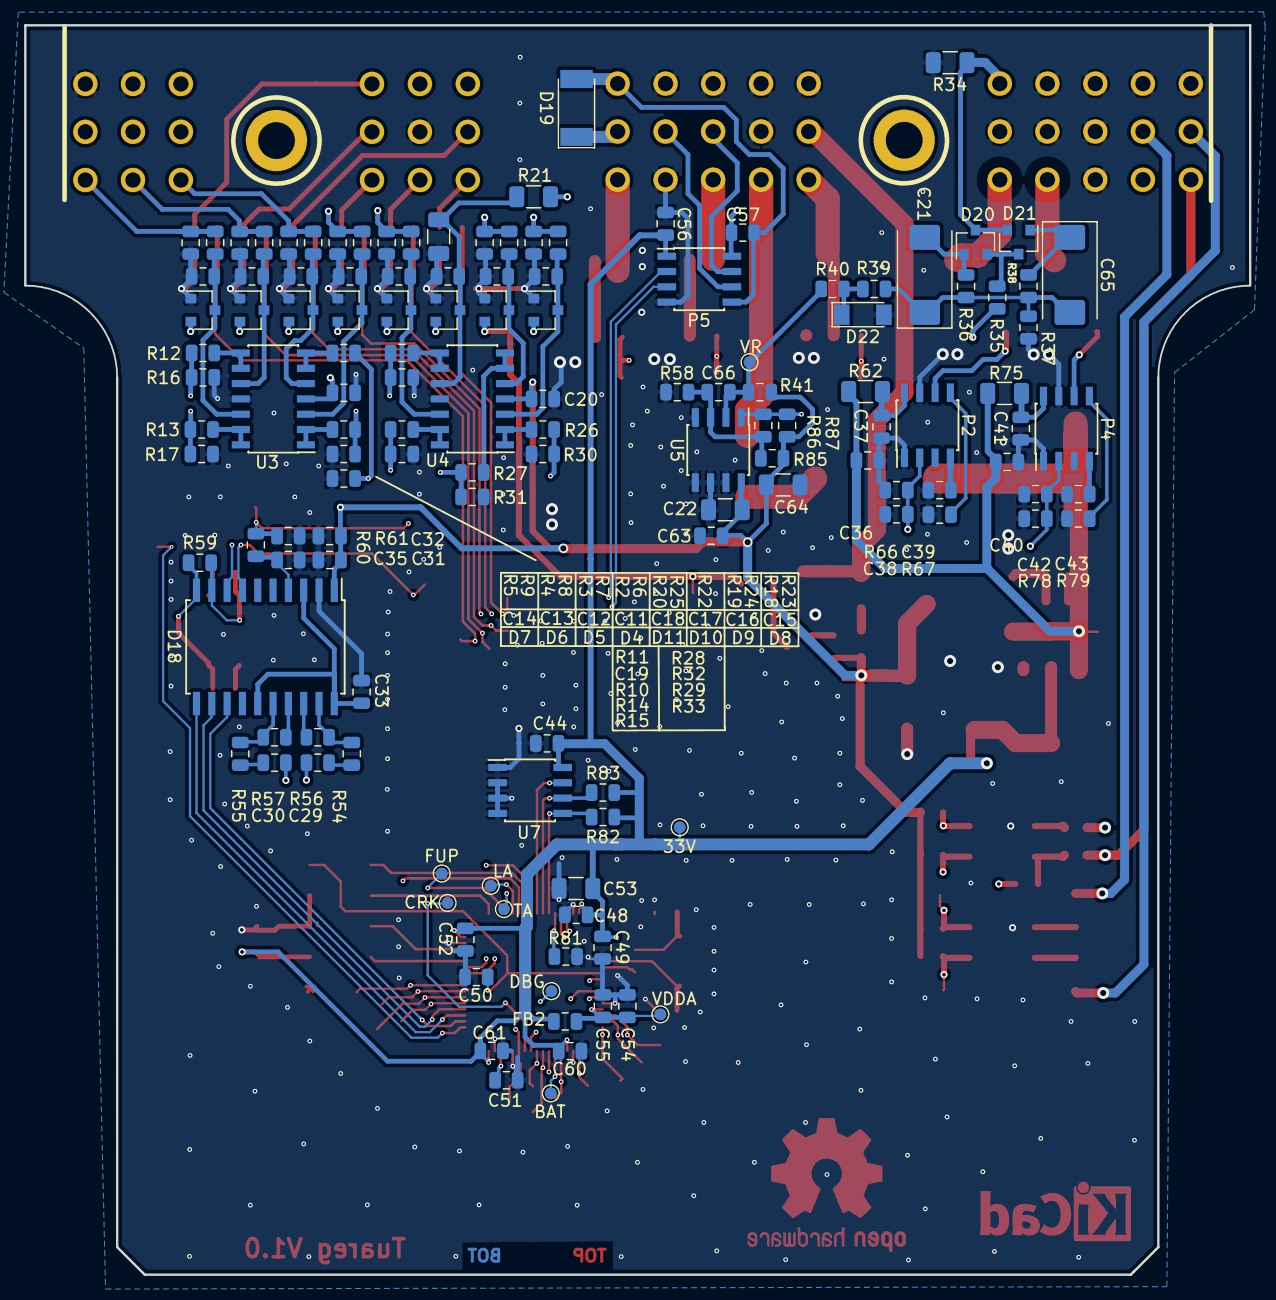
[picture p59: board Tuareg.kicad_pcb from below]

Board: 4 copper layers, 101.6 x 103.6 mm, 233 parts (133 on the bottom side), 131 nets.

Other parts of the board:
5V, 5VC, 12V, 33V: TestPoint_Pad_D1.0mm
BAT: TestPoint_Pad_D1.0mm
CH1, CH2, CH3, CH4, CH5, CH6, CH8: TestPoint_Pad_D1.0mm
CO1, CO2: TestPoint_Pad_D1.0mm
CR: TestPoint_Pad_D1.0mm
CRK: TestPoint_Pad_D1.0mm
DBG: TestPoint_Pad_D1.0mm
DS1, DS2: TestPoint_Pad_D1.0mm
FUP: TestPoint_Pad_D1.0mm
IJ1, IJ2: TestPoint_Pad_D1.0mm
KN: TestPoint_Pad_D1.0mm
KNC: TestPoint_Pad_D1.0mm
KNI: TestPoint_Pad_D1.0mm
LA: TestPoint_Pad_D1.0mm
RN: TestPoint_Pad_D1.0mm
SA1, SA2: TestPoint_Pad_D1.0mm
TA: TestPoint_Pad_D1.0mm
VDDA: TestPoint_Pad_D1.0mm
VR: TestPoint_Pad_D1.0mm
cam: TestPoint_Pad_D1.0mm

Their connections:
+3V3: 33V.1; also elsewhere on the board
+5V: 5V.1; also elsewhere on the board
+12V: 12V.1; also elsewhere on the board
/COIL1: CO1.1; also elsewhere on the board
/COIL2: CO2.1; also elsewhere on the board
/FUELP: FUP.1; also elsewhere on the board
/INJ1: IJ1.1; also elsewhere on the board
/INJ2: IJ2.1; also elsewhere on the board
/LAMP: LA.1; also elsewhere on the board
/TACH: TA.1; also elsewhere on the board
/ach1: CH1.1; also elsewhere on the board
/ach2: CH2.1; also elsewhere on the board
/ach3: CH3.1; also elsewhere on the board
/ach4: CH4.1; also elsewhere on the board
/ach5: CH5.1; also elsewhere on the board
/ach6: CH6.1; also elsewhere on the board
/ach8: CH8.1; also elsewhere on the board
/bat: BAT.1; also elsewhere on the board
/cam: cam.1; also elsewhere on the board
/cpu/pwr_vdda: VDDA.1; also elsewhere on the board
/crank: CRK.1; also elsewhere on the board
/crash: CR.1; also elsewhere on the board
/debug: DBG.1; also elsewhere on the board
/din_spare1: DS1.1; also elsewhere on the board
/din_spare2: DS2.1; also elsewhere on the board
/knock: KN.1; also elsewhere on the board
/knock_cs: KNC.1; also elsewhere on the board
/knock_int: KNI.1; also elsewhere on the board
/run: RN.1; also elsewhere on the board
/spare_act_1: SA1.1; also elsewhere on the board
/spare_act_2: SA2.1; also elsewhere on the board
unnamed 113: VR.1; also elsewhere on the board
pwr_5v_clamp: 5VC.1; also elsewhere on the board
