kanavkin/Tuareg_hw/(commit log)

2019-01-18 cleaned repository
    [Tuareg.kicad_pcb, Tuareg.sch, actuators.sch, analog_in.sch, connector.sch, cpu.sch, digital_in.sch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]
2019-01-19 uploaded the local working directory
    [Tuareg.kicad_pcb, Tuareg.sch, actuators.sch, analog_in.sch, connector.sch, cpu.sch, digital_in.sch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]
2019-01-19 not needed
    [transfer.sch]
2019-05-22 added denso tndf13 ecu files
    [cranking_idle_warm_engine.csv, cranking_warm_engine.csv, cranking_warm_engine_2.csv, running.csv, running.ods, running_max.csv, simulator.csv, timing.csv]
2019-06-02 added schematics
    [tndf13.sch]
2019-06-02 prepared schematics
2019-06-03 working on schematics
    [tndf13.sch]
2019-06-10 changed to discrete crank vr sensor cirquitry
    [Tuareg.kicad_pcb, Tuareg.sch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]
2019-06-13 added kicad library as submodule
2019-06-19 fixed references to old kicad lib
    [Tuareg.kicad_pcb, analog_in.sch]
2019-06-22 migration to kicad 5.1.2
    [Tuareg.kicad_pcb, Tuareg.sch, actuators.sch, analog_in.sch, cpu.sch, digital_in.sch, knock.sch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]
2019-06-22 routing discrete vr interface TODO: route "crank" signal
    [Tuareg.kicad_pcb]
2019-06-28 routed crank signal
    [Tuareg.kicad_pcb]
2019-07-09 minor design improvements for first series production
    [Tuareg.kicad_pcb, Tuareg.sch, actuators.sch, analog_in.sch, cpu.sch, digital_in.sch, knock.sch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]
2019-07-20 cleaning up
    [Tuareg.kicad_pcb, Tuareg.sch]
2019-07-27 running connection check
    [Tuareg.kicad_pcb]
2019-07-28 cleaning up bottom layer
    [Tuareg.kicad_pcb]
2019-07-29 cleaning up fab layers
    [Tuareg.kicad_pcb]
2019-08-15 added aisler design rules, cleaning up
    [Tuareg.kicad_pcb]
2019-08-21 added test points and cleaning up silk screen
    [Tuareg-B_Cu.gbr, Tuareg-B_Fab.gbr, Tuareg-B_Mask.gbr, Tuareg-B_Paste.gbr, Tuareg-B_SilkS.gbr, Tuareg-Edge_Cuts.gbr, Tuareg-F_Cu.gbr, Tuareg-F_Fab.gbr]
2019-08-21 corrected silk screen and fab layers
    [Tuareg.kicad_pcb]
2019-08-24 created interacive bom, bom, updated pdf schematics
    [Tuareg-B_Cu.gbr, Tuareg-B_Fab.gbr, Tuareg-B_Mask.gbr, Tuareg-B_Paste.gbr, Tuareg-B_SilkS.gbr, Tuareg-Edge_Cuts.gbr, Tuareg-F_Cu.gbr, Tuareg-F_Fab.gbr]
2019-09-04 working on bom for parts to order
    [sources_list.ods]
2019-09-06 added missing component values working on BOM
    [actuators.sch, analog_in.sch, cpu.sch, digital_in.sch, knock.sch, power_supply.sch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]
2019-09-09 cleaned BOMs
    [Tuareg.sch, Tuareg_v1_mouser.csv, actuators.sch, analog_in.sch, bom.csv, bom_grp.csv, cpu.sch, digital_in.sch]
